oelprinz-org/BlitzboxBL49sp/software/202402.1/README.md

### Corrected firmware as there was a bug in pin definition for boost output<br/>
<br/>
will be corrected in next official speeduino firmware.<br/>
Until then you can use this precompiled firmware from here.<br/>
