oelprinz-org/BlitzboxBL49sp/documentation/wiki/images/mainconnector.jpg

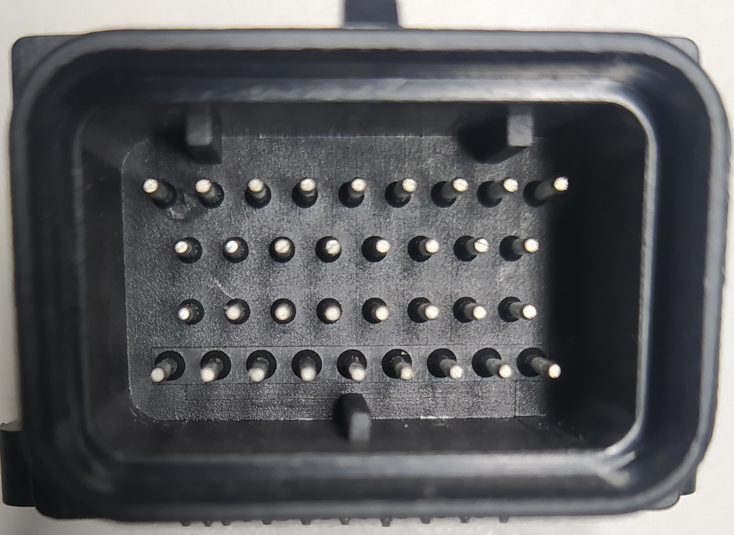
documentation/wiki/images/mainconnector.jpg
