oelprinz-org/BlitzboxBL49sp/documentation/wiki/images/pinheader1.jpg

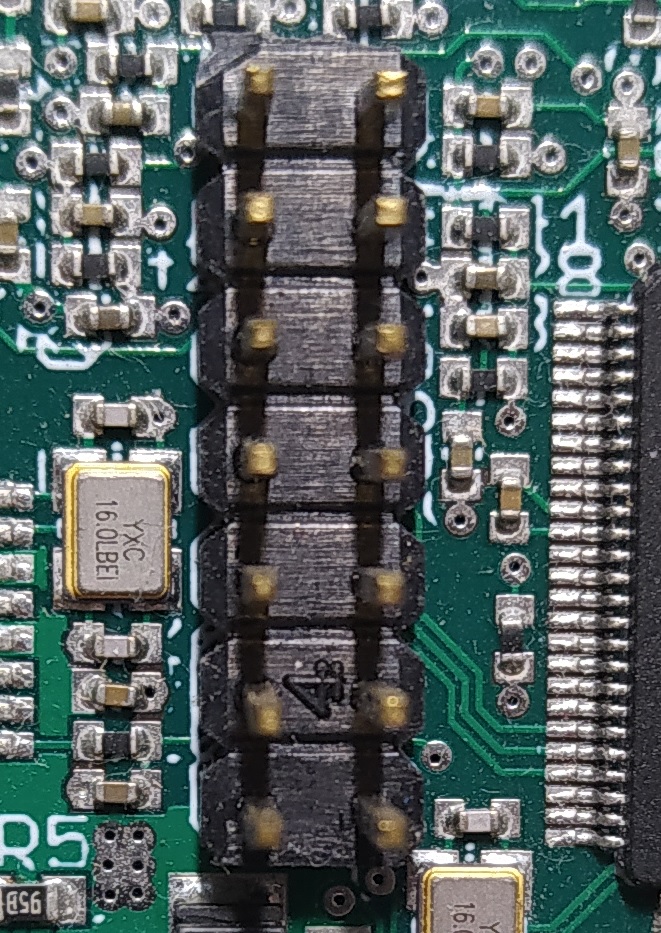
documentation/wiki/images/pinheader1.jpg
