oelprinz-org/BlitzboxBL49sp/documentation/wiki/images/pinheader2.jpg

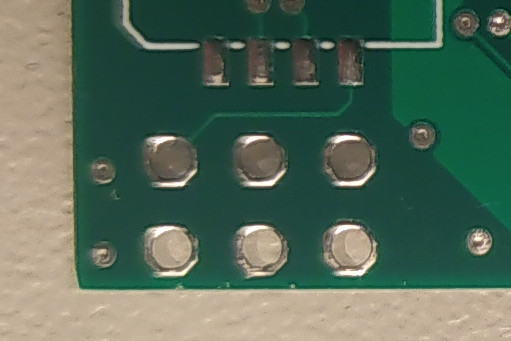
documentation/wiki/images/pinheader2.jpg
