oelprinz-org/BlitzboxBL49sp/hardware/Rev0.0.4a/2020-08-18_15-27-23_BlitzboxBL49sp-master_.png

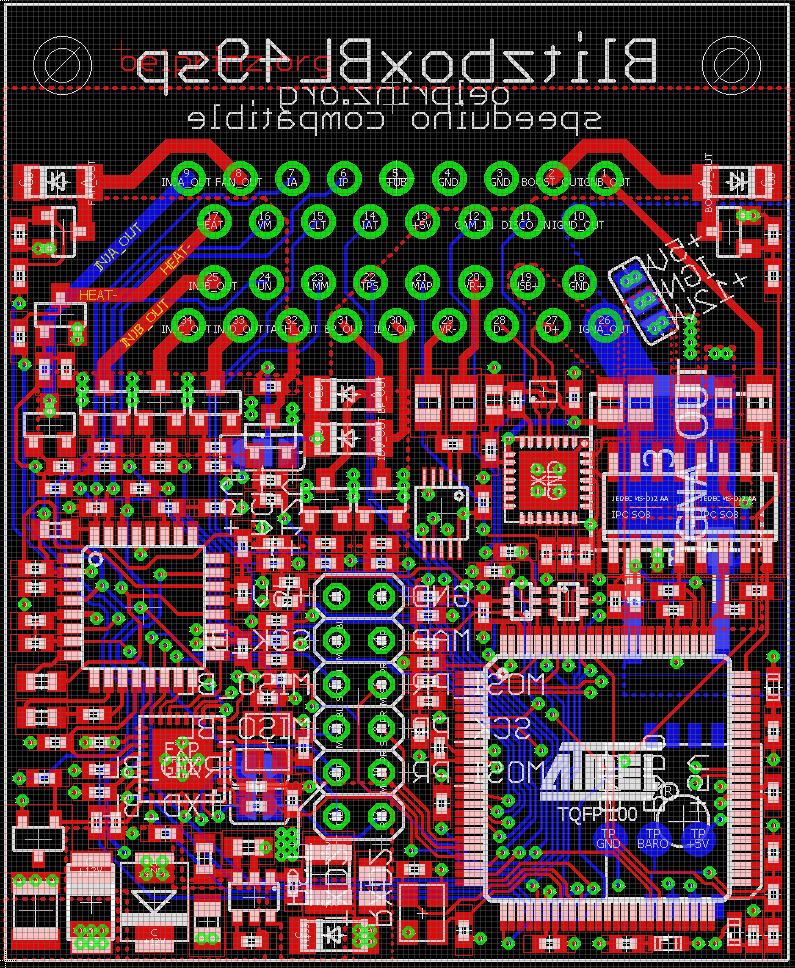
hardware/Rev0.0.4a/2020-08-18_15-27-23_BlitzboxBL49sp-master_.png
