oelprinz-org/BlitzboxBL49sp/hardware/Rev0.0.4b/2020-08-26_13-27-23_BlitzboxBL49sp-master_.png

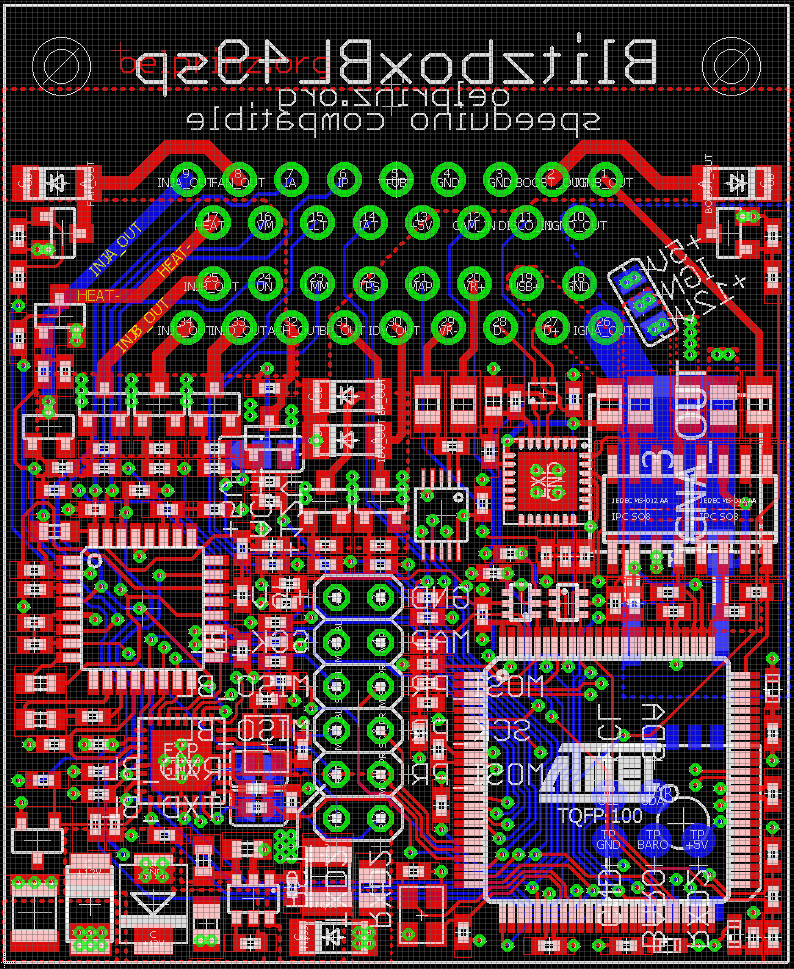
hardware/Rev0.0.4b/2020-08-26_13-27-23_BlitzboxBL49sp-master_.png
