oelprinz-org/BlitzboxBL49sp/hardware/Rev0.0.4c/2020-08-30_21-38-23_BlitzboxBL49sp-master_.png

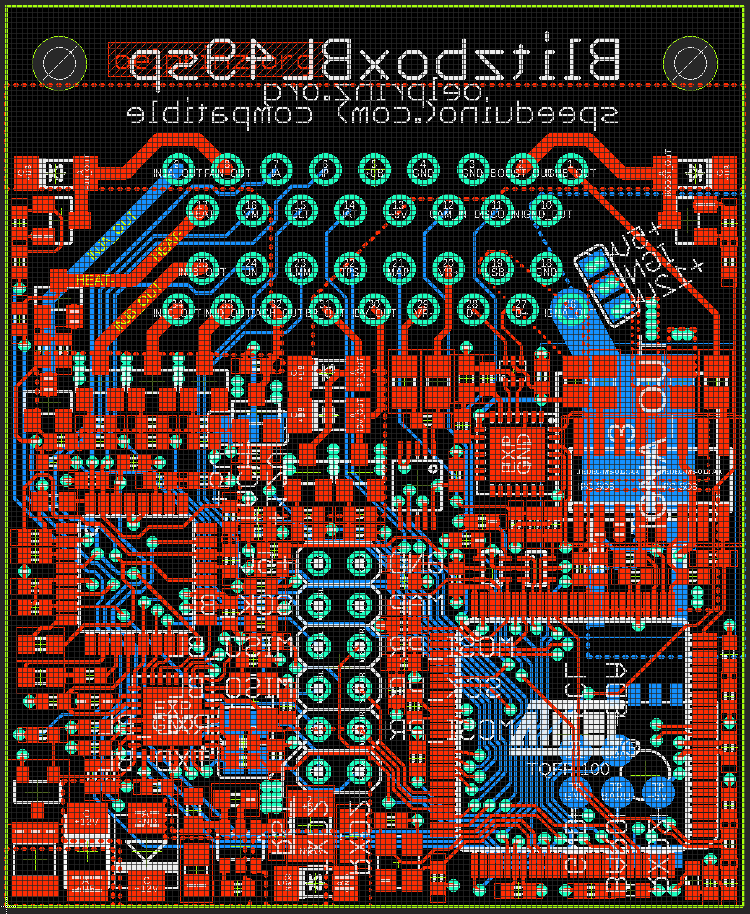
hardware/Rev0.0.4c/2020-08-30_21-38-23_BlitzboxBL49sp-master_.png
