oelprinz-org/BlitzboxBL49sp/case/blitzbox_gehäuse_2.stl

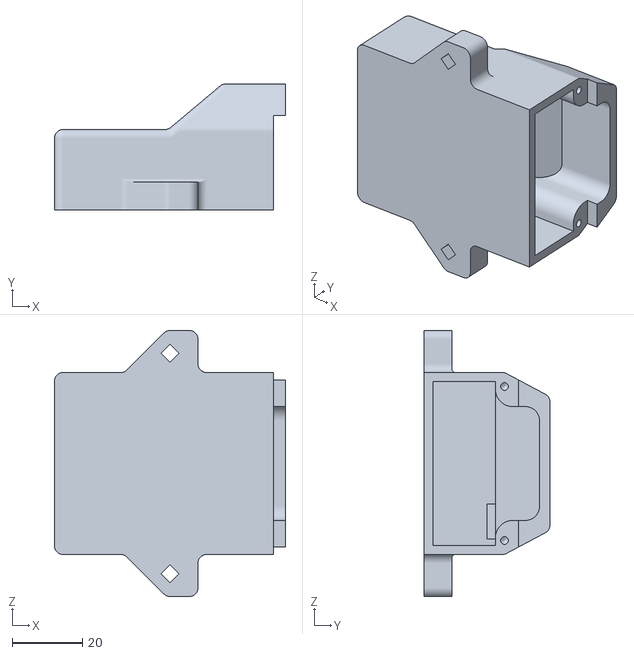
[picture p18: CAD file, 2023-03-01]
case/blitzbox_gehäuse_2.stl
66.0 x 36.0 x 76.0
