oelprinz-org/BlitzboxBL49sp/case/blitzbox_blech_2.stl

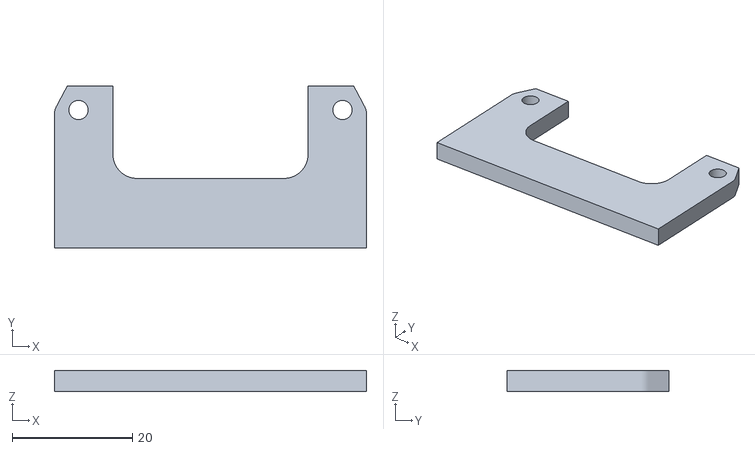
[picture p19: CAD file, 2023-03-01]
case/blitzbox_blech_2.stl
52.0 x 27.0 x 3.50
