oelprinz-org/BlitzboxBL49sp/case/bl_deckel_2.stl

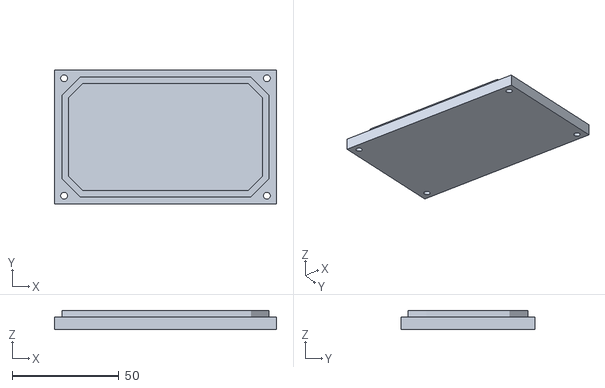
[picture p20: CAD file, 2023-03-01]
case/bl_deckel_2.stl
104.0 x 63.0 x 9.00
