oelprinz-org/BlitzboxBL49sp/case/bl_gehäuse_2.stl

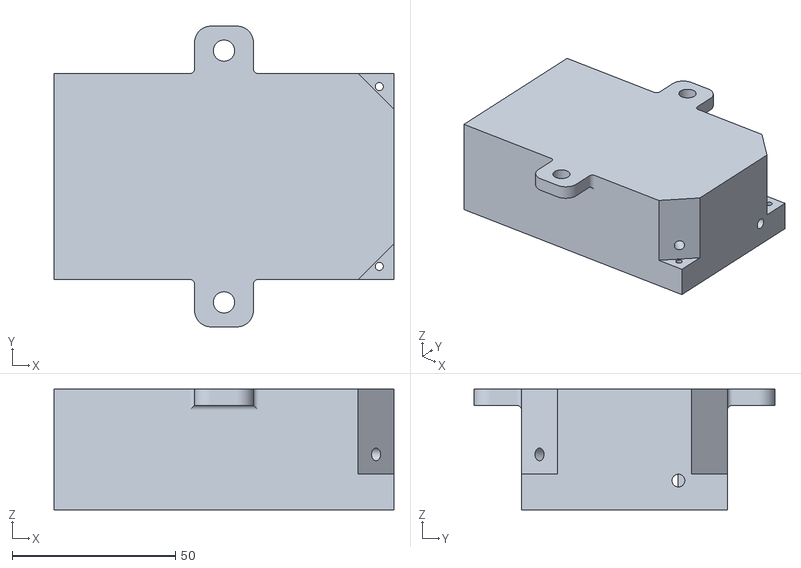
[picture p21: CAD file, 2023-03-01]
case/bl_gehäuse_2.stl
104.0 x 92.0 x 37.0
