oelprinz-org/BlitzboxBL49sp/(threads)

Thread 1 (2020-09-27):

Capacitor C29 too large in V0.0.6

chaoschris, 2020-09-27:
Capacitor C29 has been chosen too large in V0.0.6 (100nF).
For this reason ISP will not work on the Atmega2560. ISP on Atmega328P is working fine with this value.
Will be replaced with 18 pF in next version.

chaoschris, 2020-09-30:
Fixed in V0.0.7

chaoschris, 2020-09-30:
Can be fixed in V0.0.6 with a smaller capacitor like 18 pF or simply remove C29

Closed 2020-09-30.

Thread 2 (2020-11-27):

any updates?

rusefillc, 2020-11-27:
Are there any forum threads/build threads with updates? How is it going?

chaoschris, 2020-12-23:
the only forum thread to this device is on the speeduino forum:
http://speeduino.com/forum/viewtopic.php?f=16&t=2900
But there is not really more information than here...

Closed 2021-07-14.

Thread 4 (2022-04-25):

[temporary solved] V 0.1.2 pcb routing issue on TPS

chaoschris, 2022-04-25:
V0.1.2 has a pcb routing issue on TPS signal.
Can be fixed manually and will be corrected in next/final version

chaoschris, 2022-08-26:
solved in V0.1.3

Closed 2022-08-26.

Thread 5 (2022-04-25):

[temporary solved] V 0.1.2 speeduino firmware stops working when pulling the USB plug

chaoschris, 2022-04-25:
V 0.1.2 speeduino firmware stops working when pulling the USB plug.
With the USB plug connected all works fine

SW65, 2022-04-25:
Und was haben die als Lösung?

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

chaoschris, 2022-04-25:
Shutting down the power supply of the Cp2102 converter chip leads to a constant voltage level of 0 V on the RX line of the Atmega2560. This can be fixed temporary with a 10k Pullup from RX to +5V as shown in the picture. Further investigation will follow soon before the next/final pcb revision.
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

SW65, 2022-04-25:
Lösung ist halt ohne Zigarettenanzünder mit usb Kabel und kleiner:-)
Liegt nicht an der Firmware?

Melde mich später mal .

Grüße Jörg

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

chaoschris, 2022-04-25:
Doesn't look like a firmware issue. The original Arduino Mega 2560 design also has two inline resistors with 1K on RX and TX. Will have a deeper look on this later.

chaoschris, 2022-08-26:
solved in V0.1.3

chaoschris, 2022-08-26:
solved in V0.1.3

Closed 2022-08-26.

Thread 6 (2023-02-28):

Would it be possible to get a "how to order" guide?

runesmdk, 2023-02-28:
I've tried uploading the 0.1.4 to jlcpcb, and both the bom and the cpl, but i get so many errors i cannot order it. I must be doing something wrong ofcourse, but i'm no whiz in the world of PCB. Is it possible to get a step-by-step helping hand in ordering it?

chaoschris, 2023-02-28:
done in the speeduino forum:
https://speeduino.com/forum/viewtopic.php?p=61556#p61556

runesmdk, 2023-03-01:
I dont know how i missed that. But what is missing with r21,r23, r40 and ic3, is that only the wideband controller with the cj125 or are other systems affected as well?

chaoschris, 2023-03-01:
You don't missed it, i made it specially for you... ;-) . But this information could be also useful for others, so i decided to publish it on the forum.
R21 is a pullup and optional. This is the wire which enables the heating of the Lambda sonde via programmable output.
R23 is a Varistor which should be added manually. JLC has nothing in stock to solder on here
R40 a optional BIAS resistor if you decide to use the analog input ADD_LMM with a temperature sensor
IC3 is the Wideband Bosch CJ125 (30522, 30615 or 40103). Must be soldered by hand as JLC cannot provide it for assemby

runesmdk, 2023-03-01:
I am very honered, thank you. How will it heat without the pullup, just always on?
Where do you buy the CJ125?

chaoschris, 2023-03-01:
The lambda controller will be enabled with a ground signal. you have to program this this feature with a rule in TunerStudio (programmable outputs). You can define two conditions here. one would be RPM greater than XXX and/or engine temperature greater than YY. Both conditions also allow to define an additional time delay.

chaoschris, 2023-03-01:
I am buying the CJ125 always in China or unsolder them from old parts/ECUs......  ;-)
Bosch 30522 is working fine and should be easy to find and also cheap

Closed 2023-03-14.

Thread 7 (2023-03-16):

stepper idle motor

Giulio-Luiz-Valcanaia, 2023-03-16:
First thing: congratulations on the project, it is really good. Second thing: Any chance of adding stepper motor support?

chaoschris, 2023-03-16:
There ist absolutely no space  top add stepper support on this board. If you really need a stepper you can use the upcoming Gewitterbox design here in our GitHub repository when it is ready for production some day.

Ricardo29410, 2023-03-20:
Hello, a pleasure Ricardo Rodríguez I'm from Venezuela and your plate
really catches my attention and I want to try both models

El dom, 19 de mar. de 2023 4:17 p. m., chaoschris ***@***.***>
escribió:

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

Closed 2023-03-19.

Thread 9 (2023-09-08):

Missing wideband controller?

abreumatheus, 2023-09-08:
Hi, first thank you for your amazing work on this.
I noticed the bosch wideband controller chip is missing on the bom.
Is it ok to order it sepparetly and solder it by hand?

Greetings from Brazil.

chaoschris, 2023-09-08:
Ola Matheus,
JLC nao vai soldar este CJ125 na placa pq eles nao oferece algumes partes especial, mesmo se era possivel de comprar as pecas anterior. Entao vc tenho de soldar este peca....
Um abraco
Chris

abreumatheus, 2023-09-08:
Thank you for the heads up!
Muito obrigado! 😁

Closed 2023-09-08.

Thread 10 (2023-09-13):

What board to select in tunerstudio?

runesmdk, 2023-09-13:
There's no blitzbox in the dropdown menu of boards

chaoschris, 2023-09-13:
Hi Rune,
You must use the modified speeduino.ini from

https://github.com/oelprinz-org/BlitzboxBL49sp/tree/master/software/202305/changes/speeduino.ini
or
https://github.com/oelprinz-org/BlitzboxBL49sp/tree/master/software/202305/reference/speeduino.ini

both are the same

Best regards,
Chris

runesmdk, 2023-09-13:
Thank you. How to upload the firmware when it comes in hex and bin format?
I usually just use speedyloader :D

Den ons. 13. sep. 2023 kl. 09.18 skrev chaoschris ***@***.***
>:

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

chaoschris, 2023-09-13:
There is no way to upload it with the speedyloader until the blitzbox will be added to the official firmware tree. But also when this is done you need to upload a bootloader in your 2560. So for the moment you need a tool to upload the firmware manually. You can do this with any tool of your choice like usbasp, tinyisp or any cheap arduino board acting as a ISP.

chaoschris, 2023-09-13:
You also need to program the 328p for the lambda controller the same way, so you will really need one of these really cheap programmers. I prefer the usbasp and AVRDUDESS as GUI which is really easy to handle and also works well
https://blog.zakkemble.net/avrdudess-a-gui-for-avrdude/

runesmdk, 2023-09-13:
Okay. I will have to dig into this, never tried it. Have an external wideband controller, so gonna have a look at available pins in the init. When and how does the fuse-programming work, is that while using the isp programmer?

chaoschris, 2023-09-13:
Yes, you can do these settings easily with the same tools you are using to flash the MCU.
Have a look on the Homepage of AVRDUDESS at https://blog.zakkemble.net/avrdudess-a-gui-for-avrdude/  .
There is a picture of the GUI, with this tool it is really easy-going to program the MCUs.
If you don't want to spend 2 or 3 dollars for a programmer you can use any available Arduino Board and use it as a ISP programmer. There is plenty of information on the web how to do this,one example here:
https://docs.arduino.cc/built-in-examples/arduino-isp/ArduinoISP

chaoschris, 2023-09-26:
Best practice would be to flash the entire flash with the included bootloader:
ttps://github.com/oelprinz-org/BlitzboxBL49sp/blob/master/software/202305/blitzboxBL49sp_firmware_speeduino-202305_with_bootloader.bin
or
https://github.com/oelprinz-org/BlitzboxBL49sp/blob/master/software/202305/blitzboxBL49sp_firmware_speeduino-202305_with_bootloader.hex

chaoschris, 2023-09-26:
You are talking about the 2560 or the 328P for the lambda?

runesmdk, 2023-09-26:
> You are talking about the 2560 or the 328P for the lambda?
2560. But i managed to get it working, wrote a how-to on how i did on the speeduino forum.

Closed 2023-10-11.

Thread 11 (2023-10-05):

RC/ UAV engine compatibility

professor-jonny, 2023-10-05:
Hi I'm wondering if this could be project could be adapted to accept a 0-5v 50hz PWM input as an electronic throttle and provide a 0-5v 50hz PWM output the same for throttle position control by simply repurposing inputs and outputs without major board changes?

The usage would be used accept a RC throttle control PWM input from the transmitter and provide a PWM output to control the throttle servo.
This would negate the need for TPS as we know the position, it would be otherwise impractical to provide this signal as it would be hard to find of the shelf throttle components suitable for RC/ UAV engine sizes.

In normal cases it would pass through the throttle servo signal direct to the digital servo controlling the throttle, but if comms were lost it would set a pre-determined throttle position for safety or kill the engine.

Would you be at some stage manufacturing / selling this as a kit?

chaoschris, 2023-12-12:
Hello professor-jonny,
unfortunately the project is published as it is and there are no plans to change it in any way. There also wouldn't be no place on the pcb for your planned modifications.
All the needed files for manufacturing are published in the folder "fabrication" and it is easy for everyone to let them build by your preferred manufacturer.
There is also no intention to sell it in any commercial way.

chaoschris, 2023-12-12:
closed as there are no plans to change it in any way

Closed 2023-12-12.

Thread 13 (2024-04-24):

PN of MainConnector

Marcelocm1995, 2024-04-24:
Hi, I'm doing this project and I need de part number or link to buy the MainConnector, I did not found inside documentation.

Best Regards

chaoschris, 2024-04-25:
Ola Marcelo,

todas as informacoes que vc precisa vc vai encontrar no blogue/forum do speeduino:
https://speeduino.com/forum/viewtopic.php?p=61573#p61573

Para completar o conector este pagina ai pode ajudar:   http://www.oelprinz.org/products/BlitzboxBL49sp/documentation/V0.1.4/wiki/pinout_V0.1.4_Connector_top_side.html

Vc pode me respostar em portugues tambem, e sem pro para mim....

Marcelocm1995, 2024-04-25:
Que legal, parabens pelo projeto. E muito obrigado! Vc poderia me passar algum contato caso aceite um trabalho freelancer? Tenho uma demanda.

Grato

chaoschris, 2024-04-25:
Infelizmente esto uma pessoa privada e nao uma compania......

chaoschris, 2024-05-07:
Ola Marcelo, voce pode conferir os fuses?

No 2560 tenho de ser:
L   0xFF
H   0xD8
E   0xFD
LB  0xCF

e no 328p:
L   0xFF
H   0xDA
E   0xFD
LB  0xCF

Marcelocm1995, 2024-05-07:
Acabei de conseguir! Fazendo o seguinte:

Via Silabs integrado eu fiz um jumper entre VBUS e 5V.

Curioso via RXD TXD com FTDI nao ir, irei colocar um modulo bluetooth para testar. Seria o HC-05?

chaoschris, 2024-05-07:
>> Seria o HC-05?
Normalmente todos os modulos BT que tenho serial vai funcionar se vc vai configurar eles antes para 115200....

Marcelocm1995, 2024-05-07:
Entendi, muito obrigado. Irei comecar a testar com o TunerStudio

Closed 2024-05-07.

Thread 14 (2024-05-09):

Crank and cam input

runesmdk, 2024-05-09:
Straight from jlcpcb, is crankshaft then ready for vr or hall? What mods to swap sensor type on crank? And same for cam, what sensortype, and what mods to swap sensor type?

chaoschris, 2024-06-25:
With the soldered max9926 both inputs are ready for vr signals. In my opinion VR is the most common solution for crankshaft and the max9926 is one of the best solutions on the market for vr signals.

Camshaft input is mostly a square hall signal. But in this configuration the camshaft input can handle very well a single hall signal every 720 degrees.
- For 5V Hall input VR- should go to GND.
- If you have a 12V Hall Signal, it would be a good point to start with +5V on VR- . There is a soldering bridge on the board to do this (SJ5).

The same wiring you can apply on the crankshaft input if you want to use hall input WITH the soldered MAX9926. But here you don't have a soldering bridge onboard and you have to wire it externally or direct on the board which is easy to do.

chaoschris, 2024-08-30:
closed

Closed 2024-08-30.

Thread 15 (2024-07-22):

Launch Control doesn't work

chaoschris, 2024-07-22:
Launch Control (DISCO_IN) doesn't work.
This is a pulldown Switch to GND and for this feature going to work you need to switch R20 and R29 on the PCB.
R20 10K --> 1K
R29  1K --> 10K
Will be changed soon in manufacturing files.

chaoschris, 2024-07-23:
now fixed in schematics and BOM

chaoschris, 2024-08-30:
closed

Closed 2024-08-30.

Thread 16 (2024-07-25):

Pin definition for boost out wrong in speeduino firmware

chaoschris, 2024-07-25:
Unfortunately the pin definition for boost out is wrong in actual speeduino firmware.
This will be corrected in next official speeduino firmware.
Until then you can use the corrected firmware from:
https://github.com/oelprinz-org/BlitzboxBL49sp/tree/master/software/202402.1
If you don't use the boost out pin there is no need to change anything.

chaoschris, 2024-08-30:
fixed in next official firmware release

chaoschris, 2024-08-30:
closed

Thread 17 (2025-06-04):

Assistance with Ordering Assembled PCBs

jham4x4, 2025-06-04:
Stumbled across your build and think it would be a great ecm for a Suzuki Samurai EFI conversion I'm working on.  PCBs are new to me and I wanted to solicit your assistance with ordering assembled boards from PCBWay.  I dont know if its as simple as uploading the GBRL, bom and cpl and they do the rest.
