oelprinz-org/BlitzboxBL49sp/hardware/Rev0.1.9/blitzbox_v0.1.9.pdf

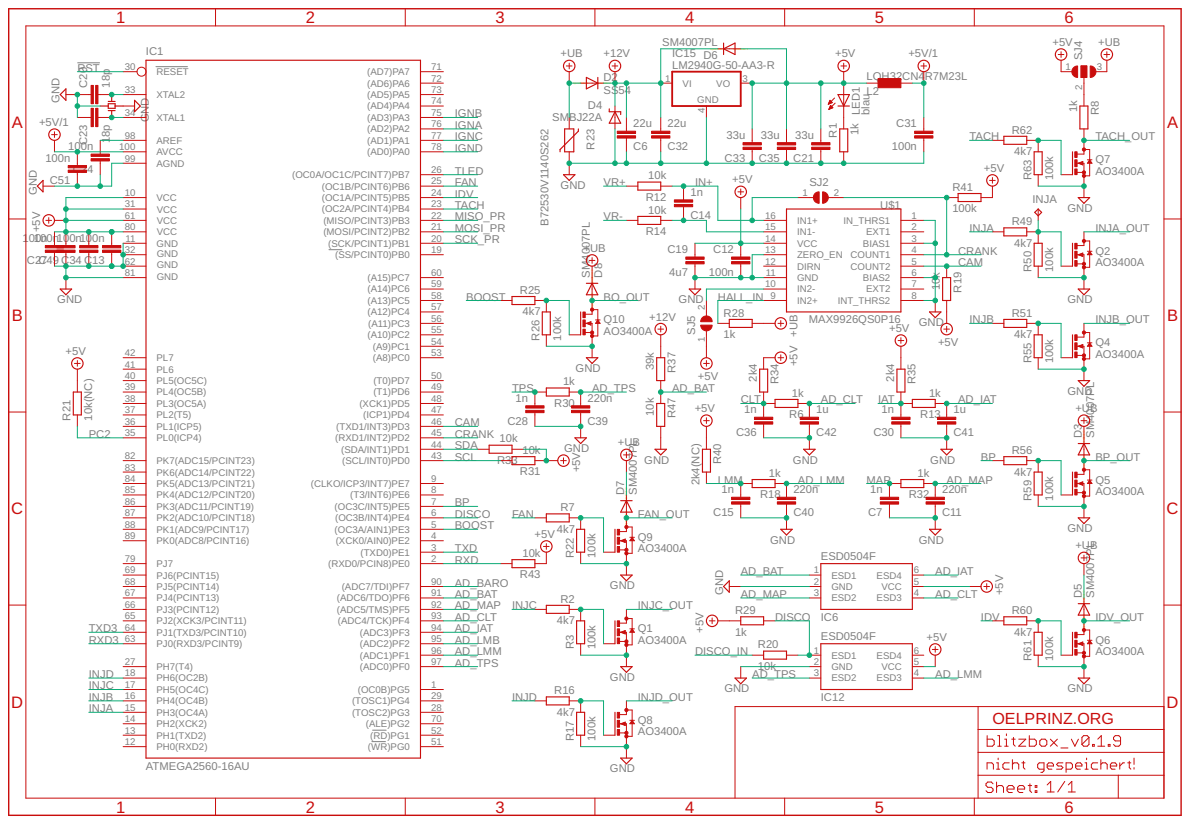
[picture p22: page 1]

SpiceOrder 1 SpiceOrder 2
BP_OUT

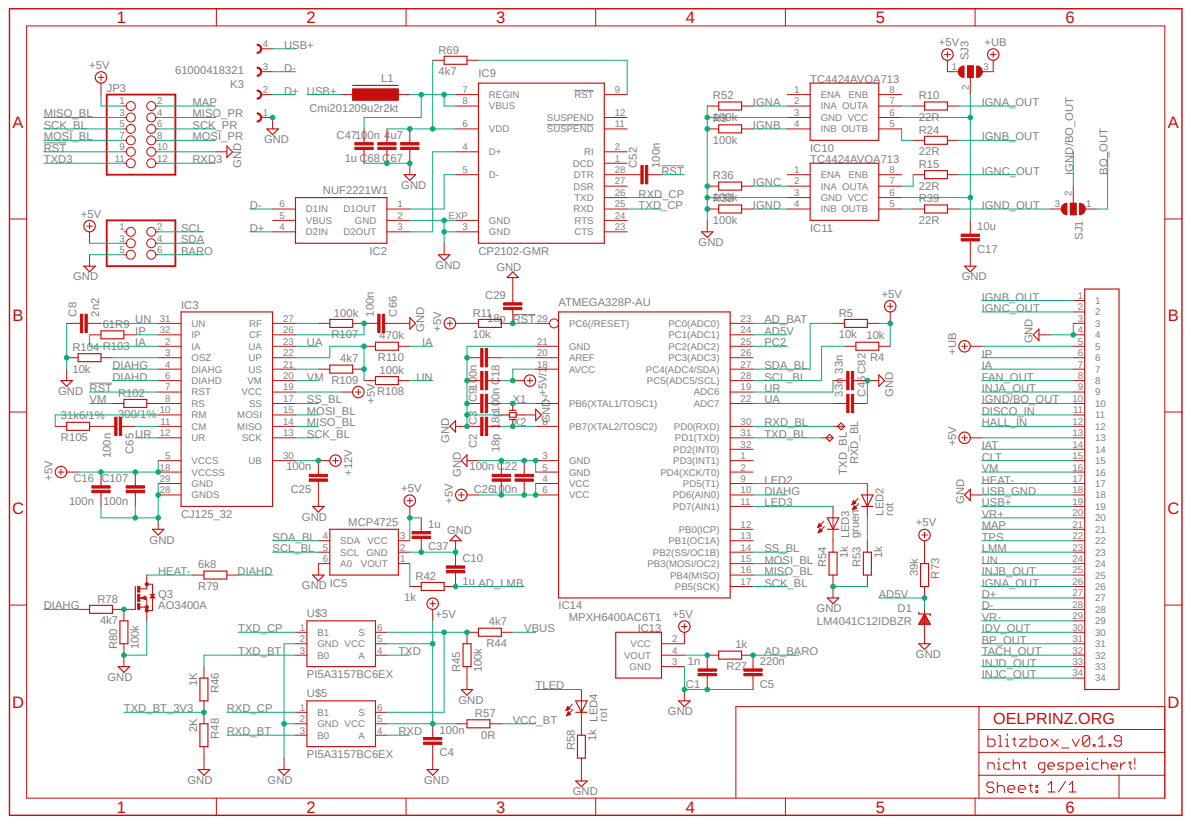
[picture p23: page 2]
