oelprinz-org/BlitzboxBL49sp/hardware/Rev0.1.8/schematics_blitzbox_v0.1.8.pdf

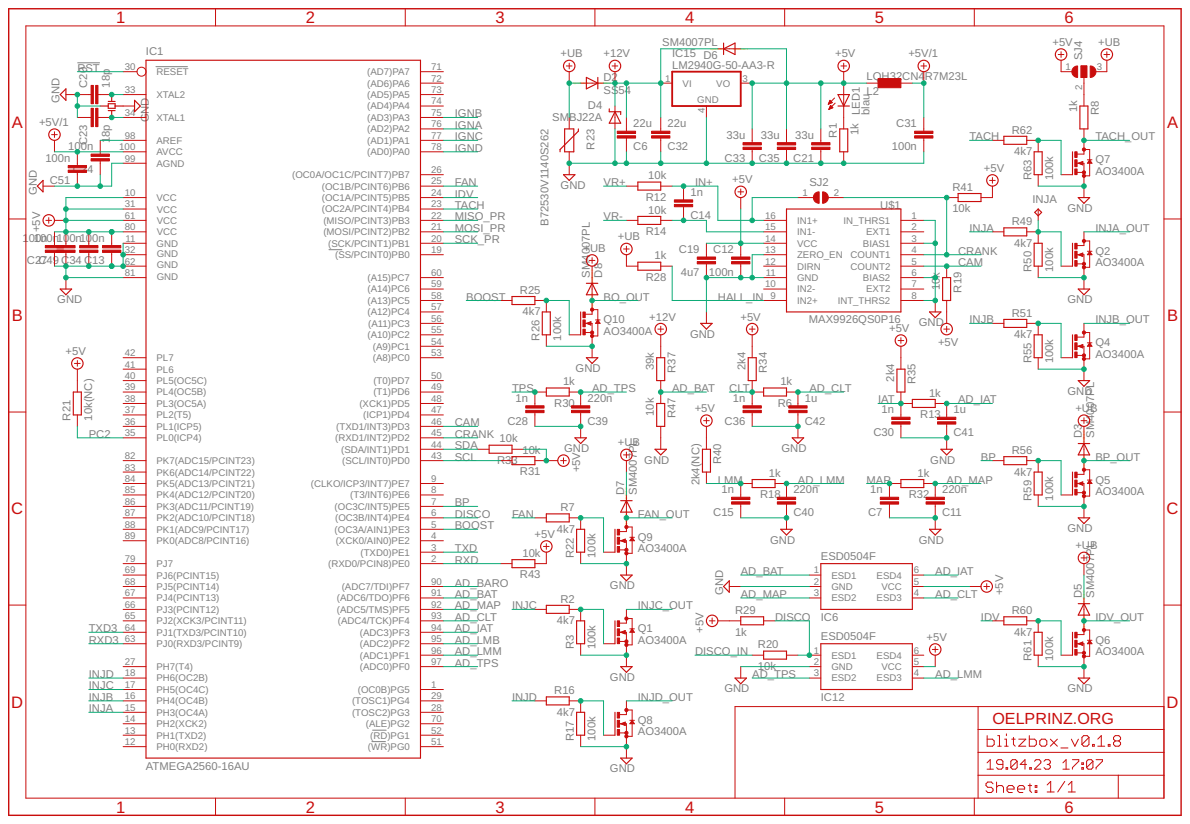
[picture p24: page 1]

SpiceOrder 1 SpiceOrder 2
BP_OUT

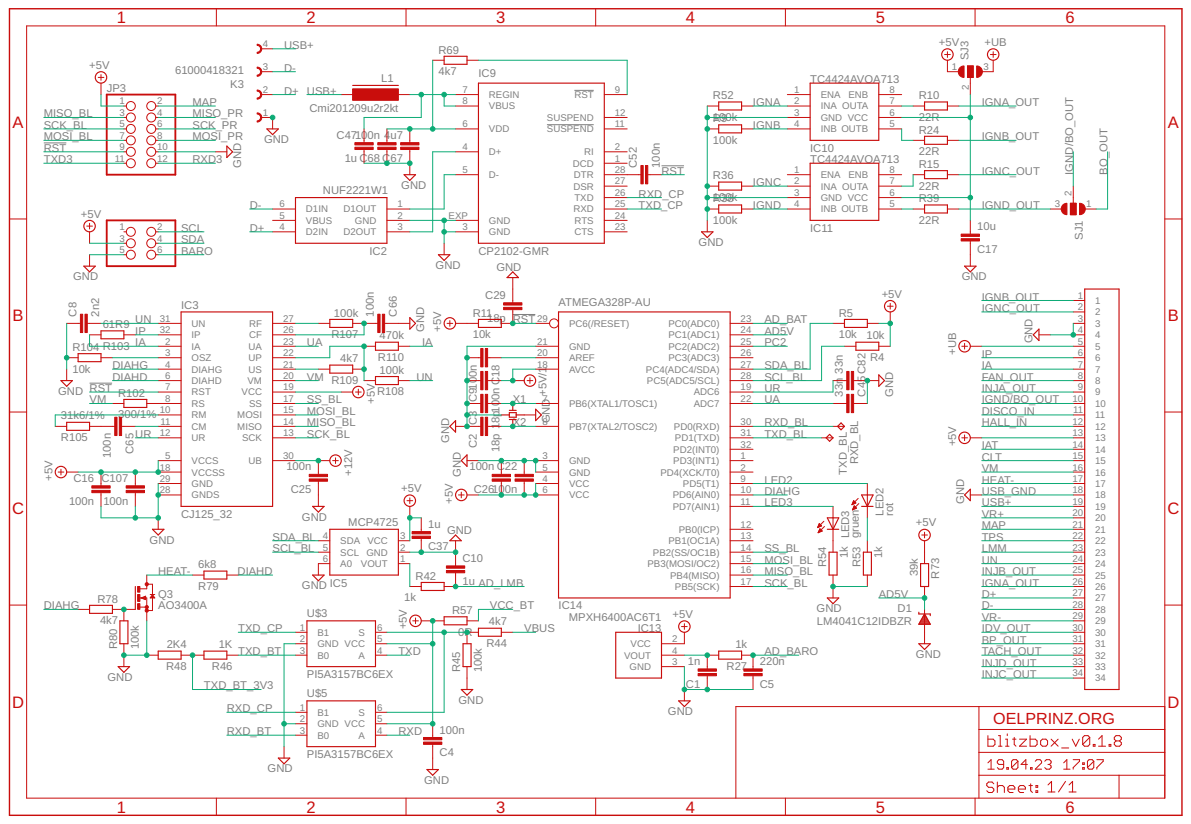
[picture p25: page 2]
