oelprinz-org/BlitzboxBL49sp/hardware/Rev0.1.7/schematics_blitzbox_v0.1.7.pdf

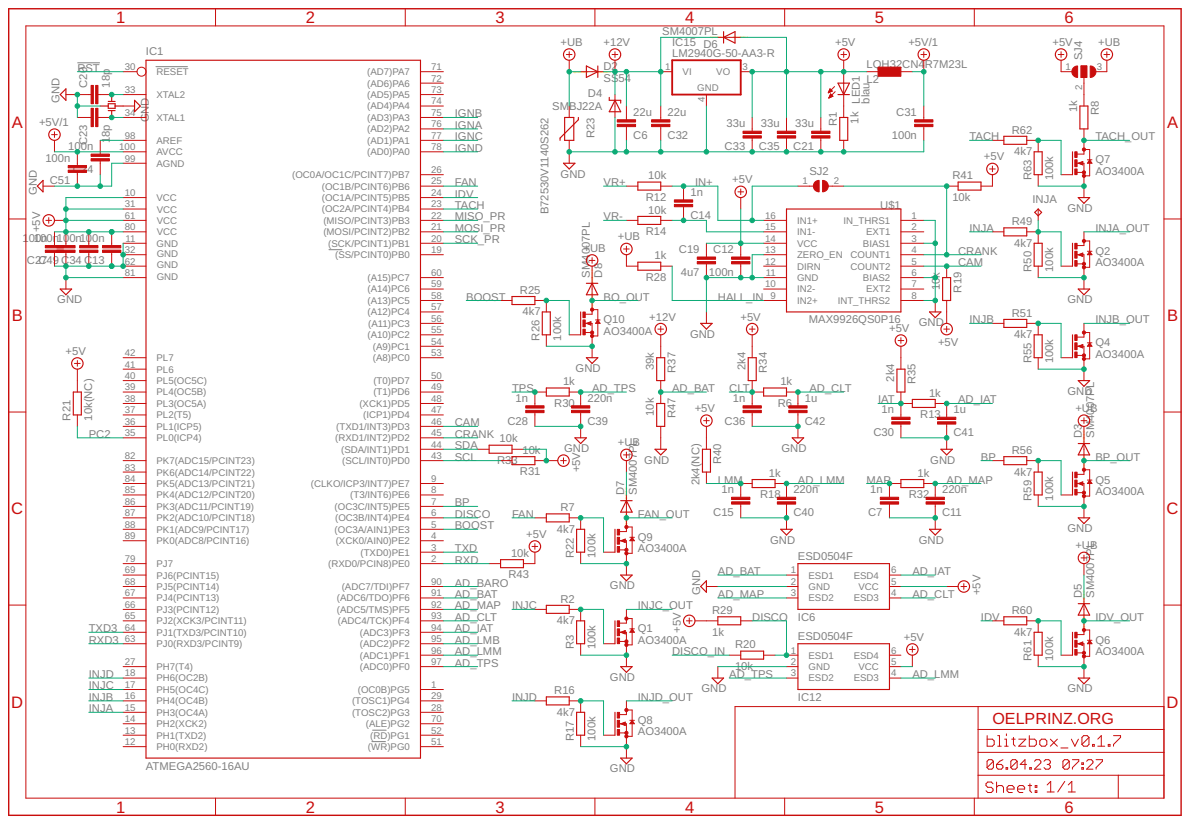
[picture p26: page 1]

SpiceOrder 1 SpiceOrder 2
BP_OUT

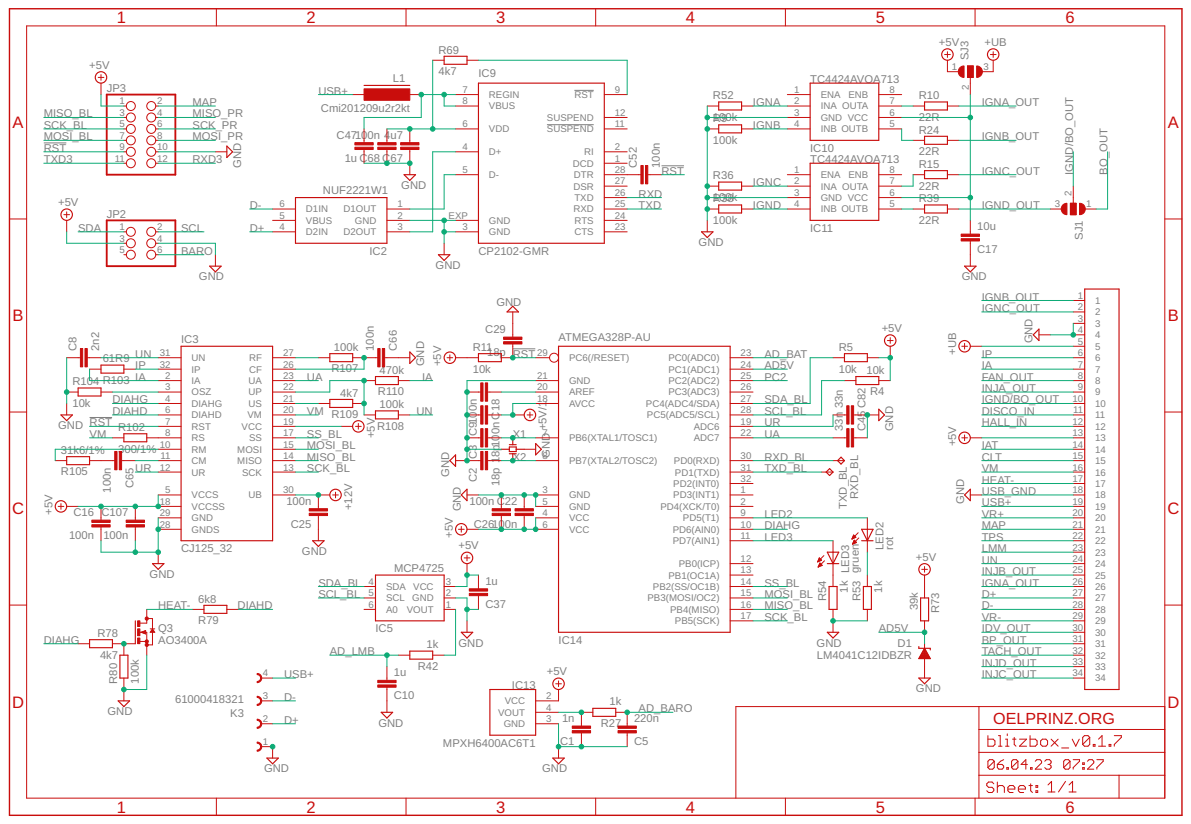
[picture p27: page 2]
