oelprinz-org/BlitzboxBL49sp/hardware/Rev0.1.6/schematics_blitzbox_v0.1.6.pdf

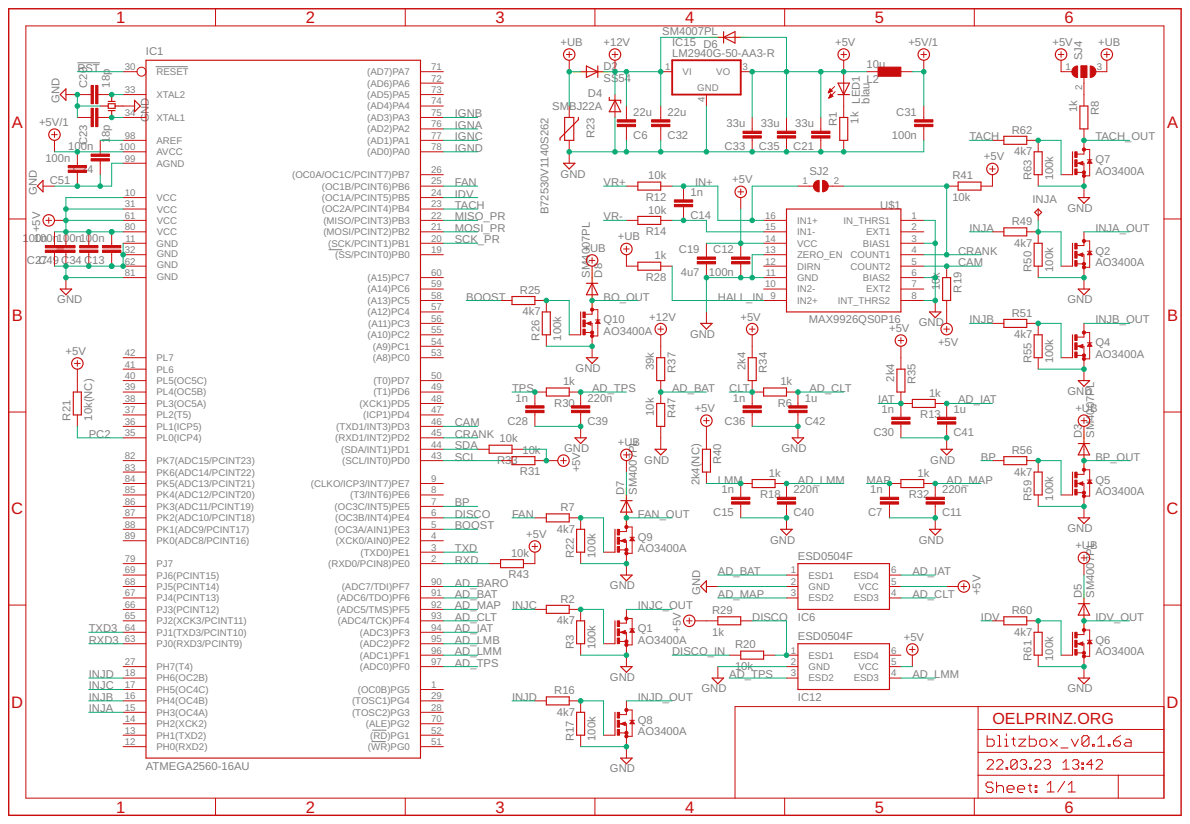
[picture p28: page 1]

SpiceOrder 1 SpiceOrder 2
BP_OUT

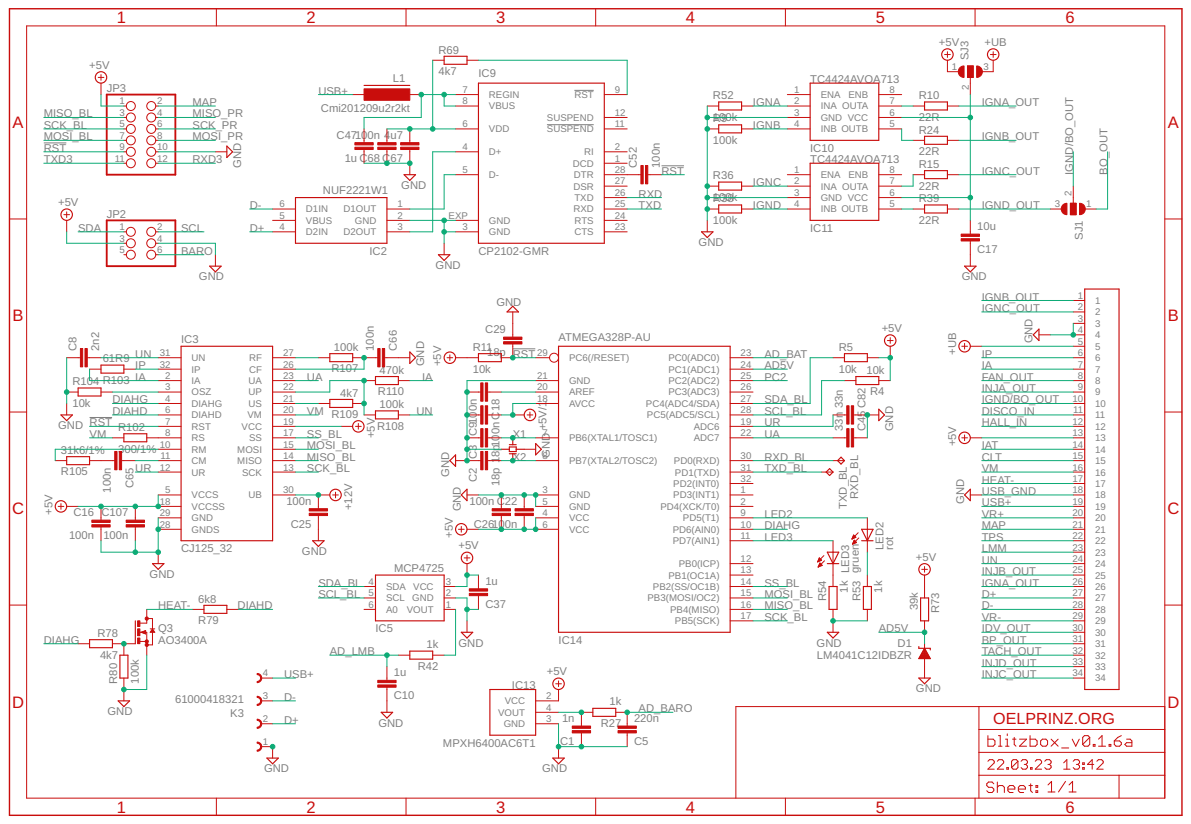
[picture p29: page 2]
