oelprinz-org/BlitzboxBL49sp/hardware/Rev0.1.5/schematics_blitzbox_v0.1.5.pdf

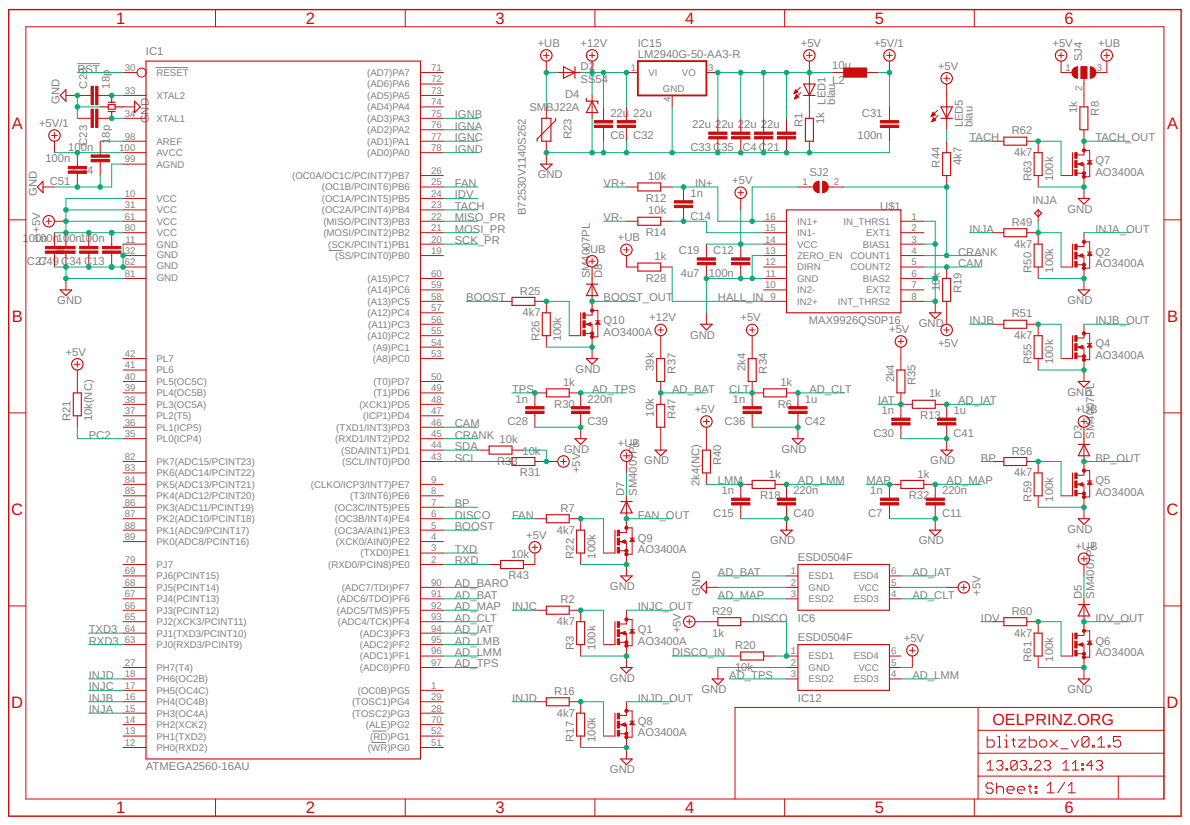
[picture p30: page 1]

SpiceOrder 1 SpiceOrder 2
BP_OUT

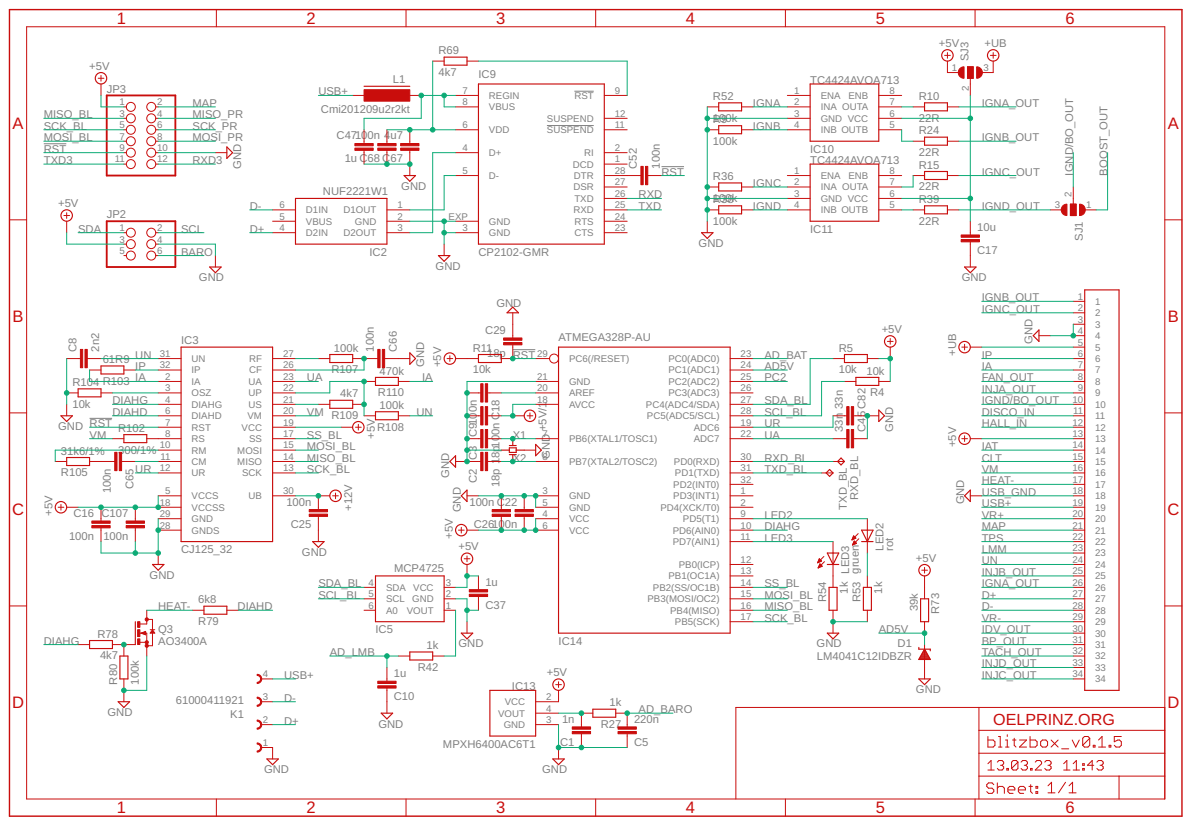
[picture p31: page 2]
