oelprinz-org/BlitzboxBL49sp/hardware/Rev0.1.4/schematics_blitzbox_v0.1.4.pdf

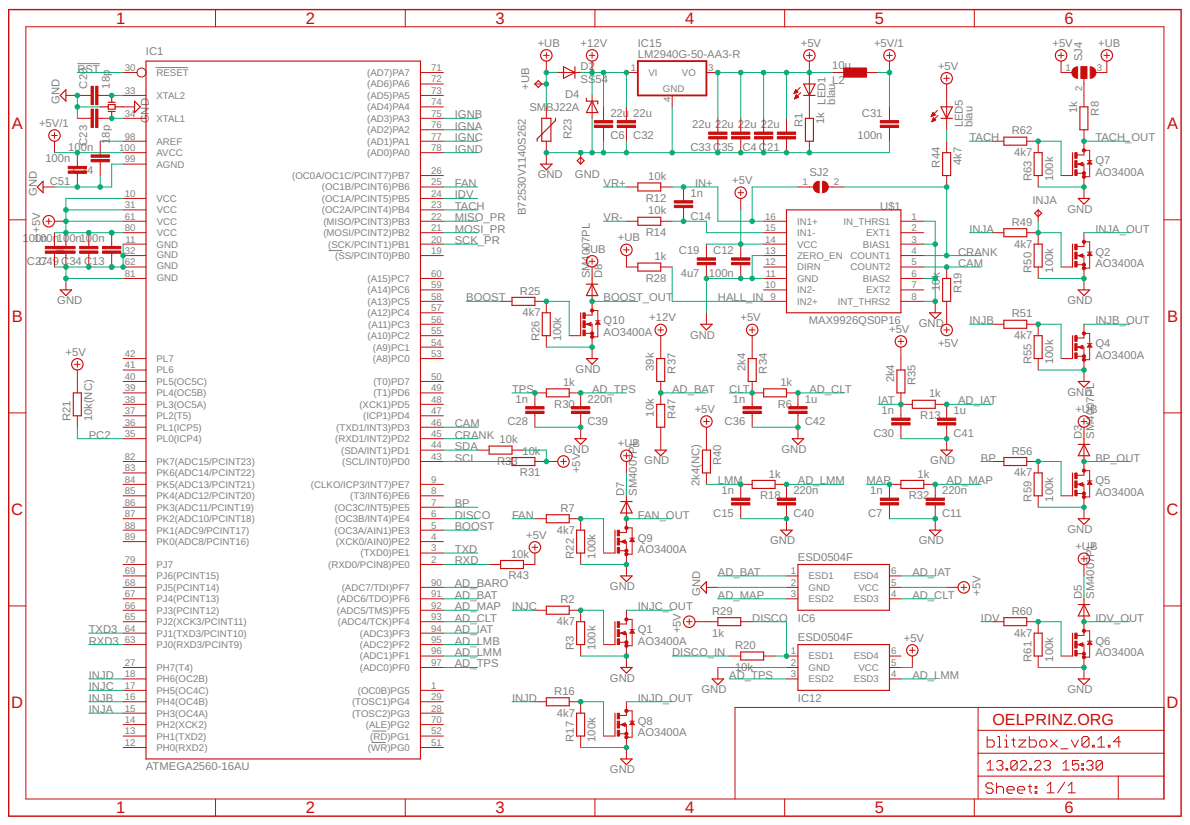
[picture p32: page 1]

SpiceOrder 1 SpiceOrder 2
BP_OUT

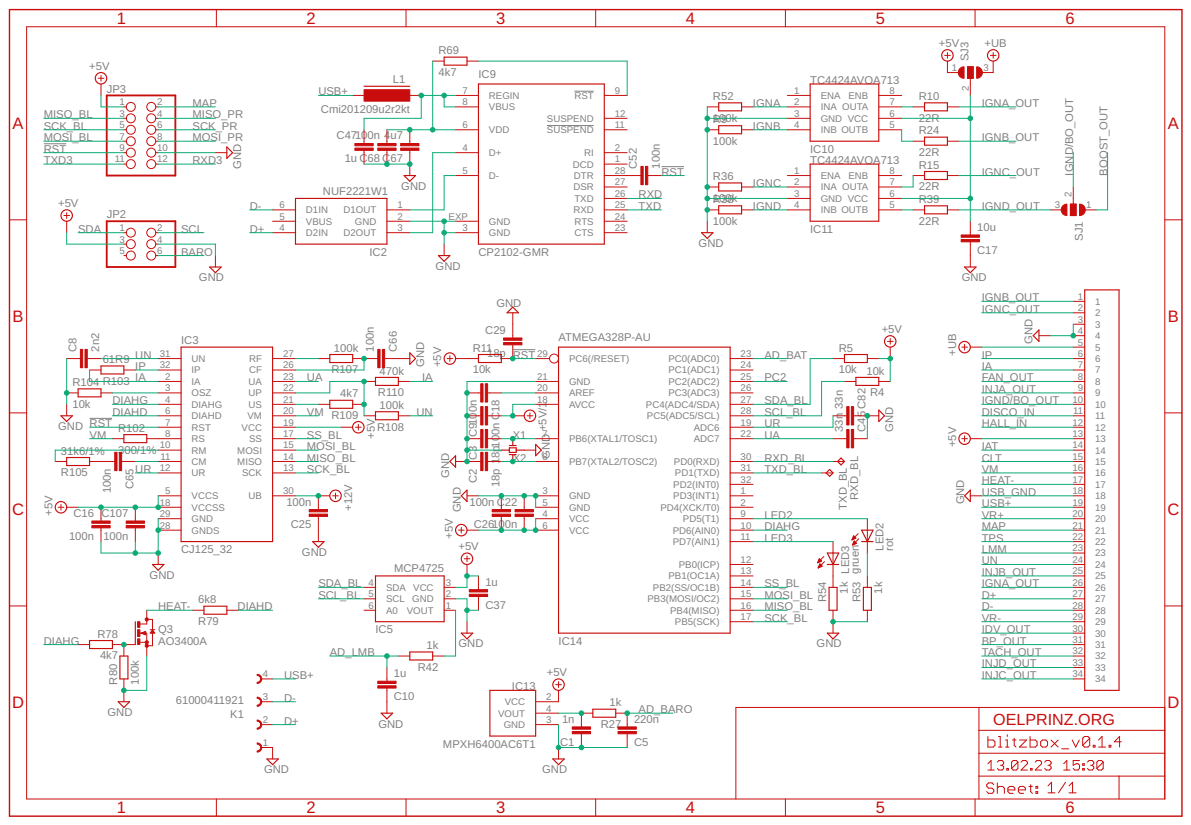
[picture p33: page 2]
