oelprinz-org/BlitzboxBL49sp/hardware/Rev0.1.3/schematics_blitzbox_v0.1.3.pdf

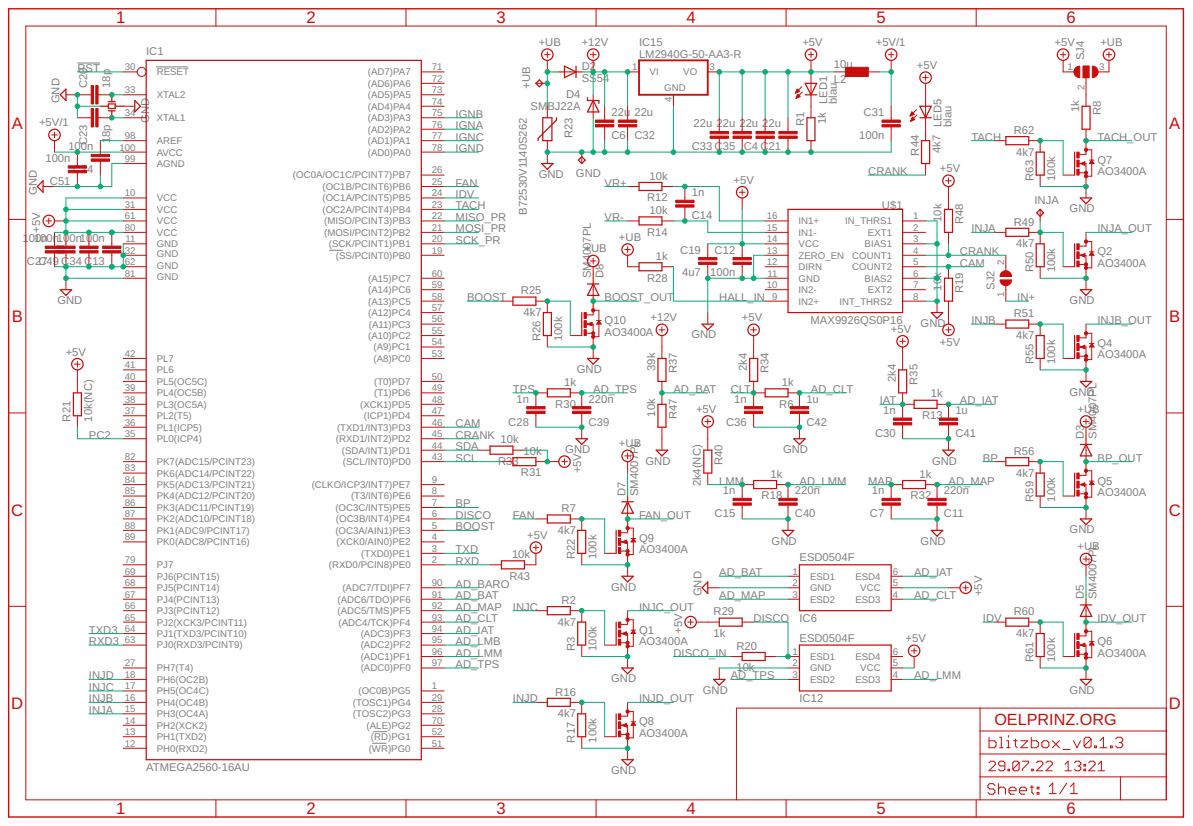
[picture p34: page 1]

SpiceOrder 1 SpiceOrder 2
BP_OUT

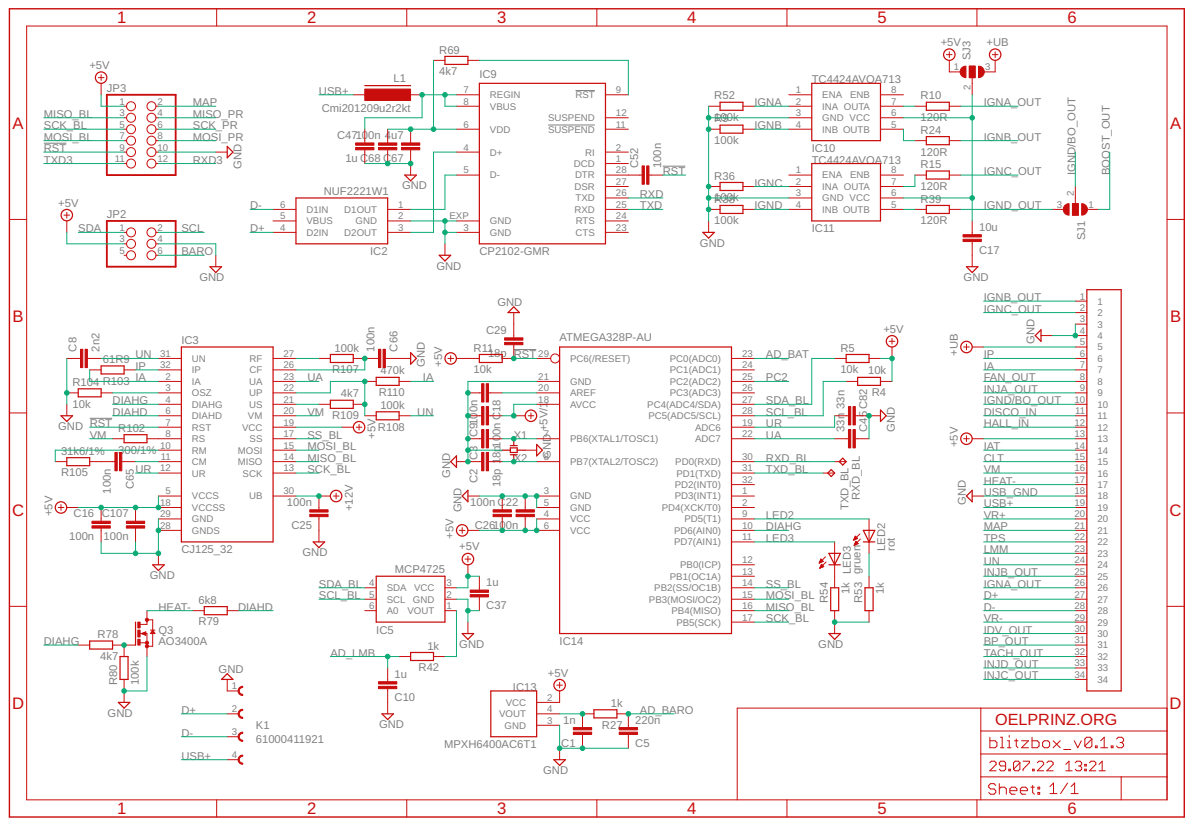
[picture p35: page 2]
