oelprinz-org/BlitzboxBL49sp/hardware/Rev0.1.2/schematics.pdf

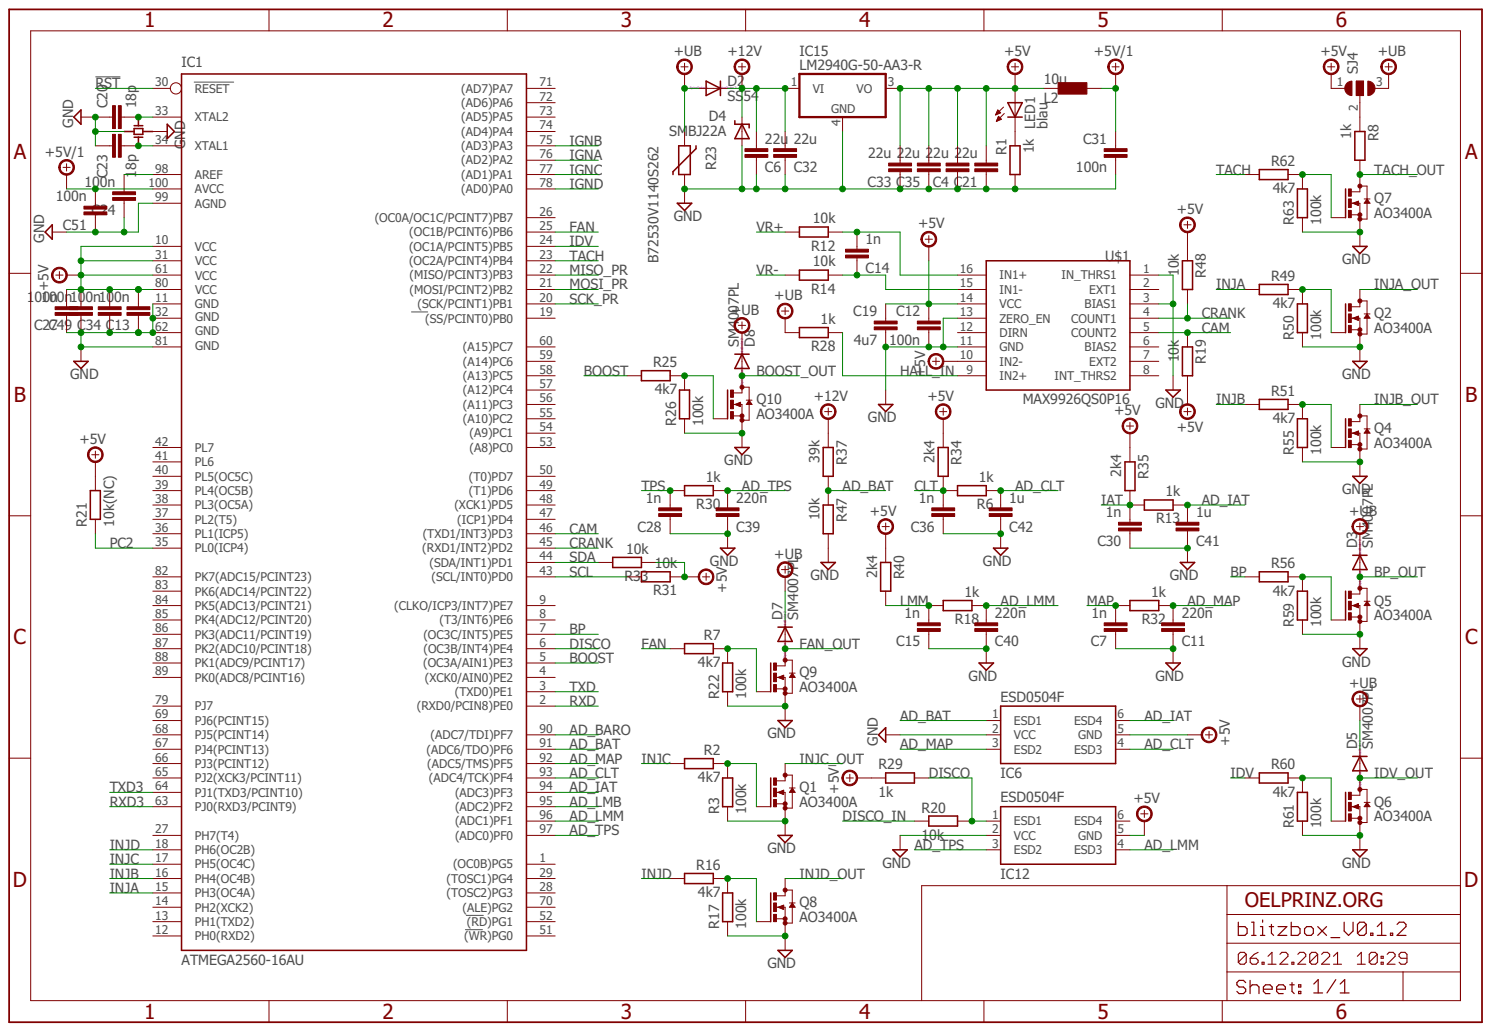
[picture p36: page 1]

SpiceOrder 1 SpiceOrder 2

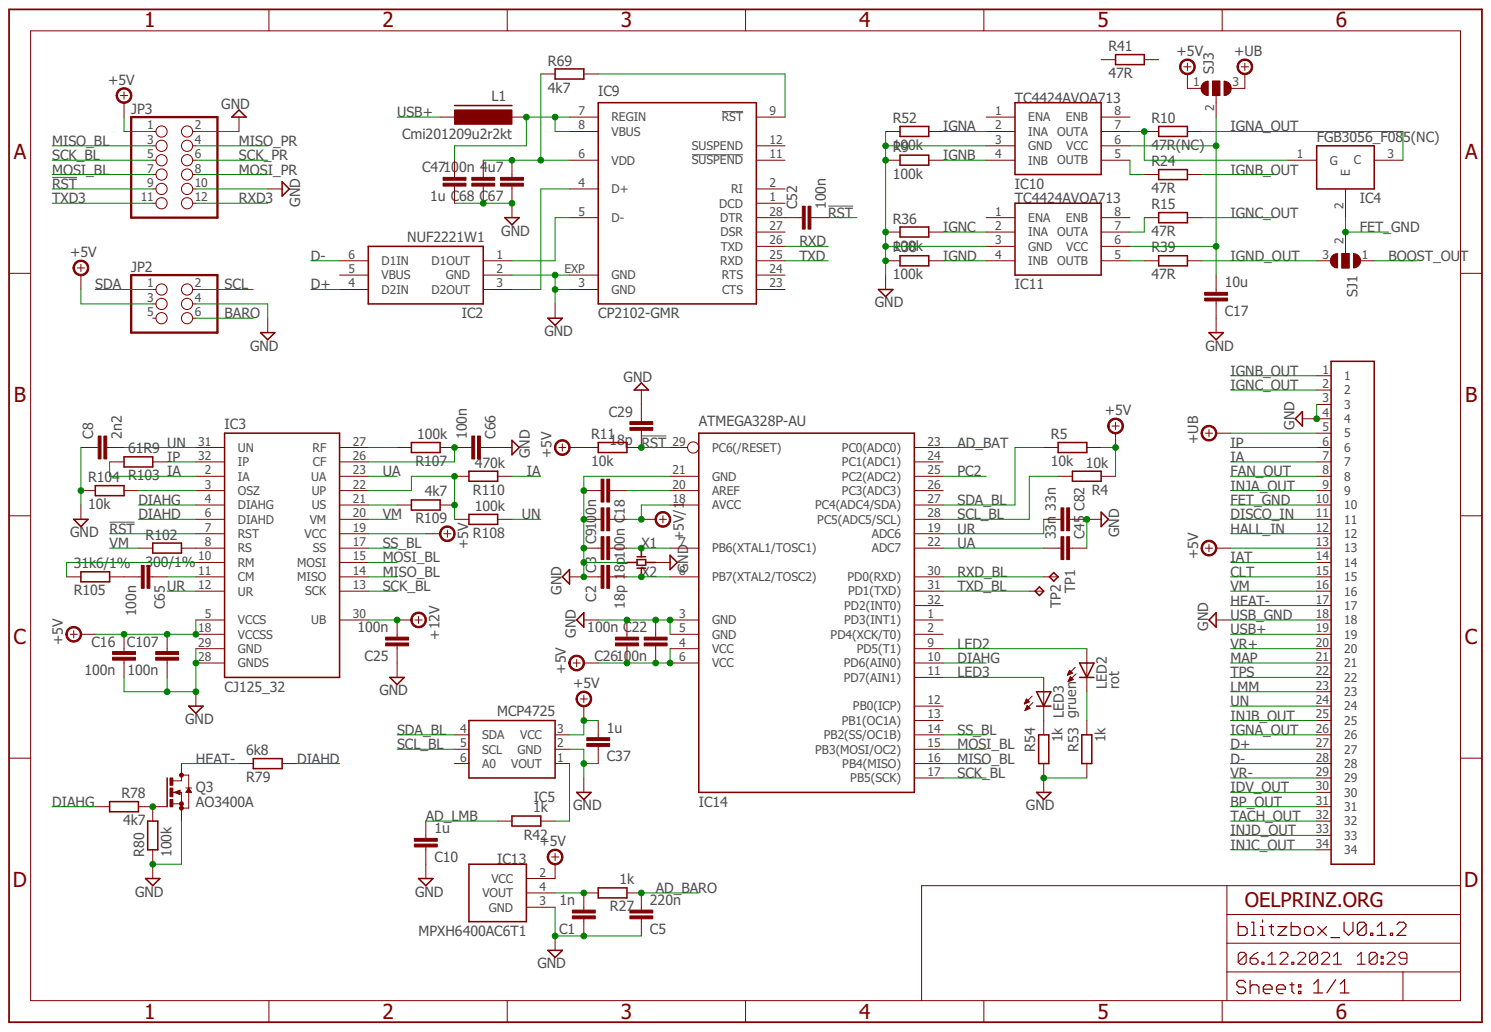
[picture p37: page 2]
