oelprinz-org/BlitzboxBL49sp/hardware/Rev0.1.1/schematics.pdf

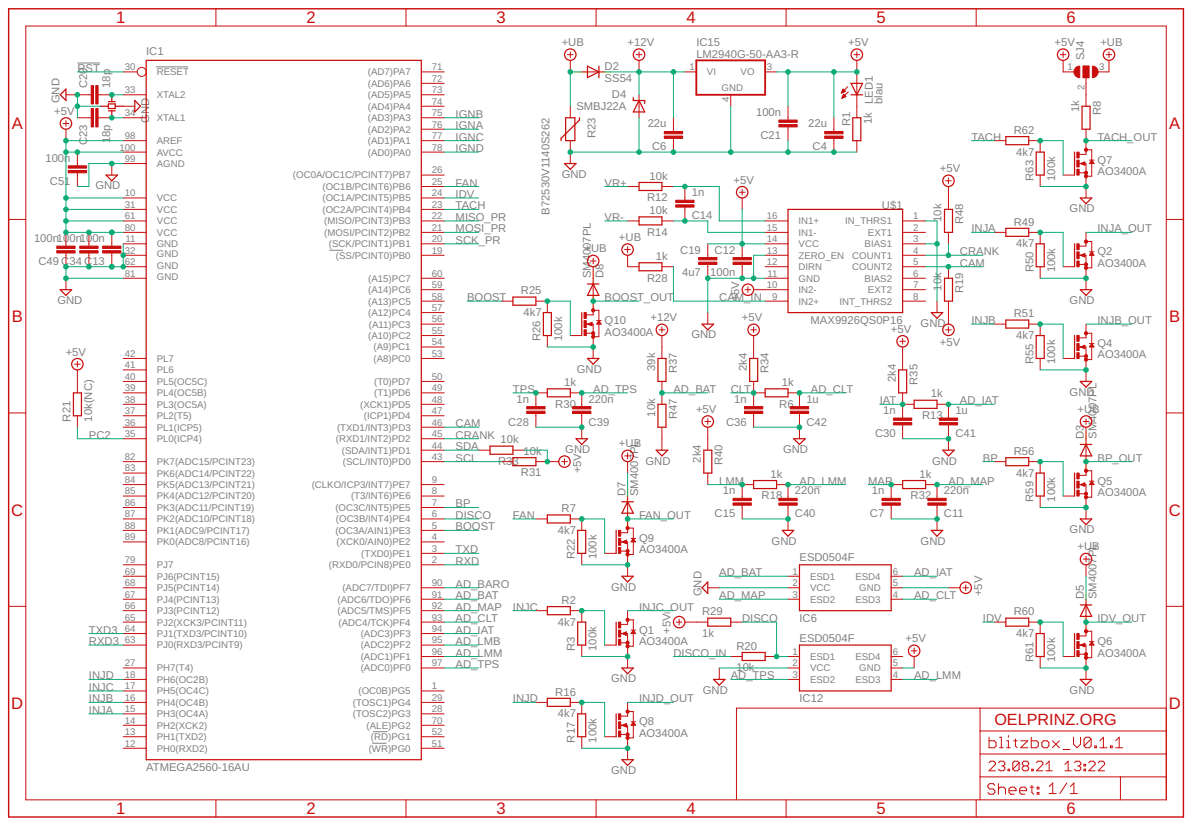
[picture p38: page 1]

SpiceOrder 1 SpiceOrder 2
BP_OUT

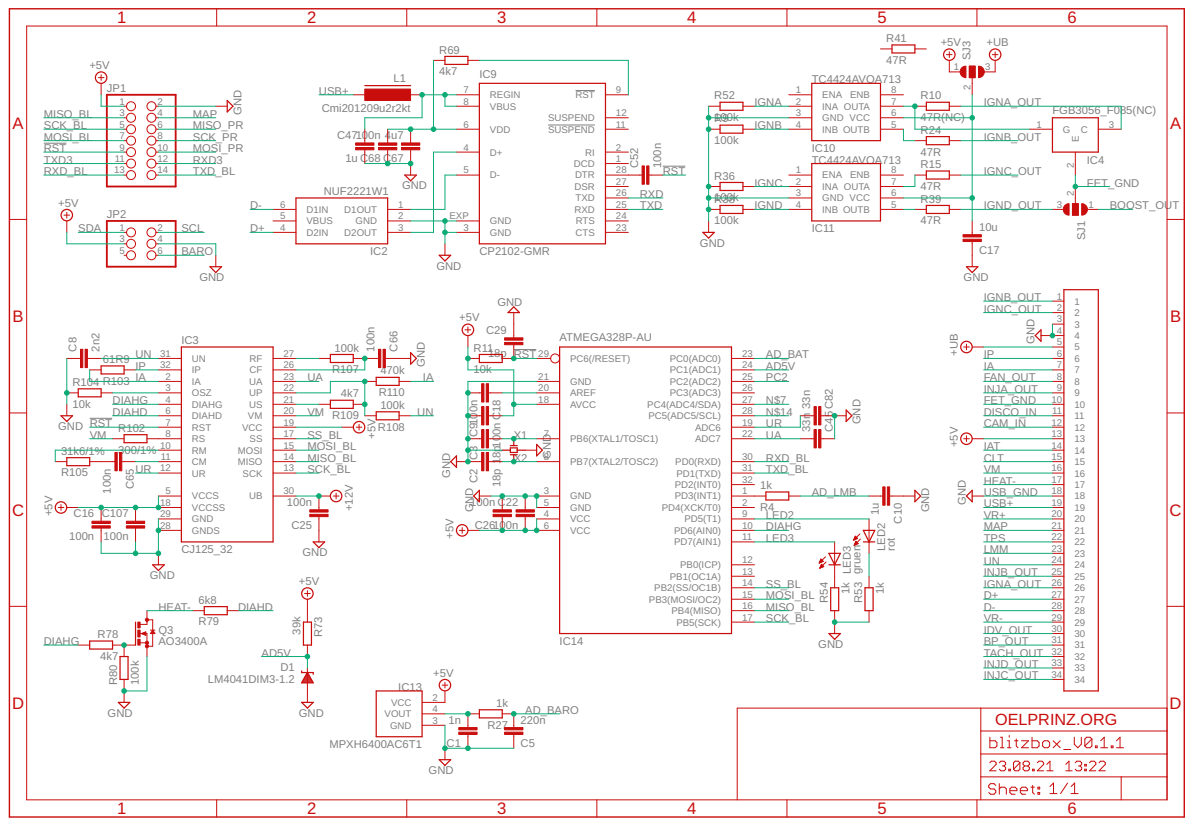
[picture p39: page 2]
