oelprinz-org/BlitzboxBL49sp/hardware/Rev0.1.0/schematics.pdf

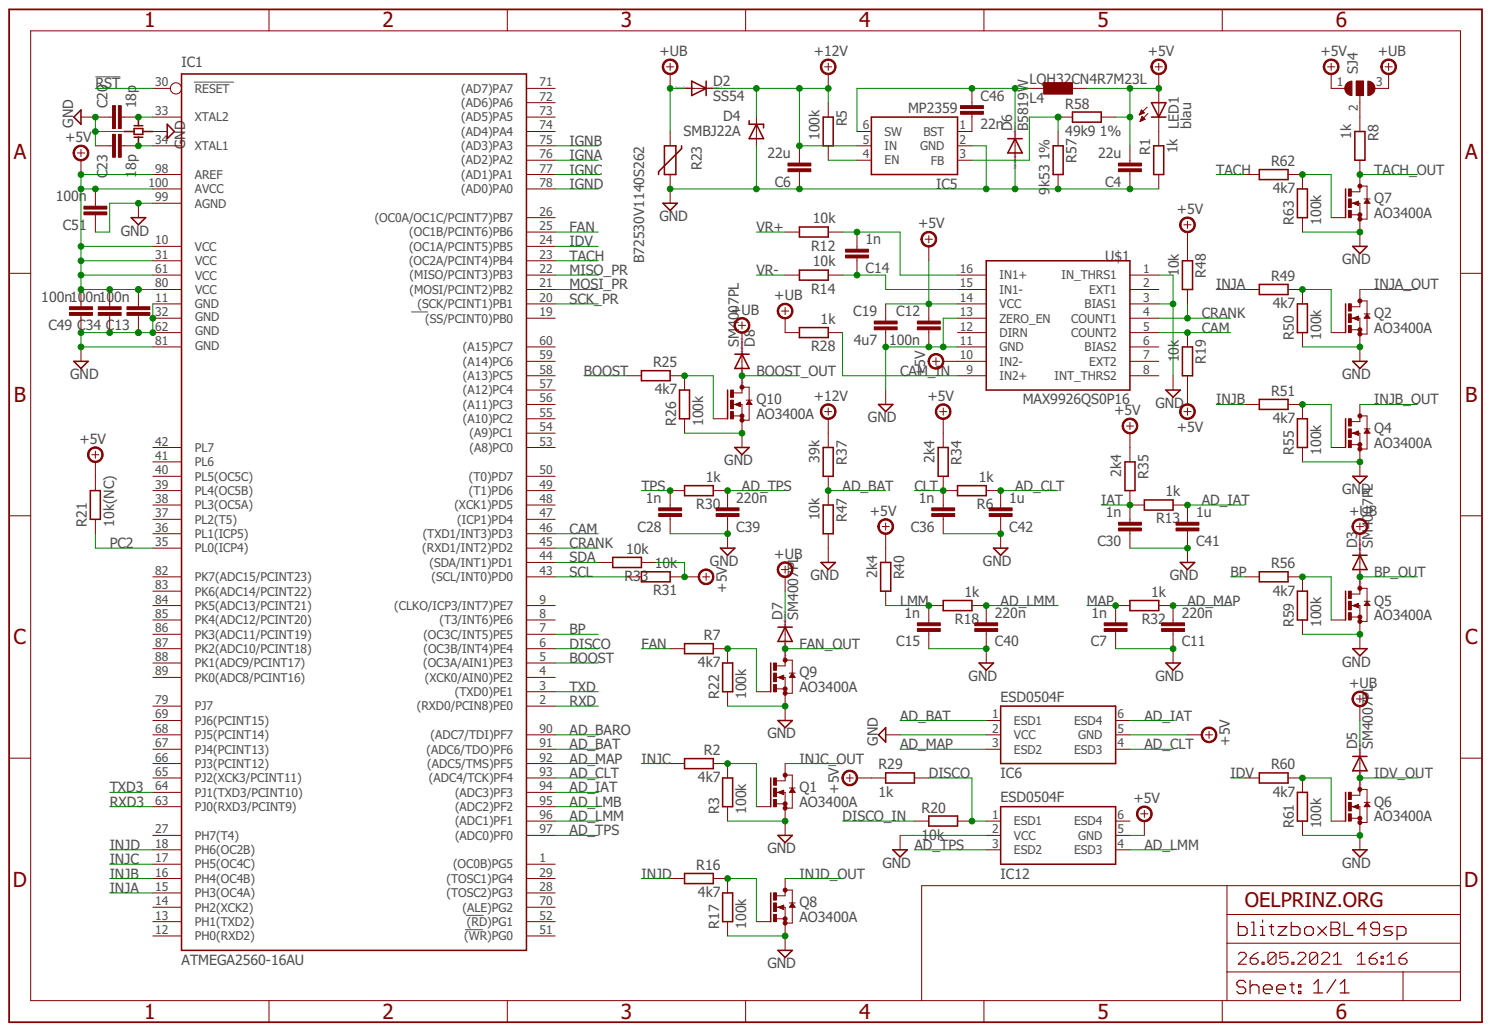
[picture p40: page 1]

SpiceOrder 1 SpiceOrder 2

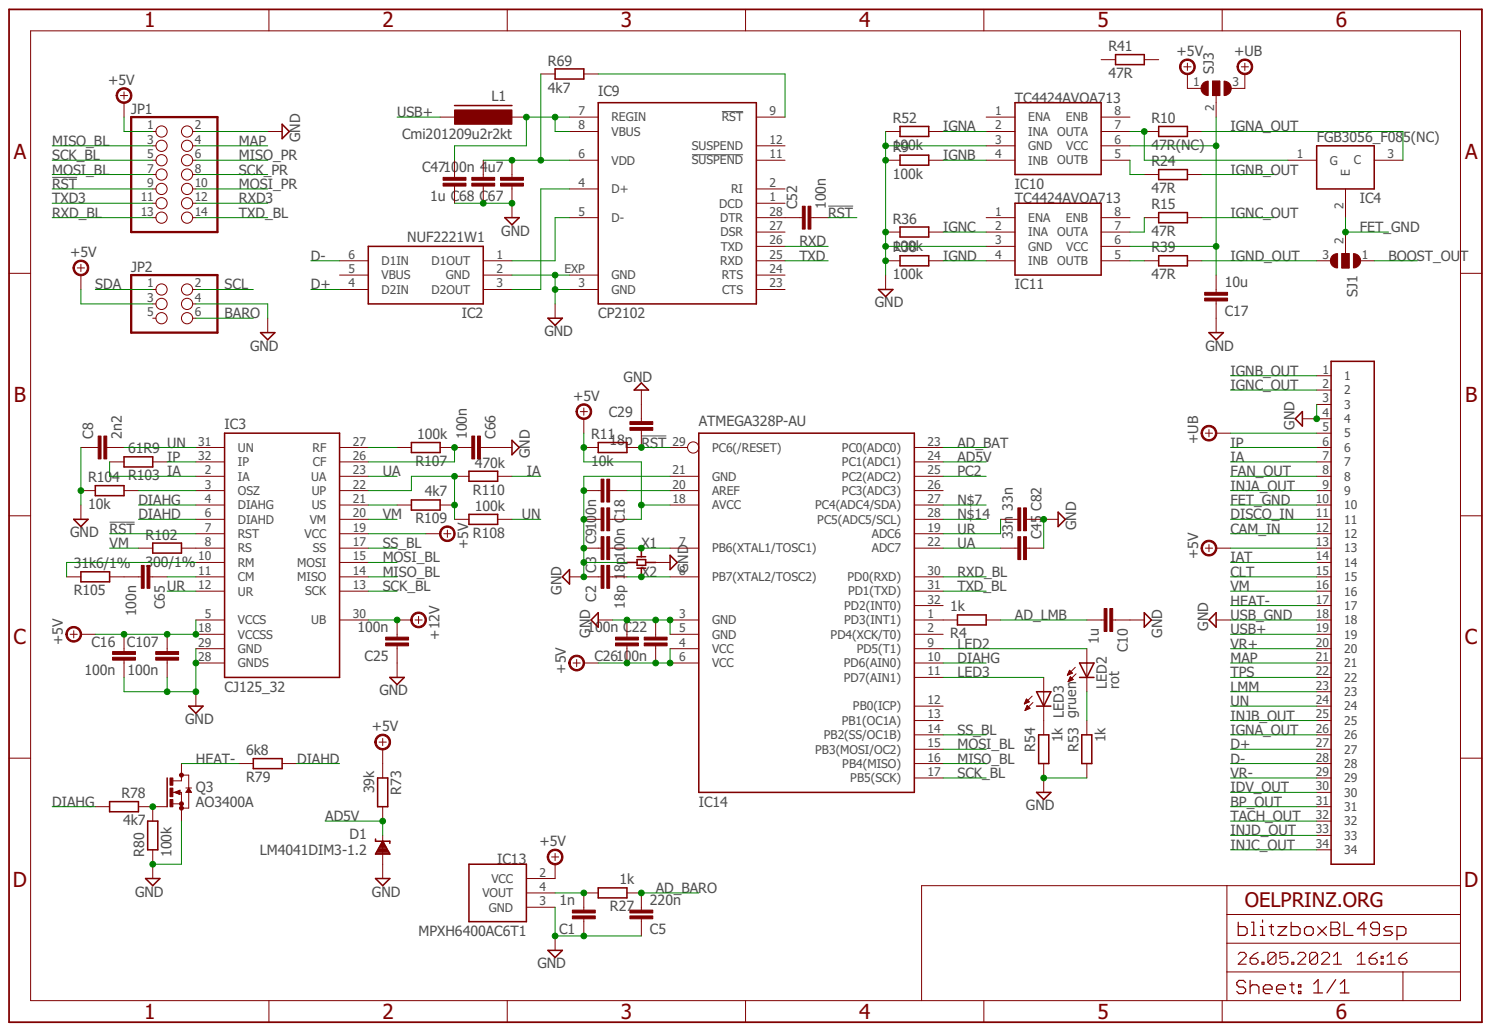
[picture p41: page 2]
