oelprinz-org/BlitzboxBL49sp/hardware/Rev0.0.9/schematics.pdf

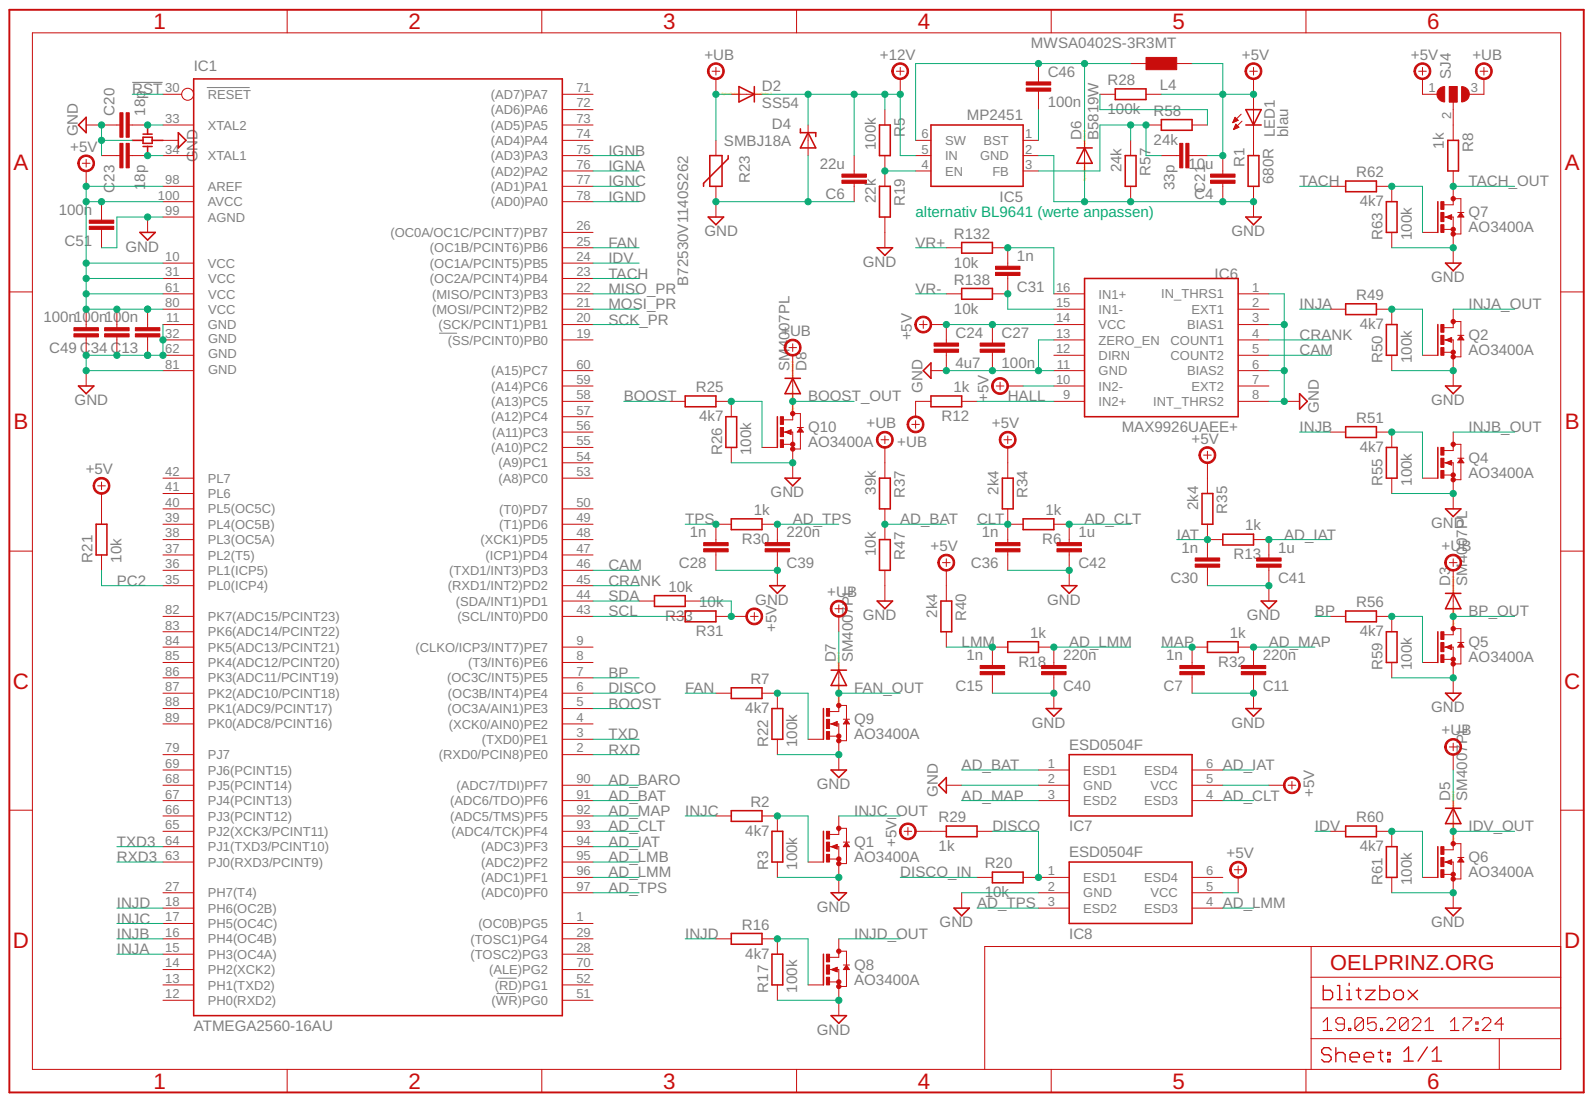
[picture p42: page 1]

SpiceOrder 1 SpiceOrder 2

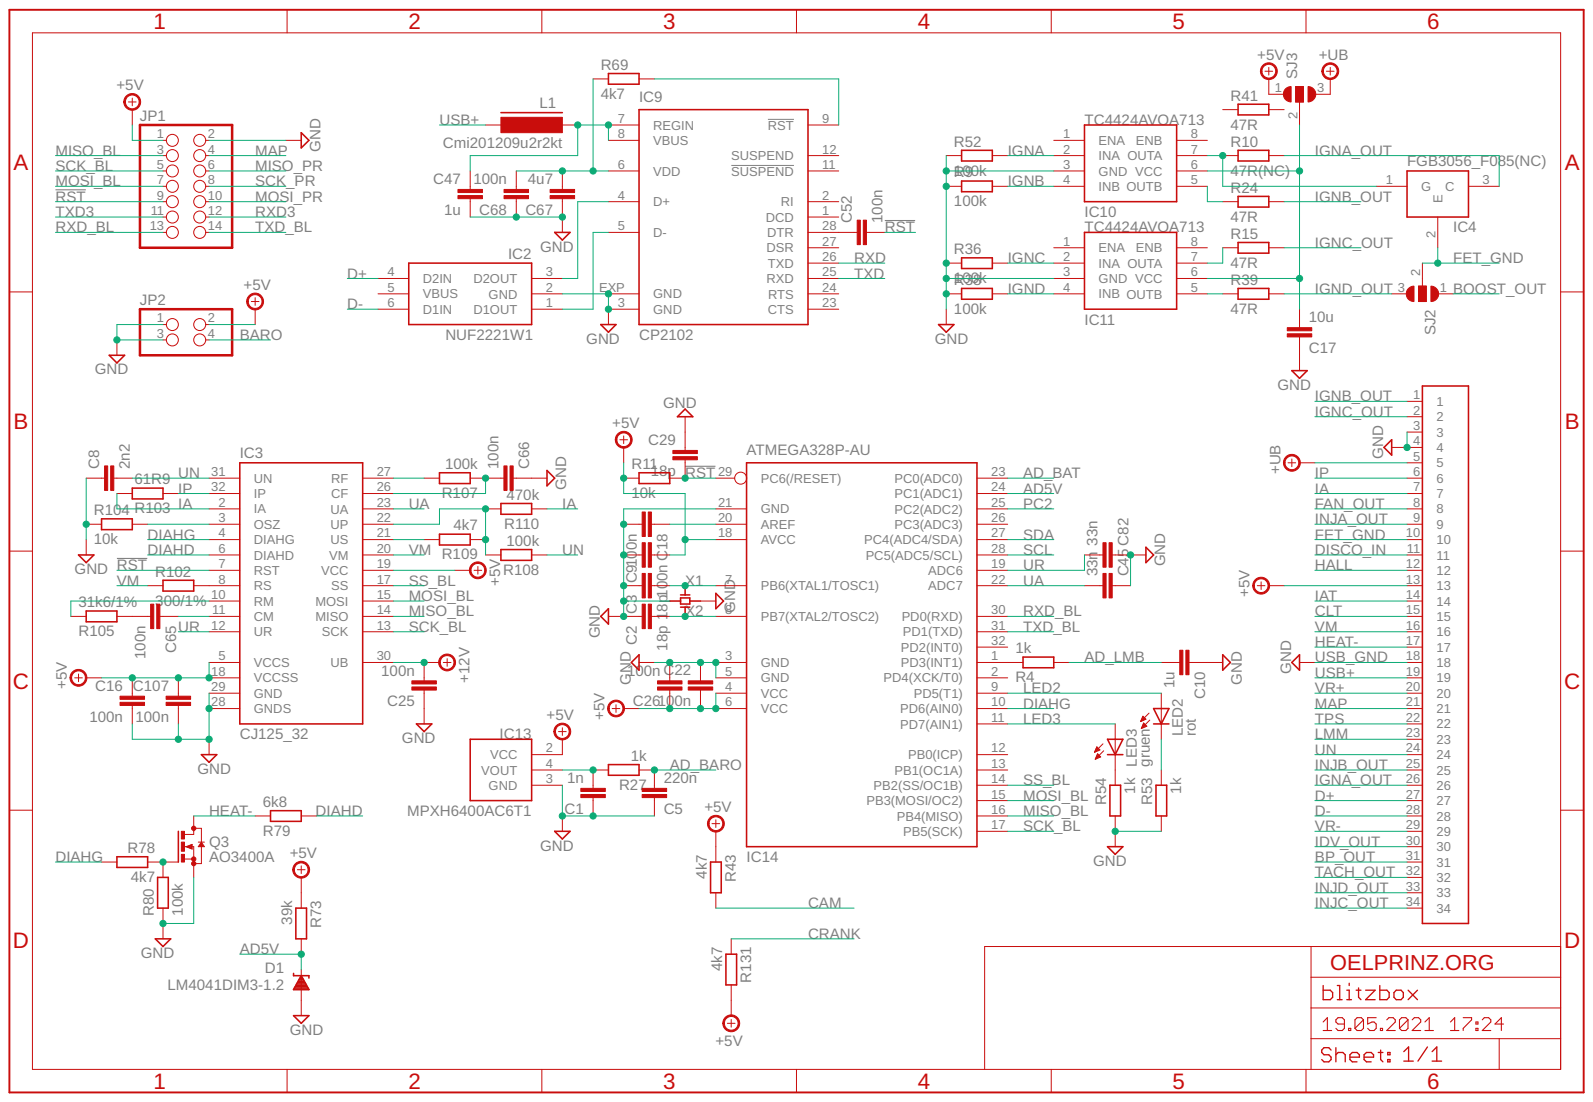
[picture p43: page 2]
