oelprinz-org/BlitzboxBL49sp/hardware/Rev0.0.8/schematics.pdf

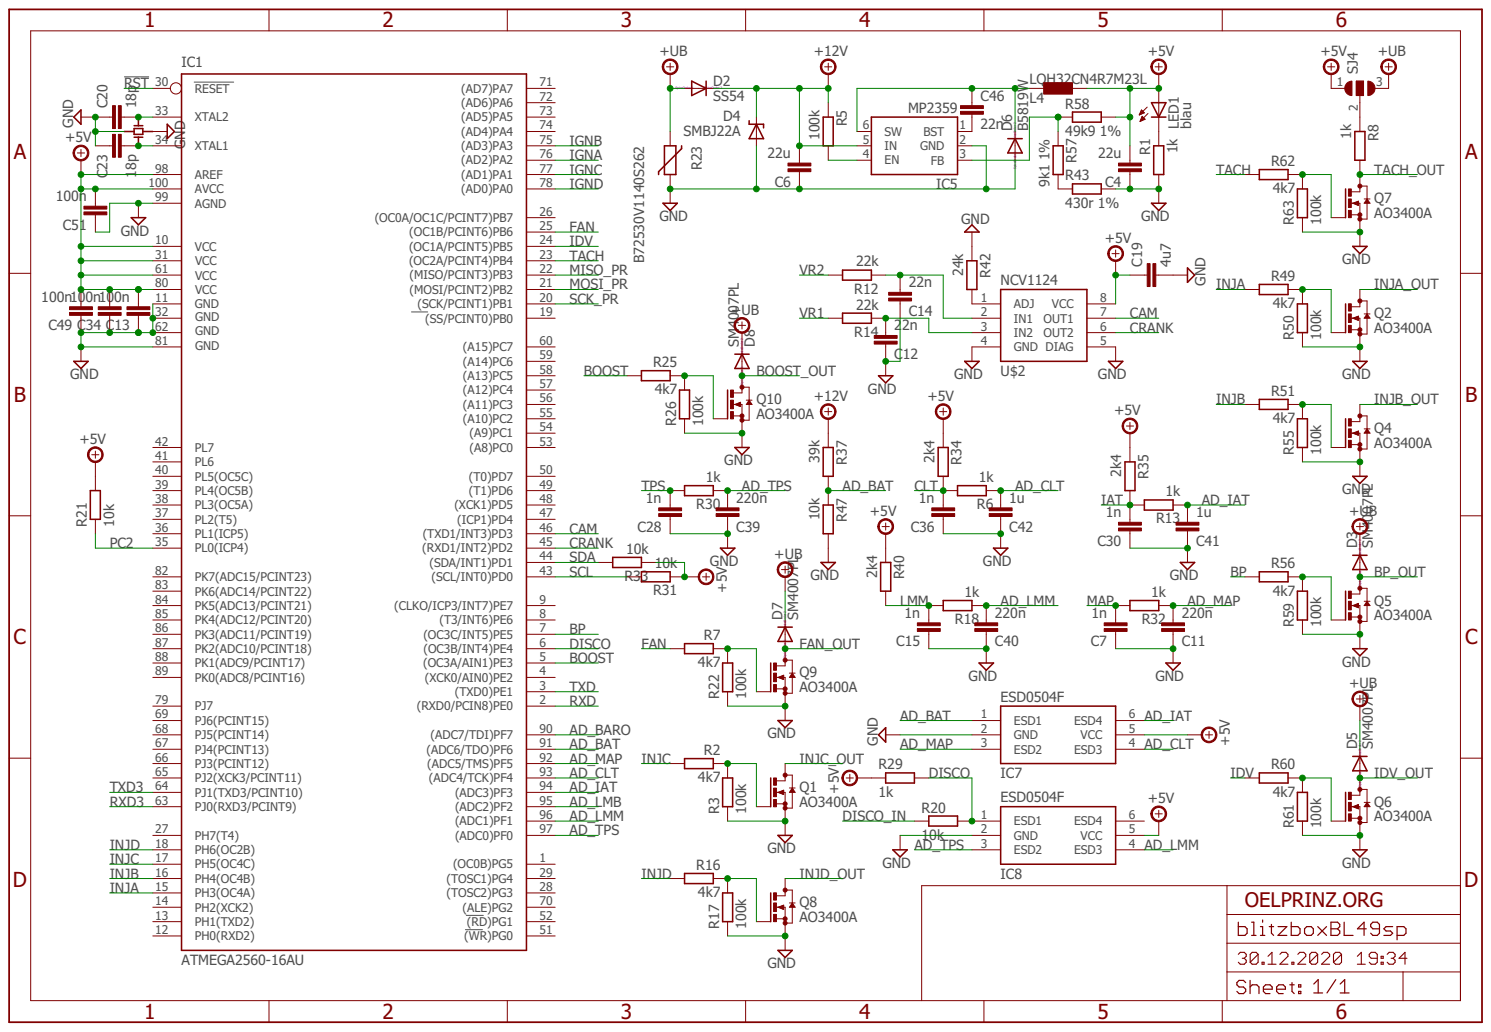
[picture p44: page 1]

SpiceOrder 1 SpiceOrder 2

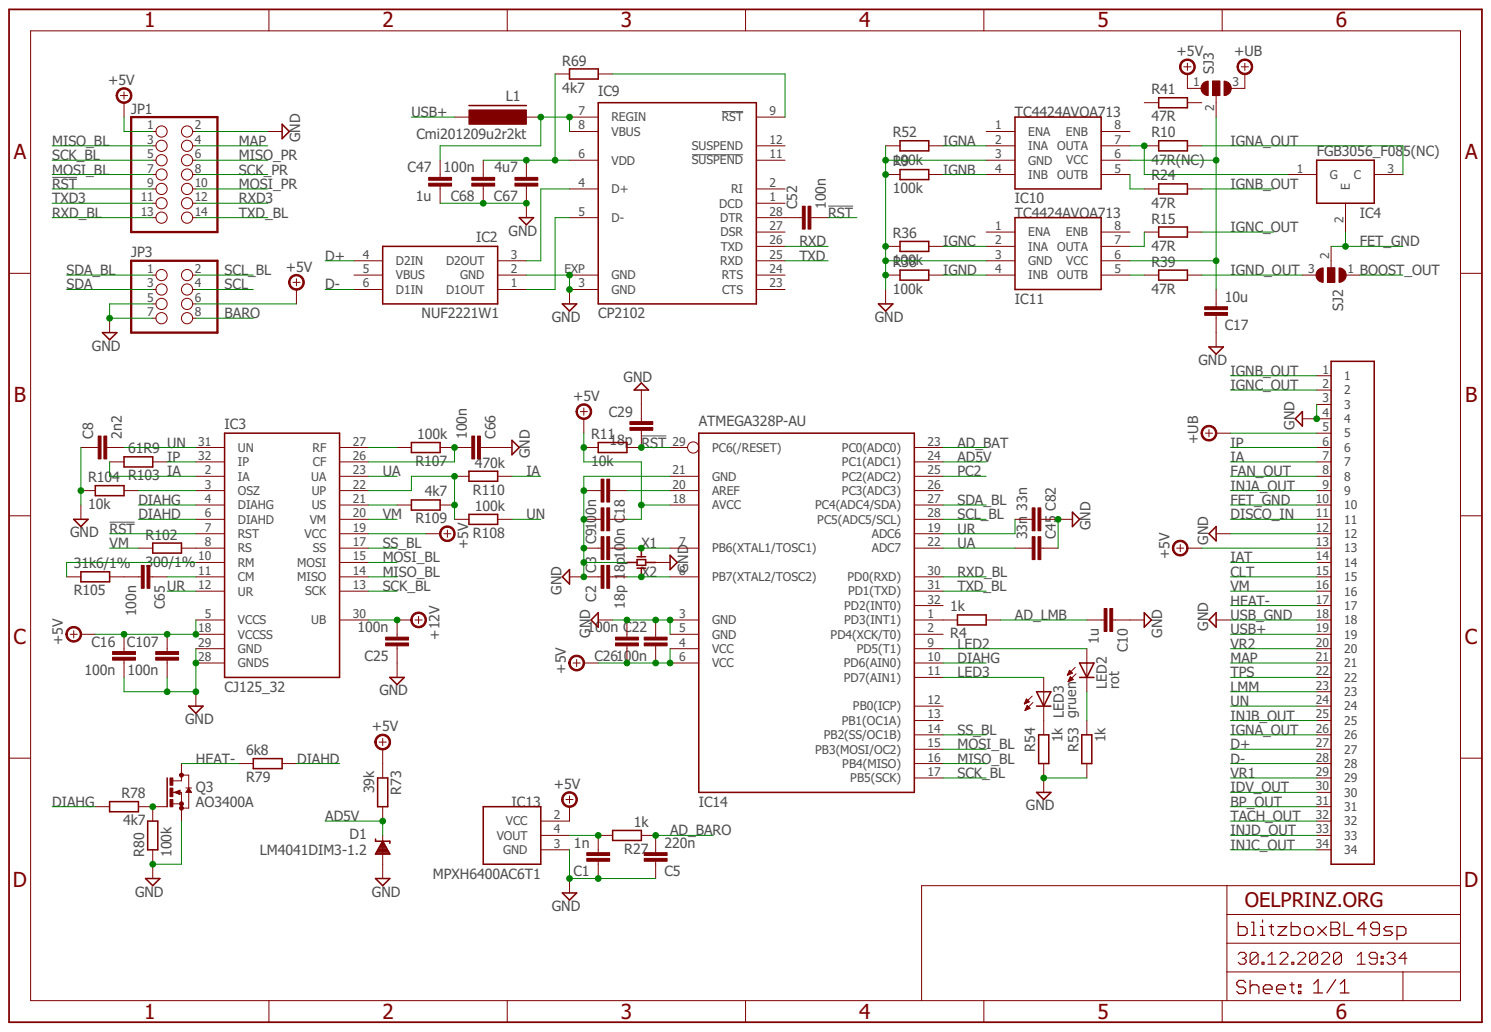
[picture p45: page 2]
