oelprinz-org/BlitzboxBL49sp/hardware/Rev0.0.7/schematics.pdf

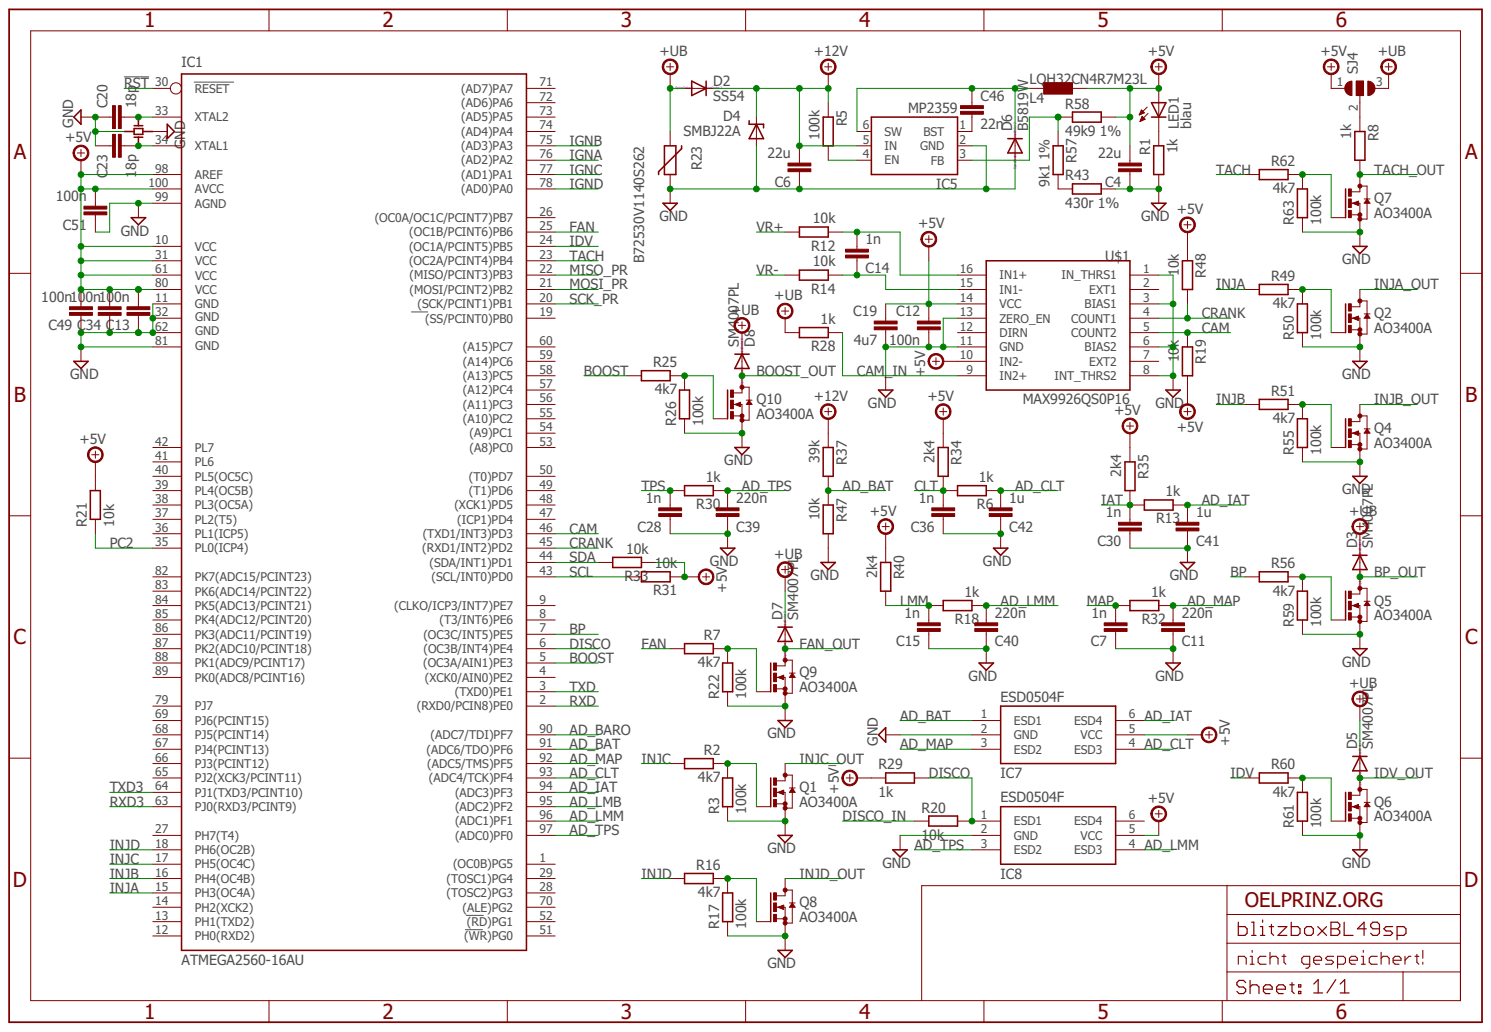
[picture p46: page 1]

SpiceOrder 1 SpiceOrder 2

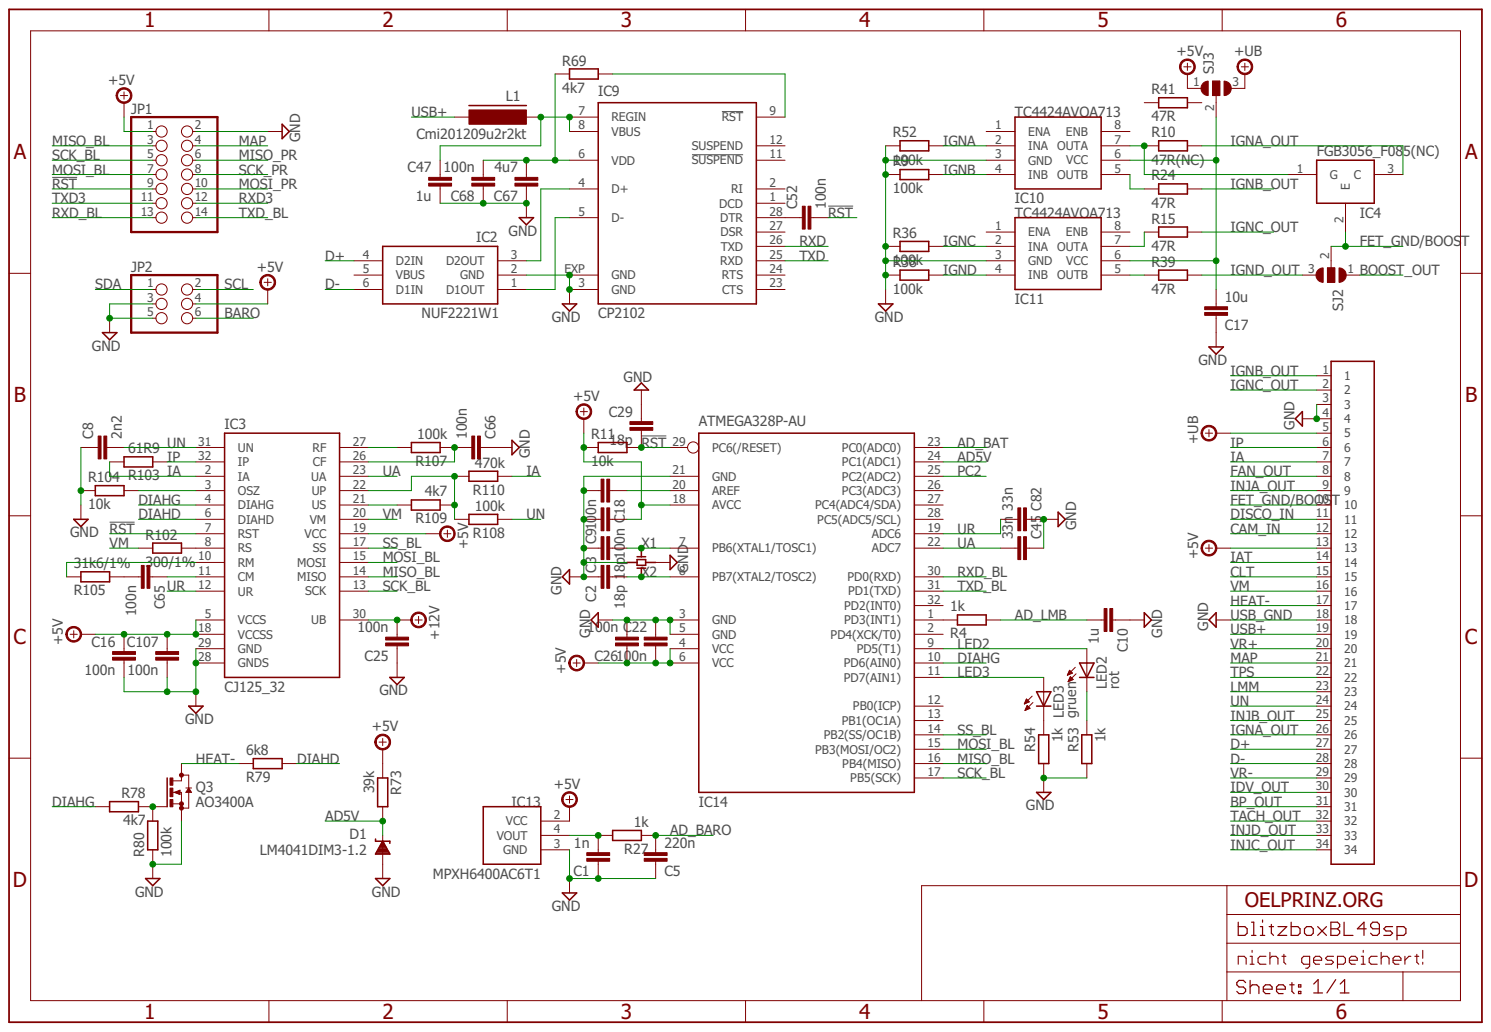
[picture p47: page 2]
