oelprinz-org/BlitzboxBL49sp/hardware/Rev0.0.6/schematics.pdf

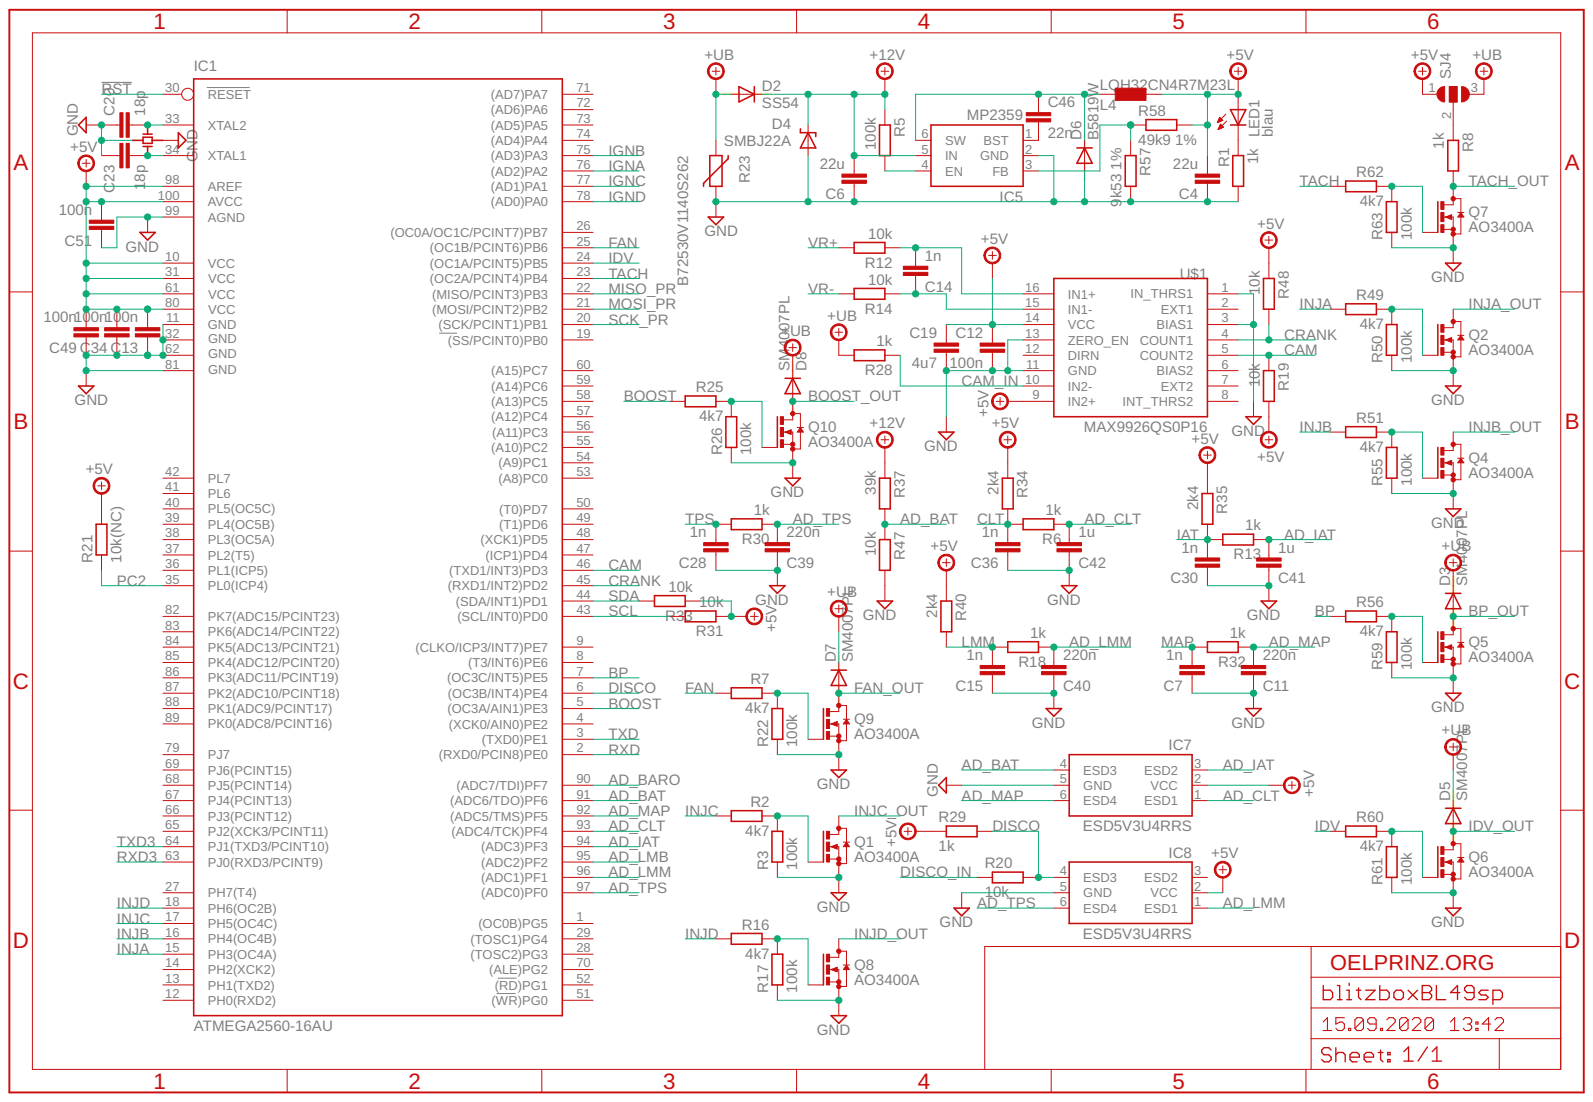
[picture p48: page 1]

SpiceOrder 1 SpiceOrder 2

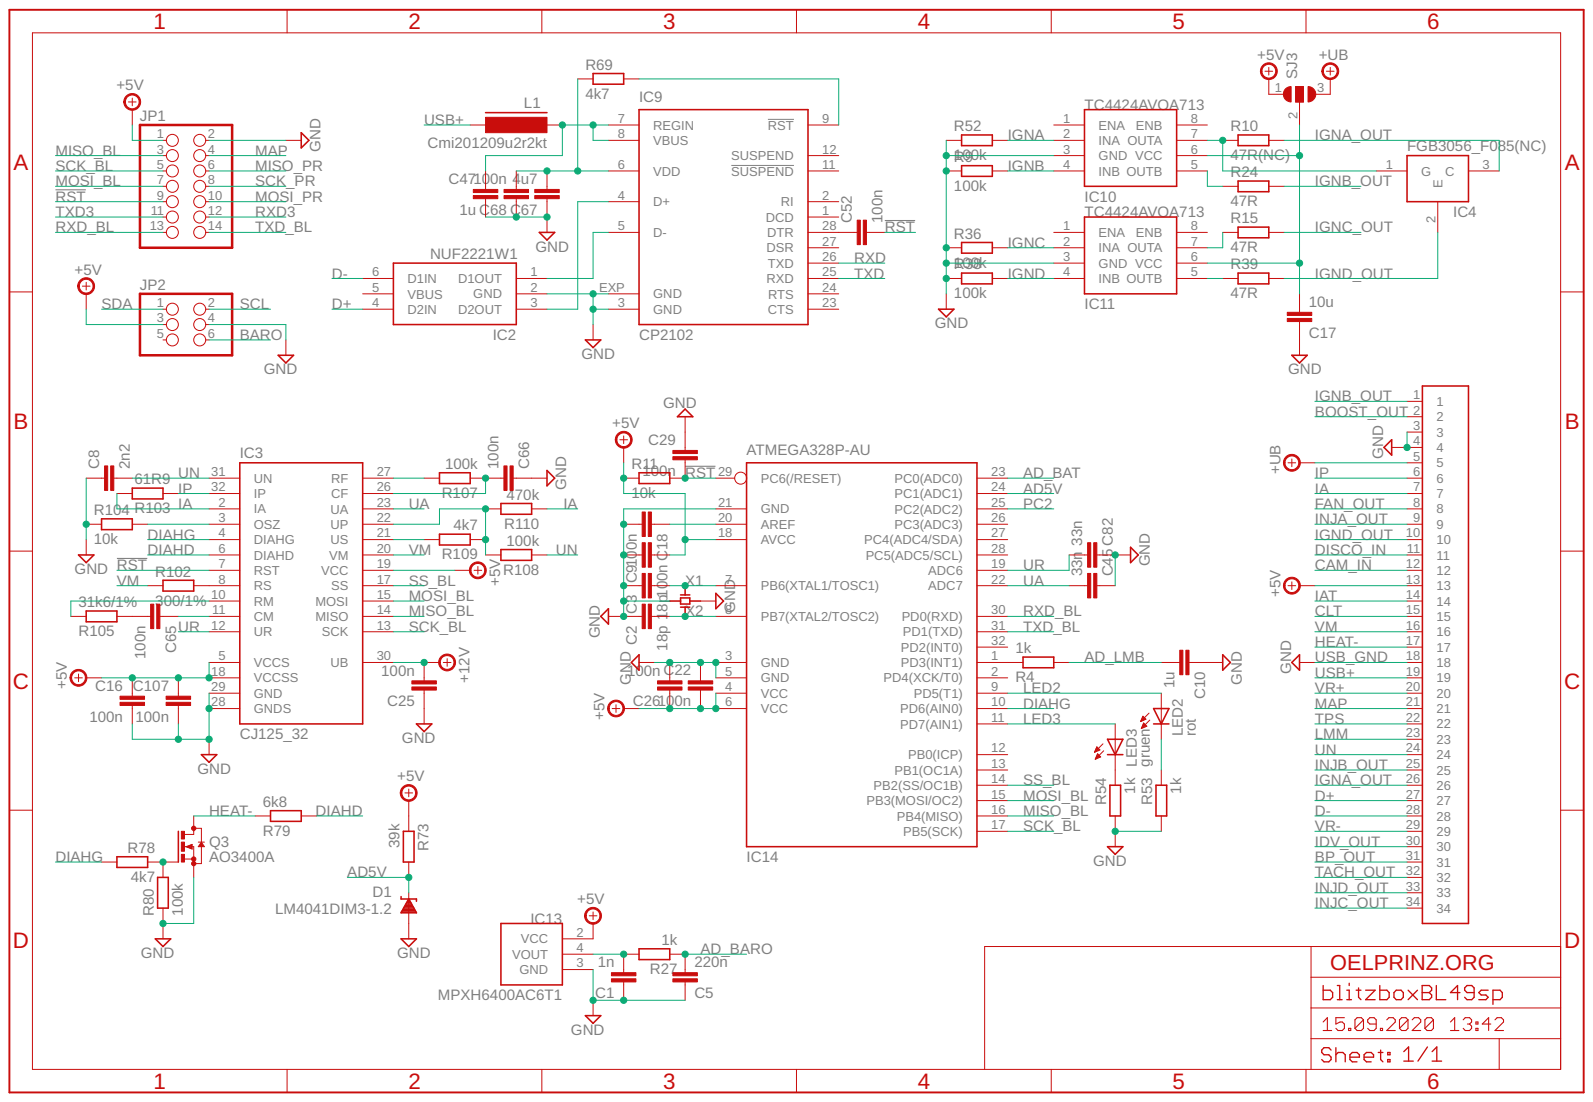
[picture p49: page 2]
