oelprinz-org/BlitzboxBL49sp/hardware/Rev0.0.5/schematics.pdf

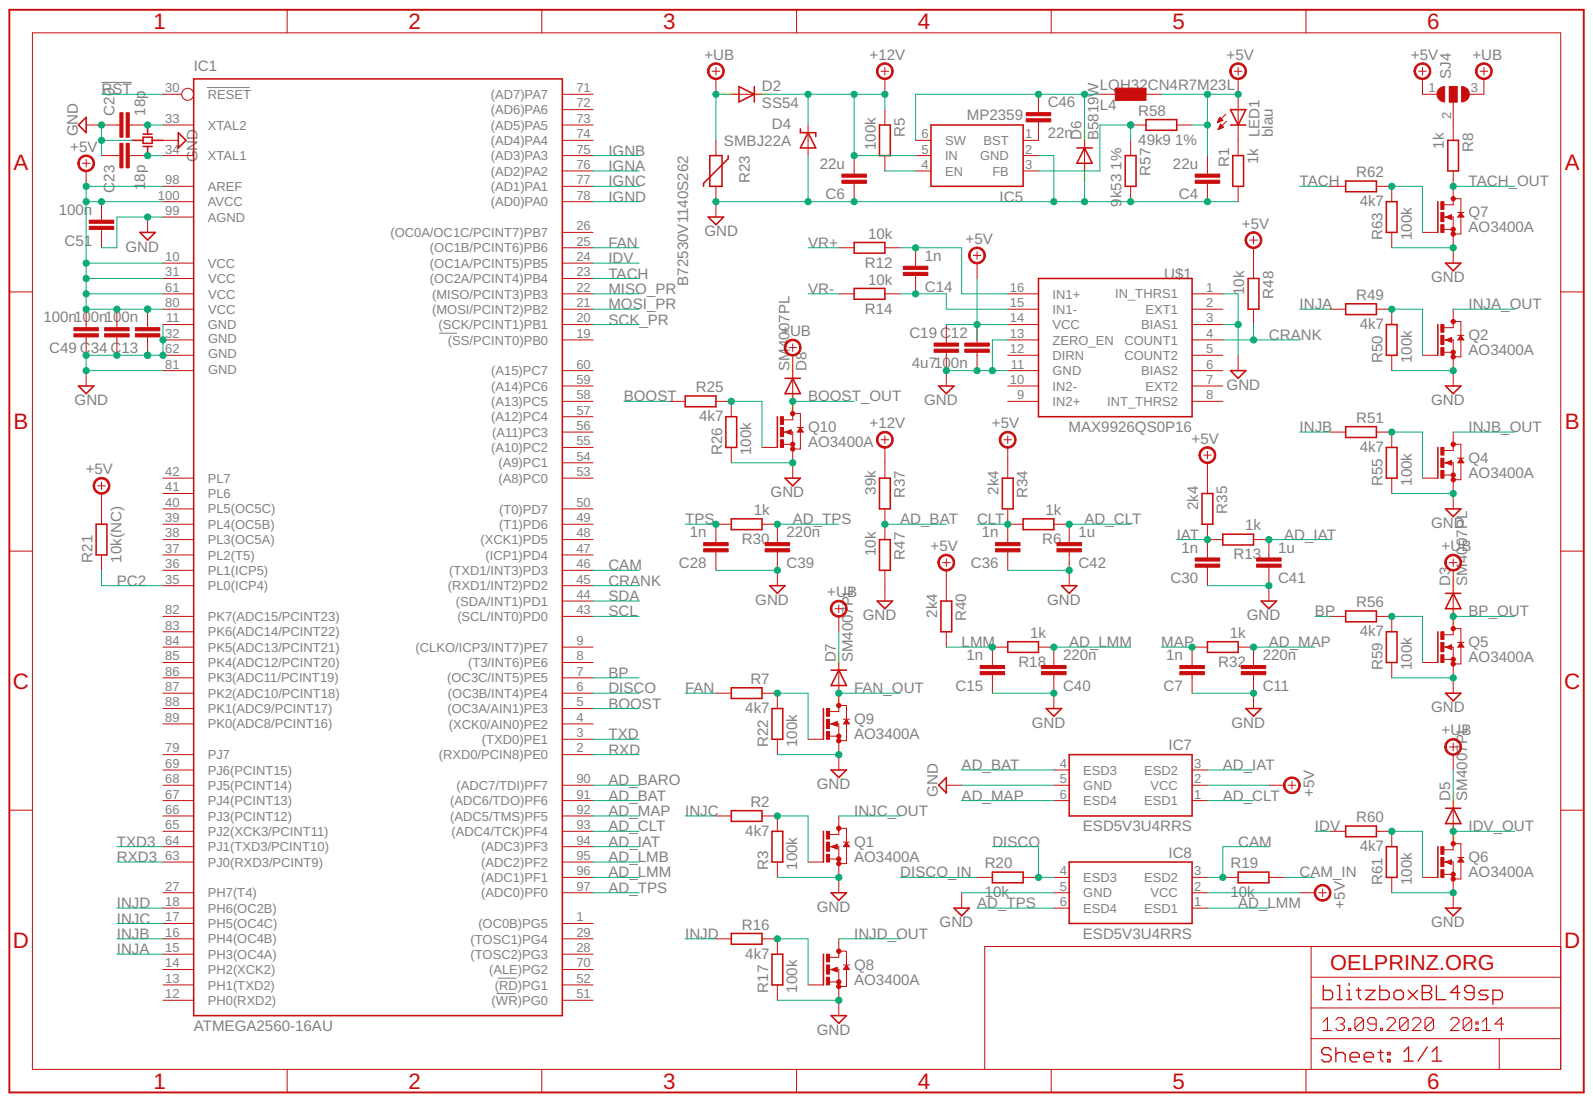
[picture p50: page 1]

SpiceOrder 1 SpiceOrder 2

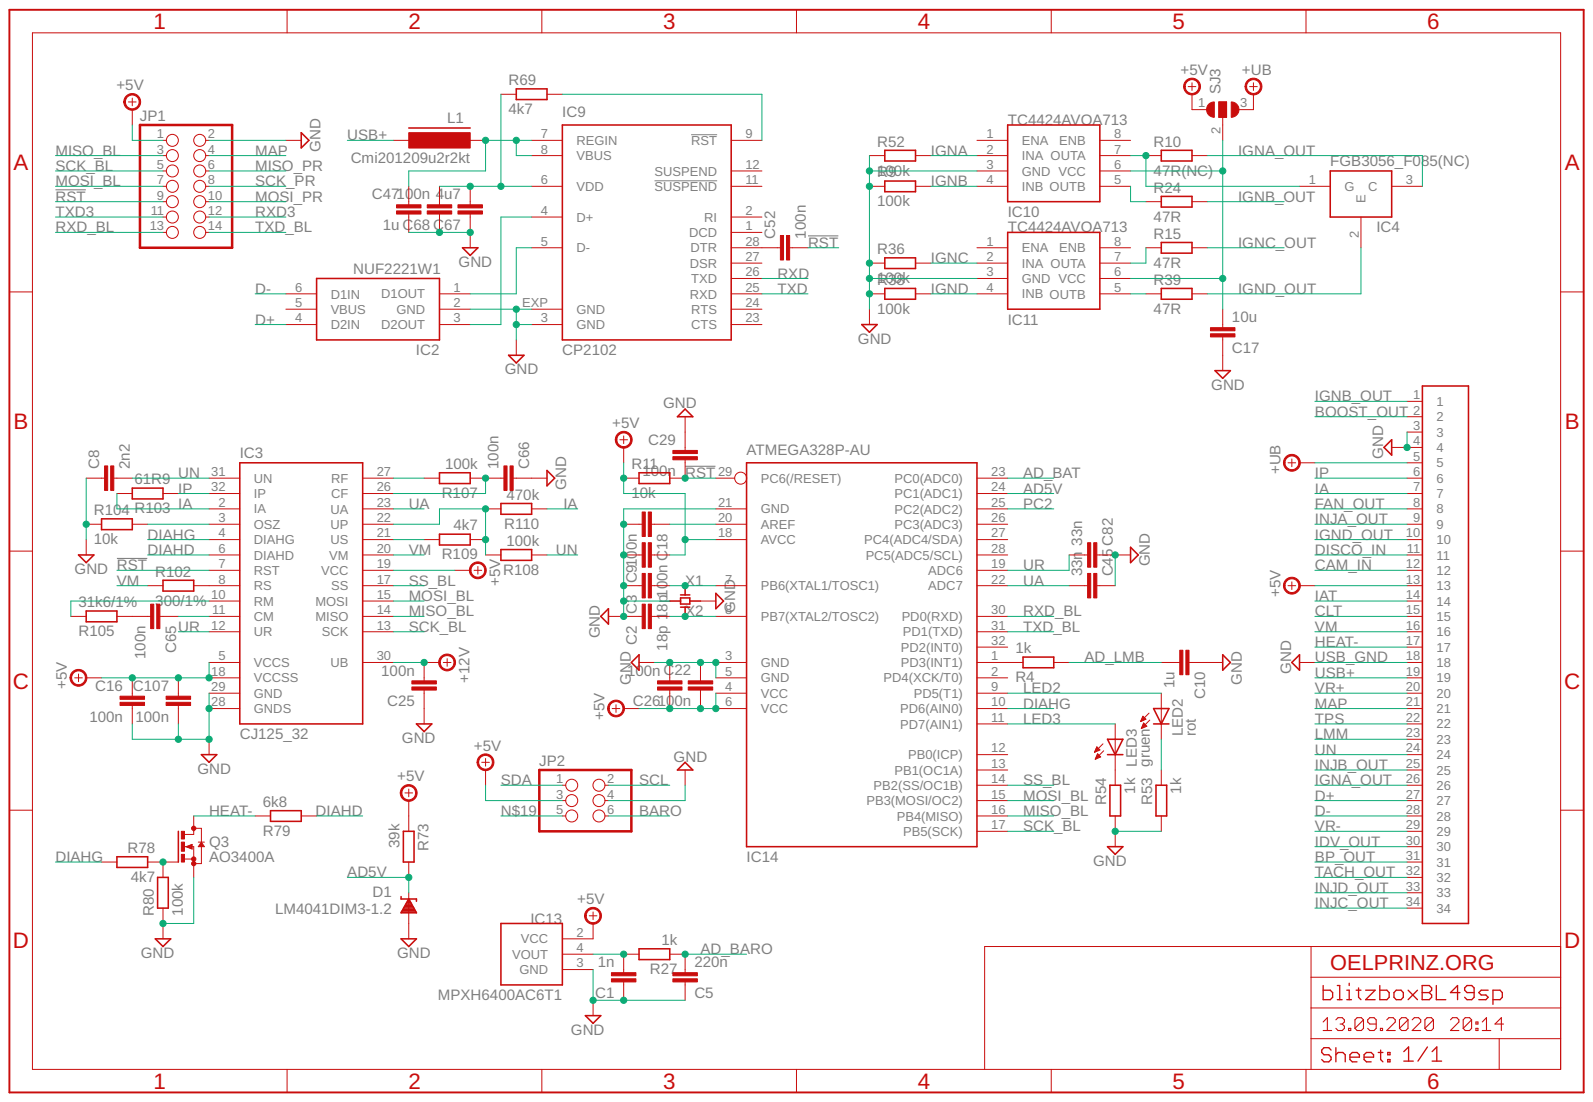
[picture p51: page 2]
