oelprinz-org/BlitzboxBL49sp/hardware/Rev0.0.4c/schematics.pdf

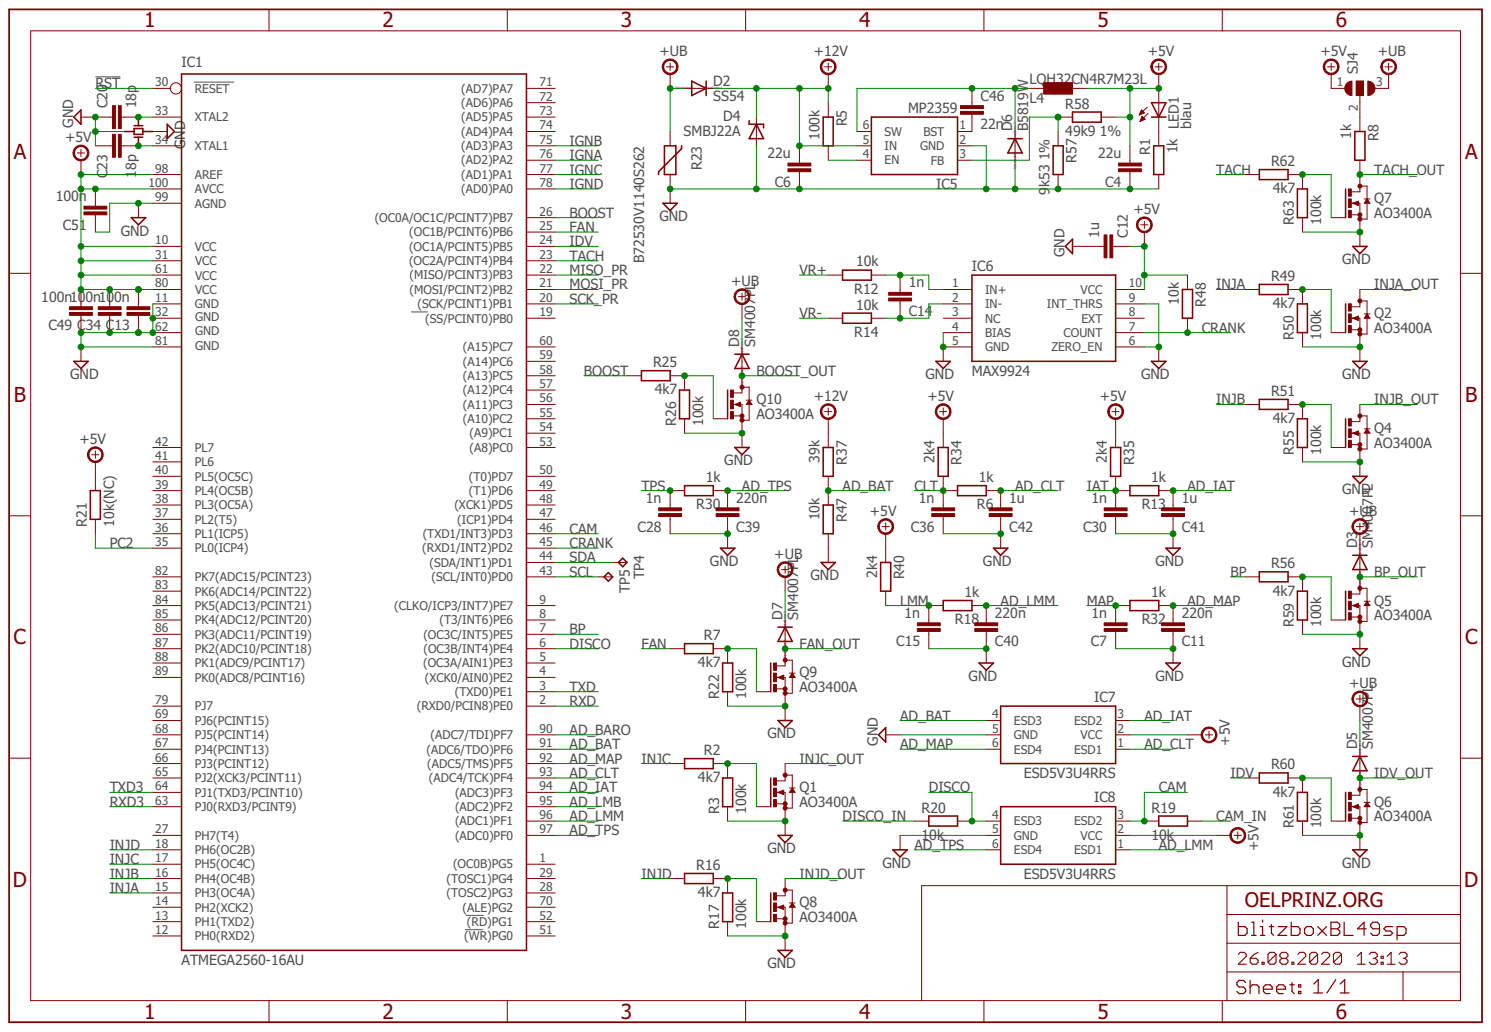
[picture p52: page 1]

SpiceOrder 1 SpiceOrder 2

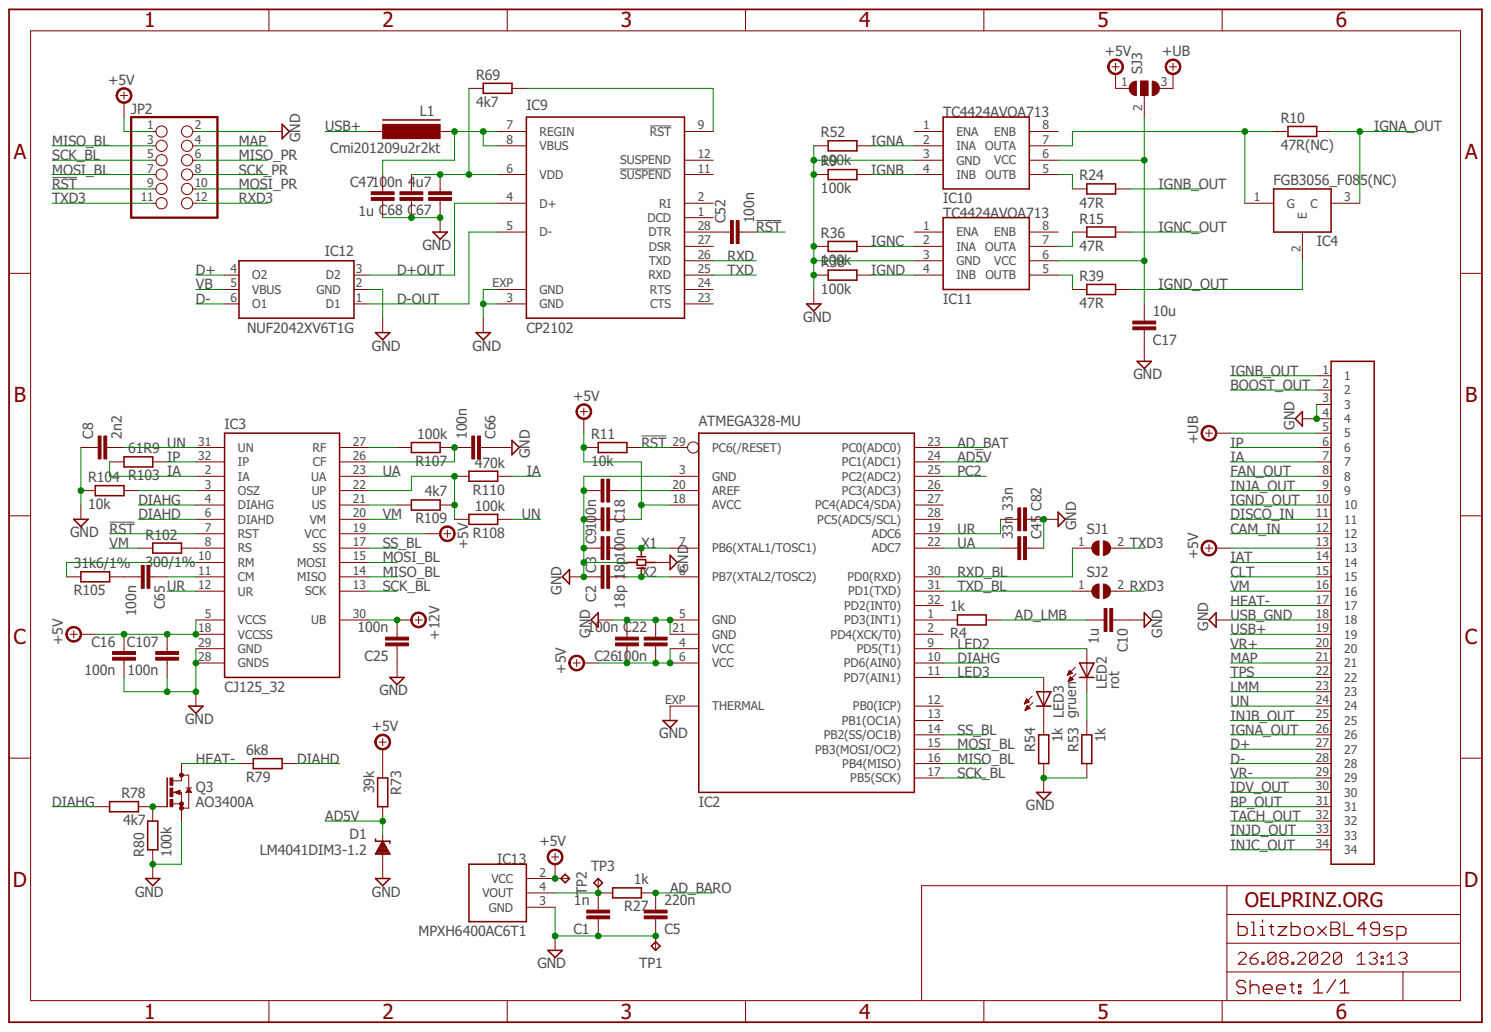
[picture p53: page 2]
