oelprinz-org/BlitzboxBL49sp/hardware/Rev0.0.4a/schematics.pdf

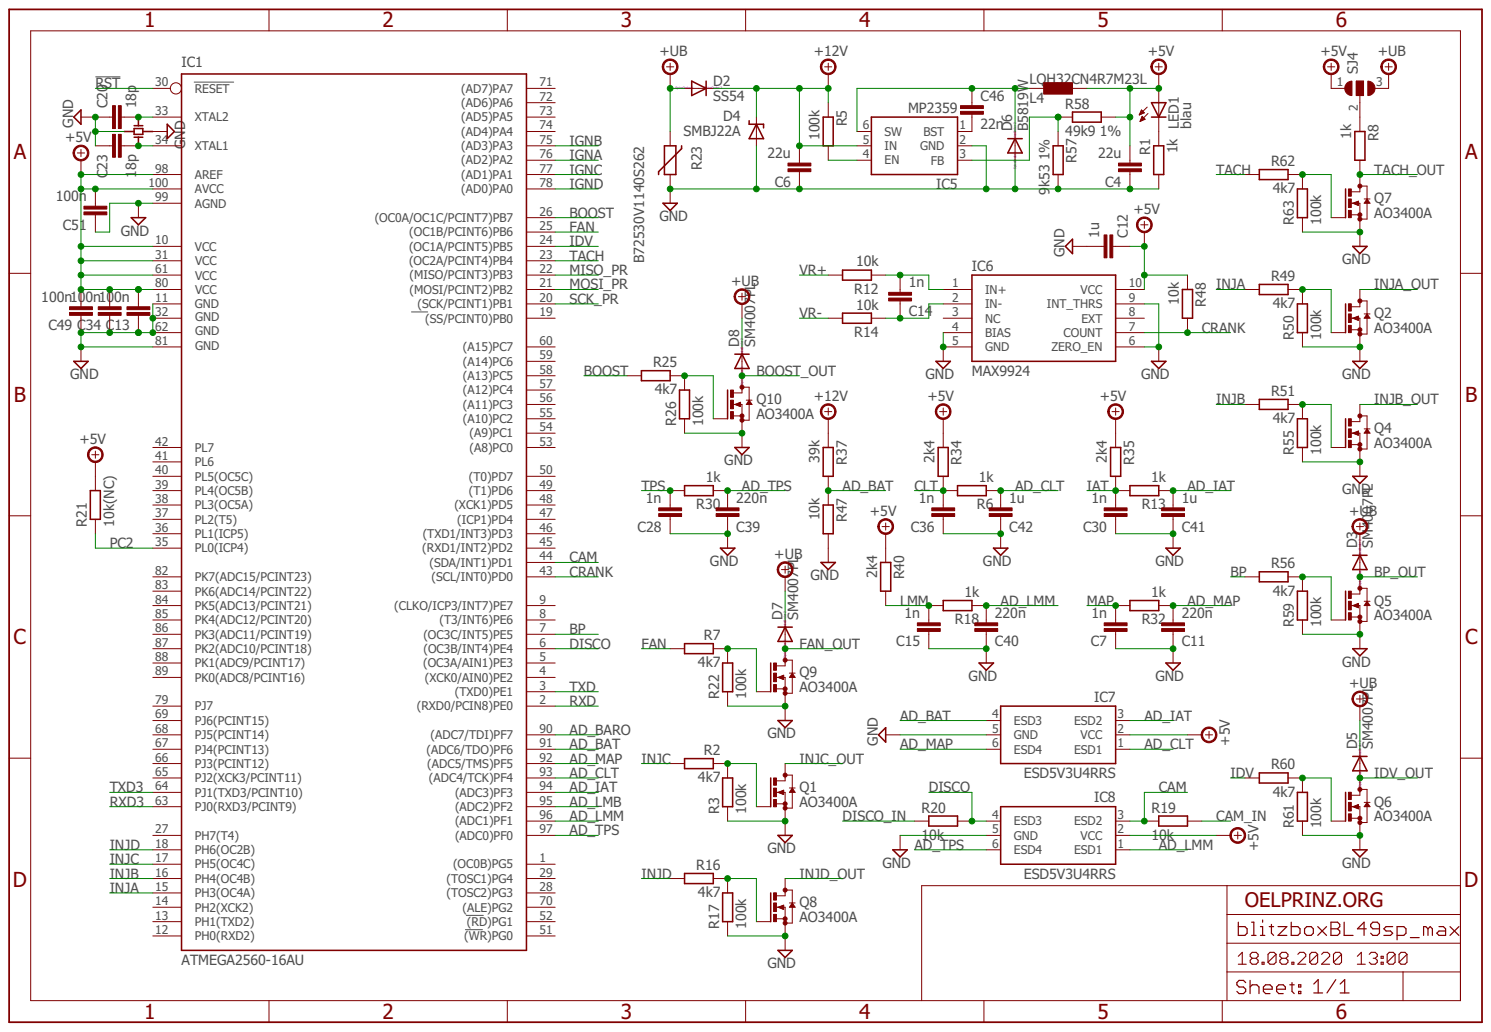
[picture p54: page 1]

SpiceOrder 1 SpiceOrder 2

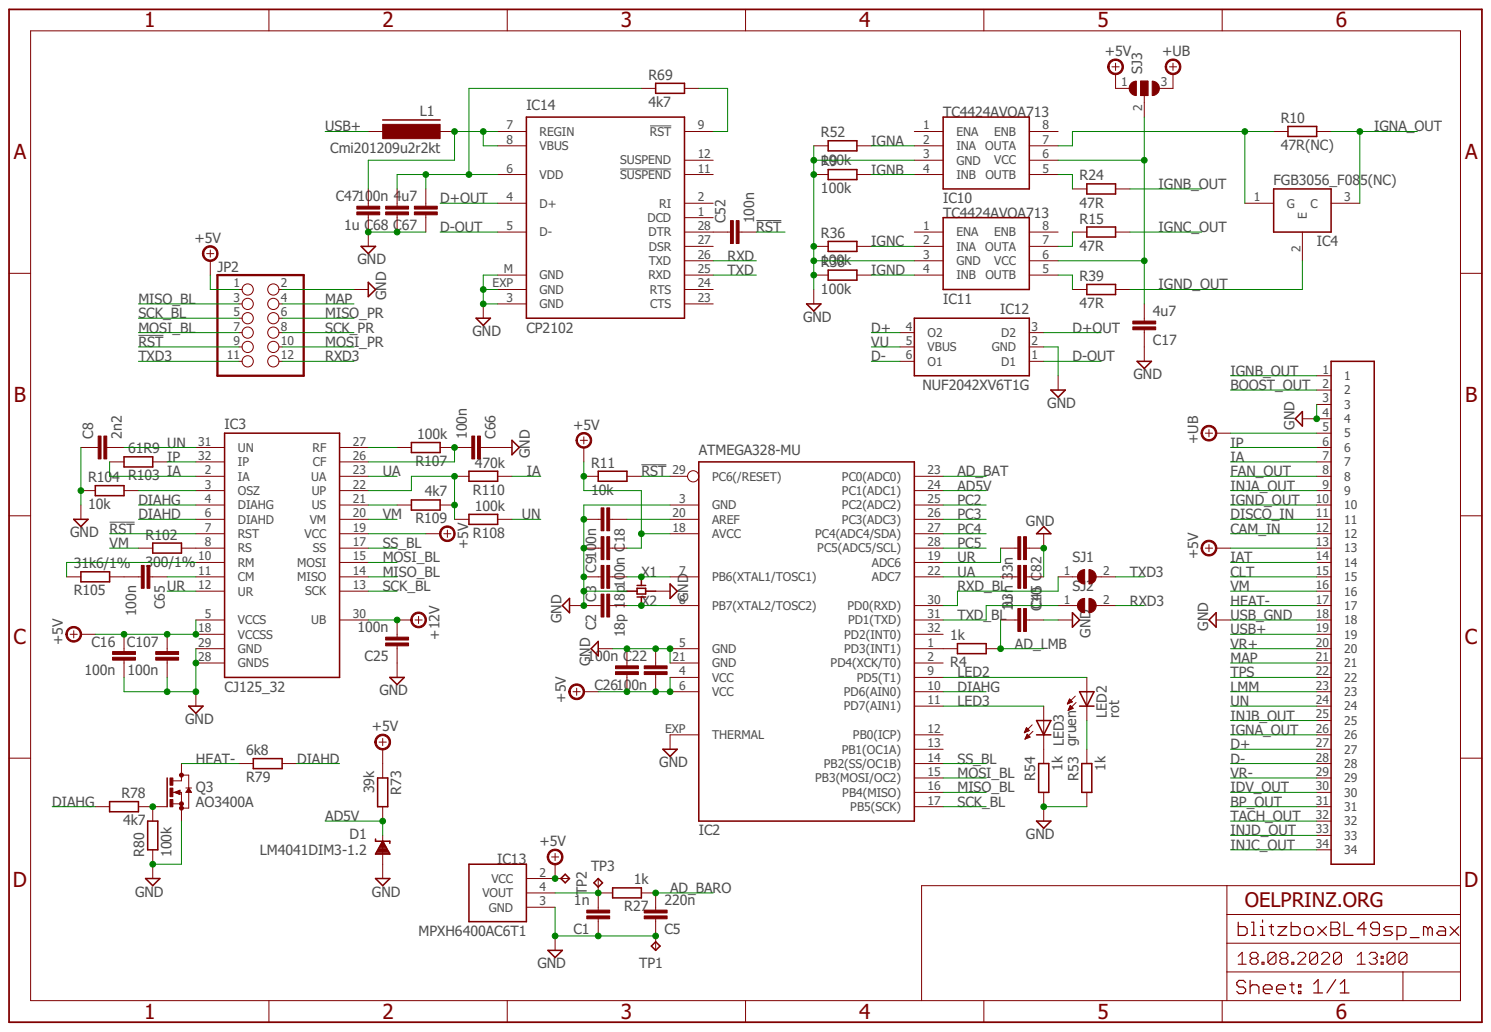
[picture p55: page 2]
