oelprinz-org/BlitzboxBL49sp/hardware/Rev0.0.3/schematics.pdf

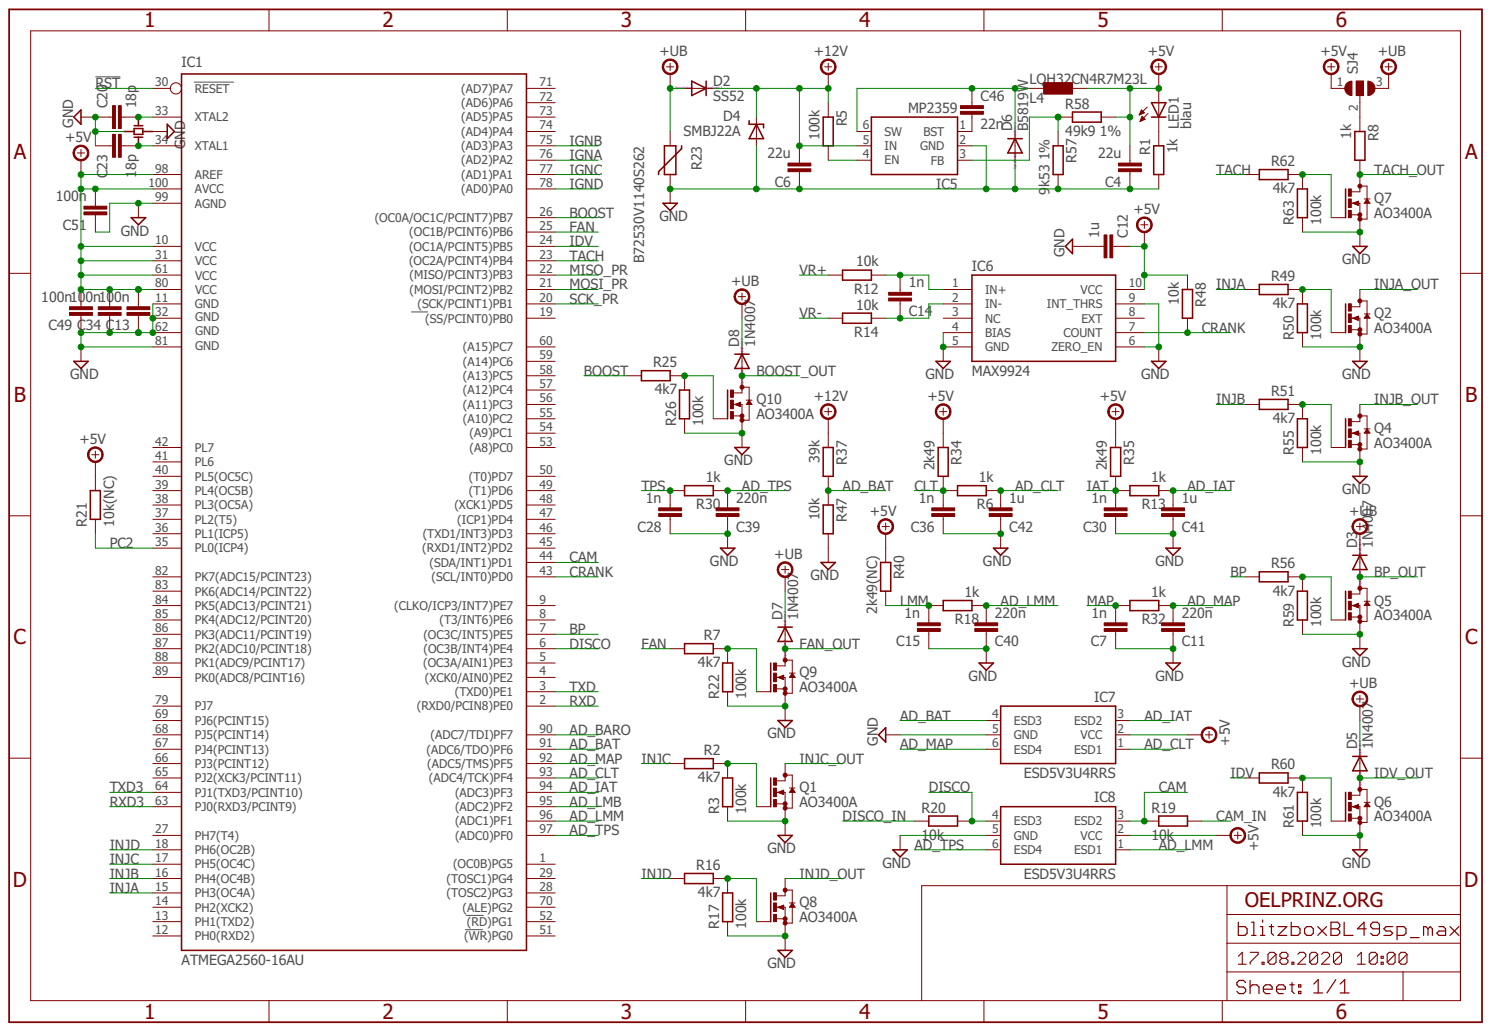
[picture p56: page 1]

SpiceOrder 1 SpiceOrder 2

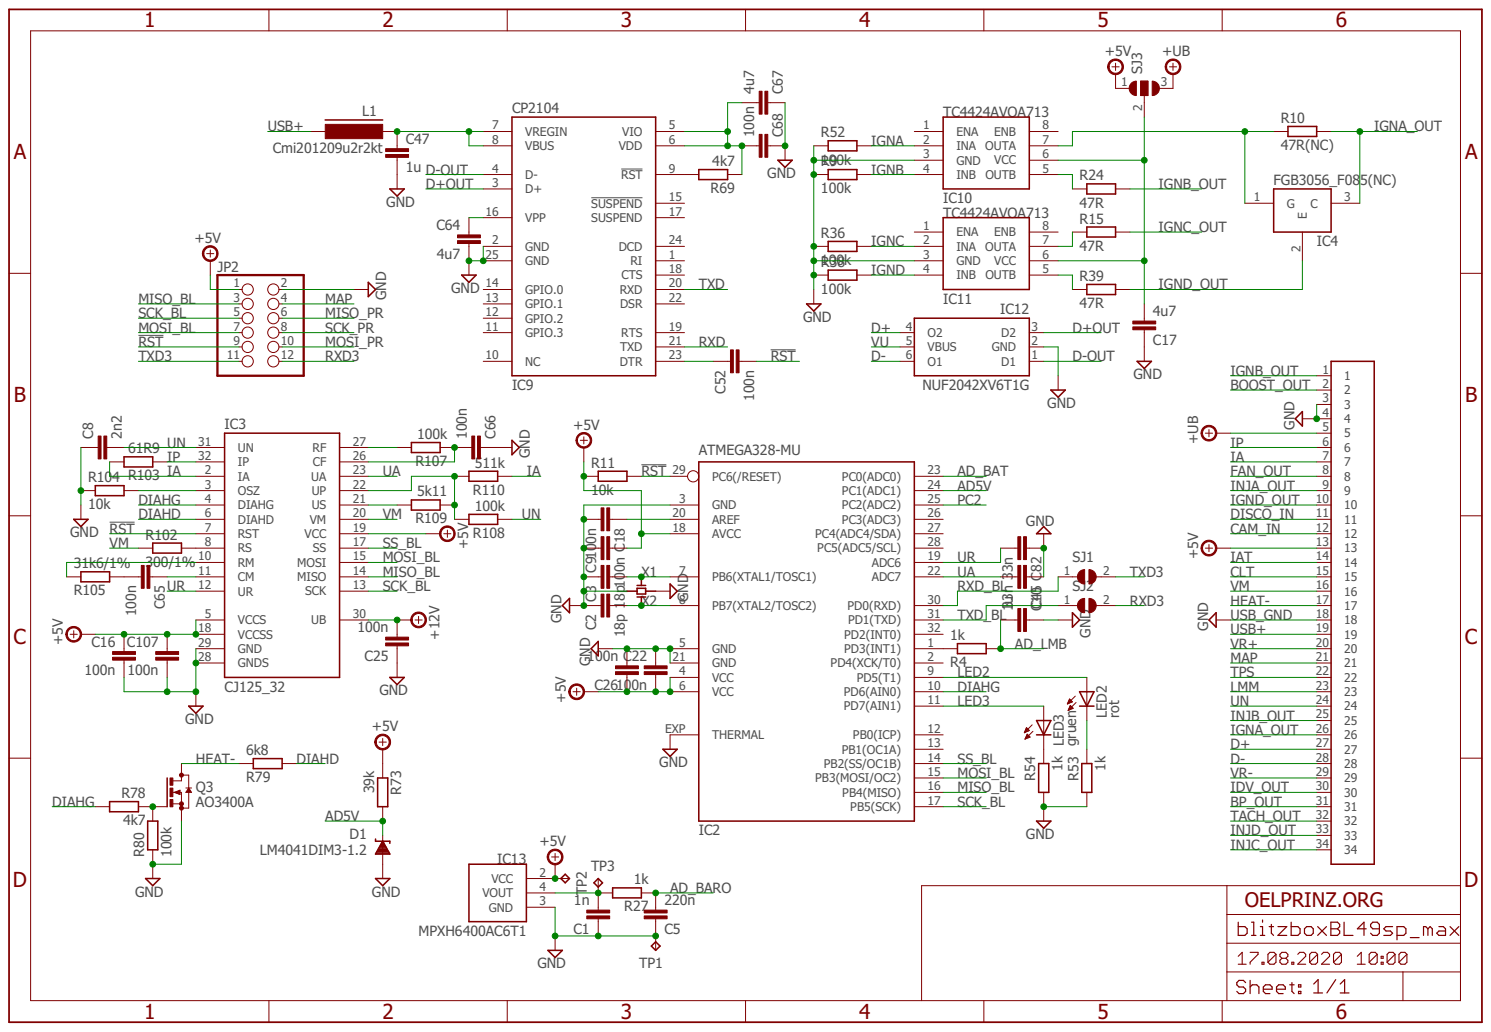
[picture p57: page 2]
