oelprinz-org/BlitzboxBL49sp/hardware/Rev0.0.1/schematics.pdf

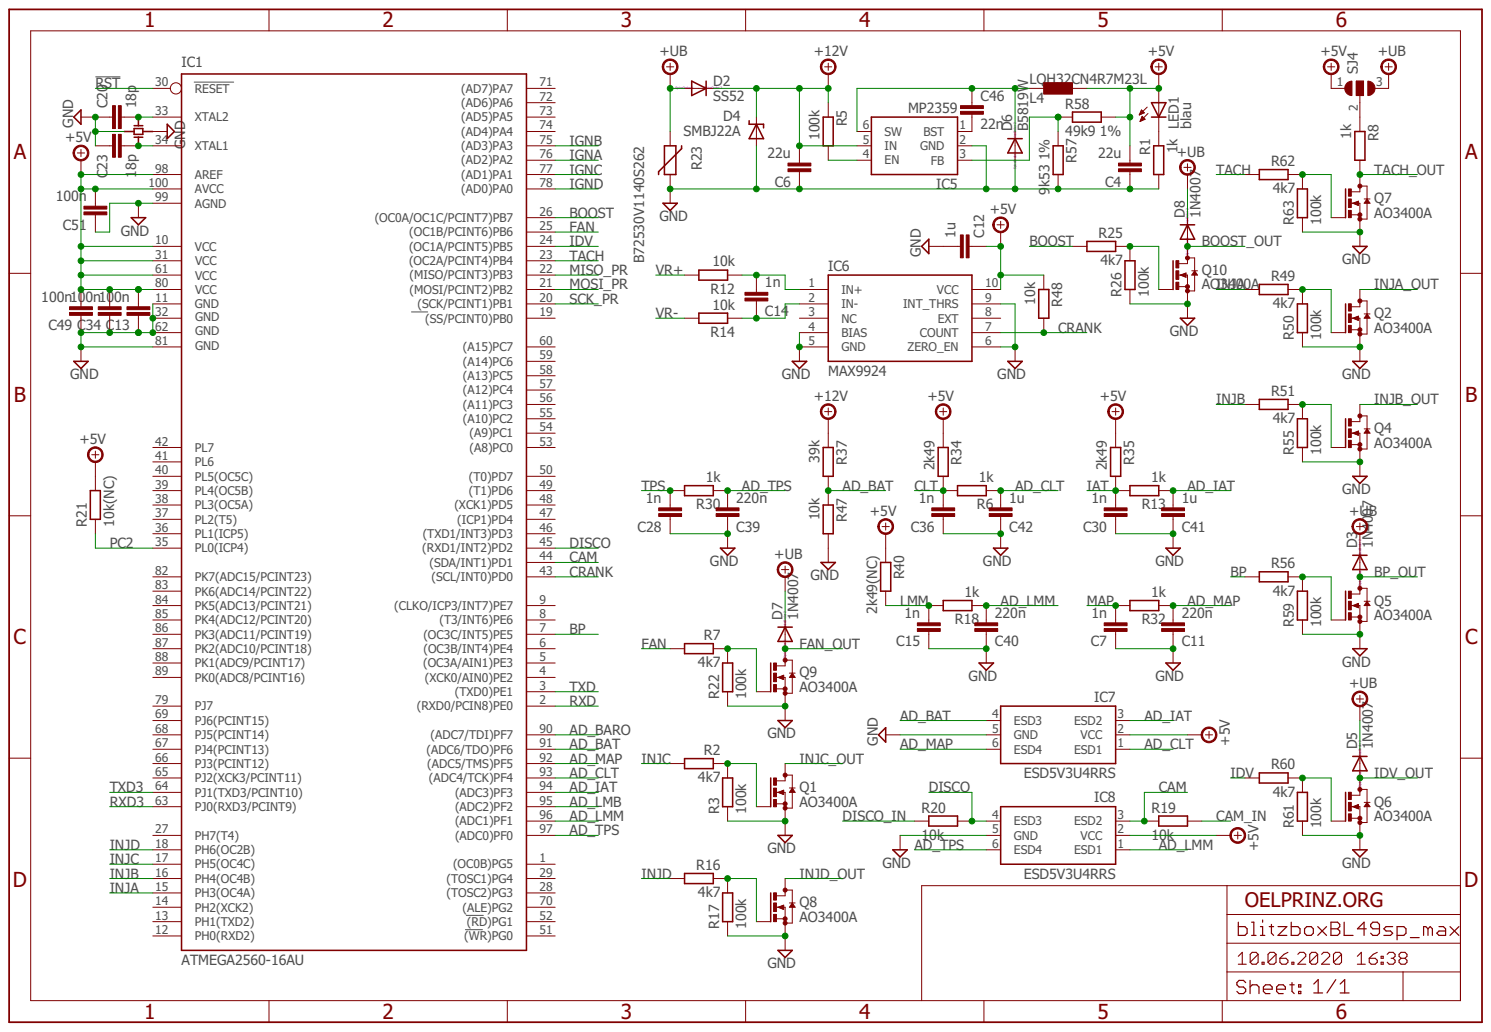
[picture p58: page 1]

SpiceOrder 1 SpiceOrder 2

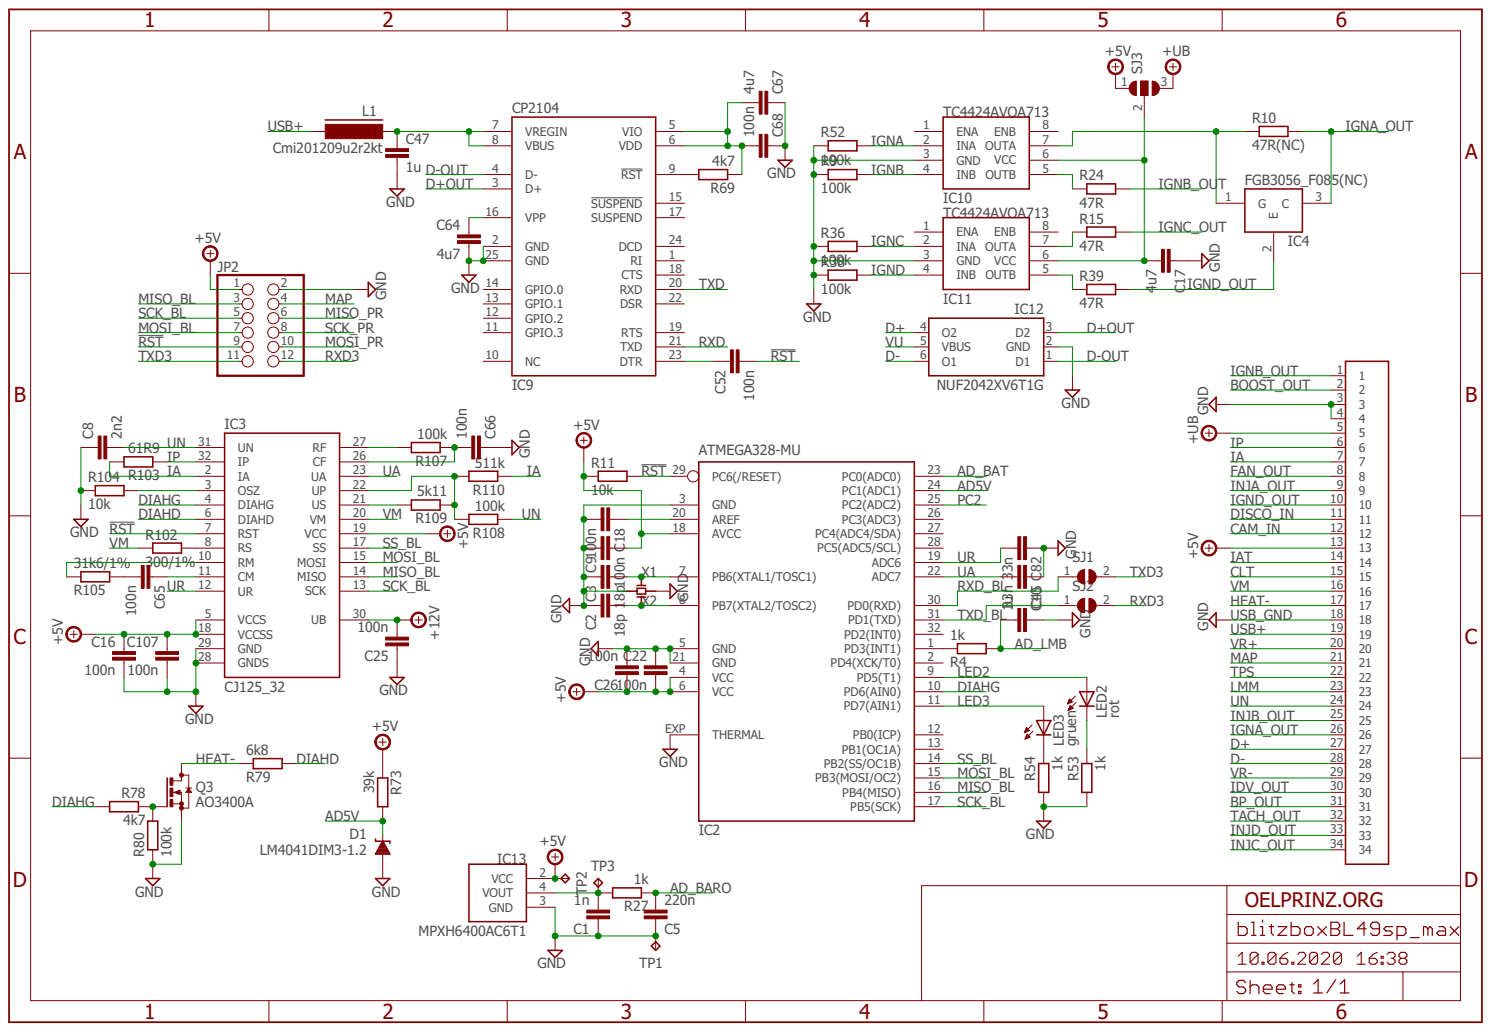
[picture p59: page 2]
