oelprinz-org/BlitzboxBL49sp/hardware/Rev0.0.2/schematics.pdf

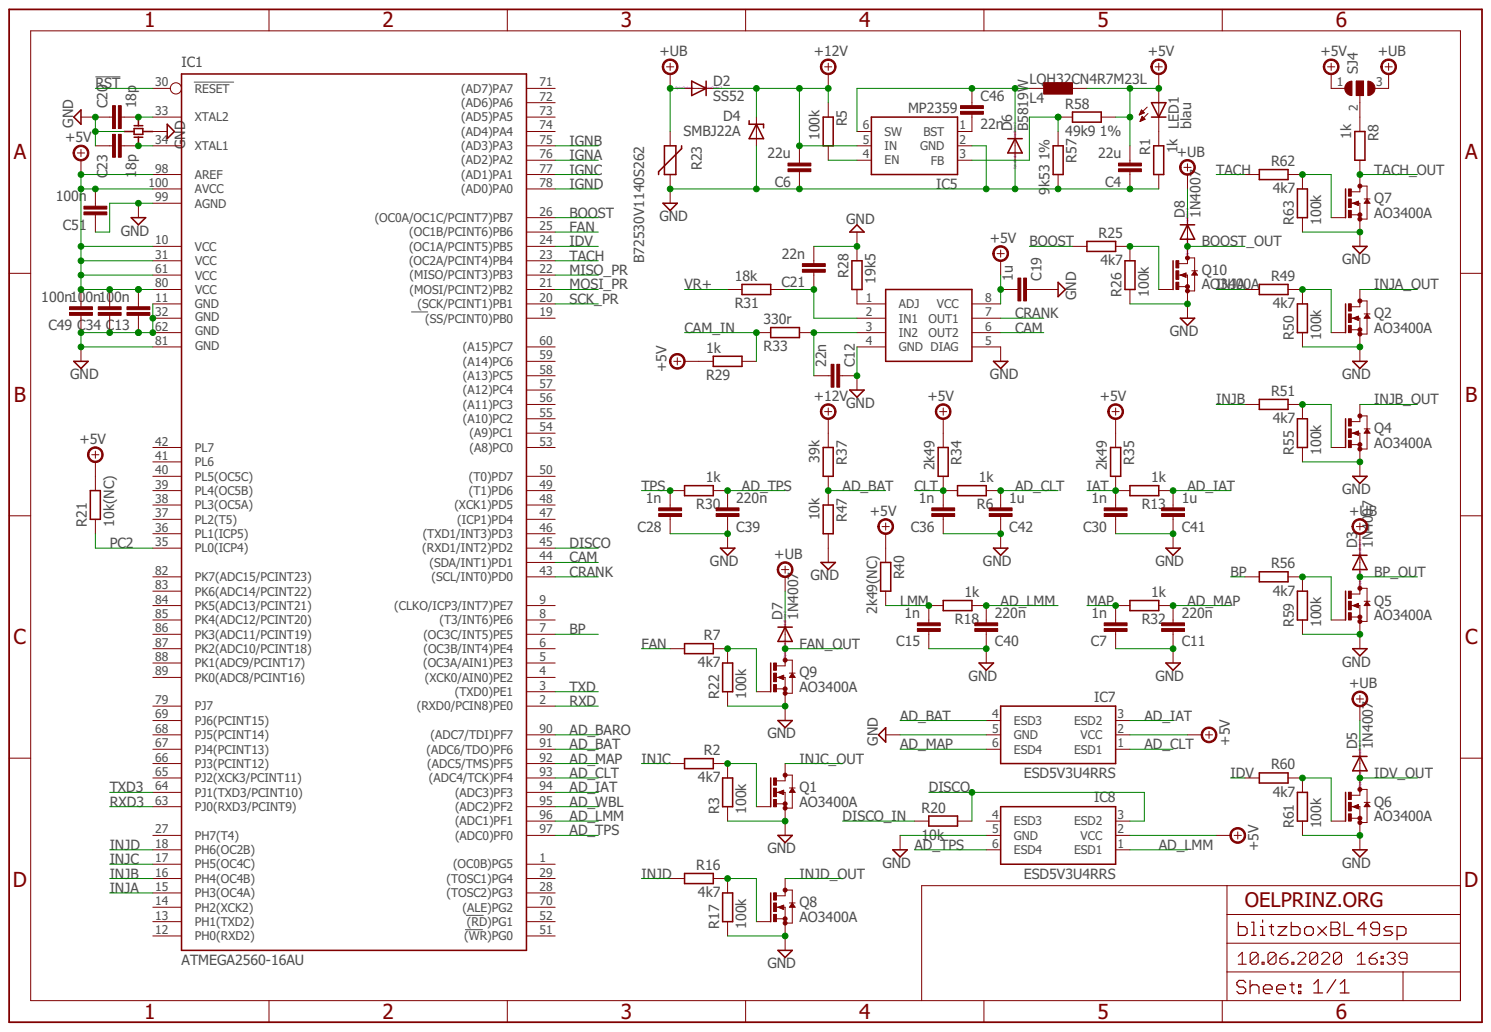
[picture p60: page 1]

SpiceOrder 1 SpiceOrder 2

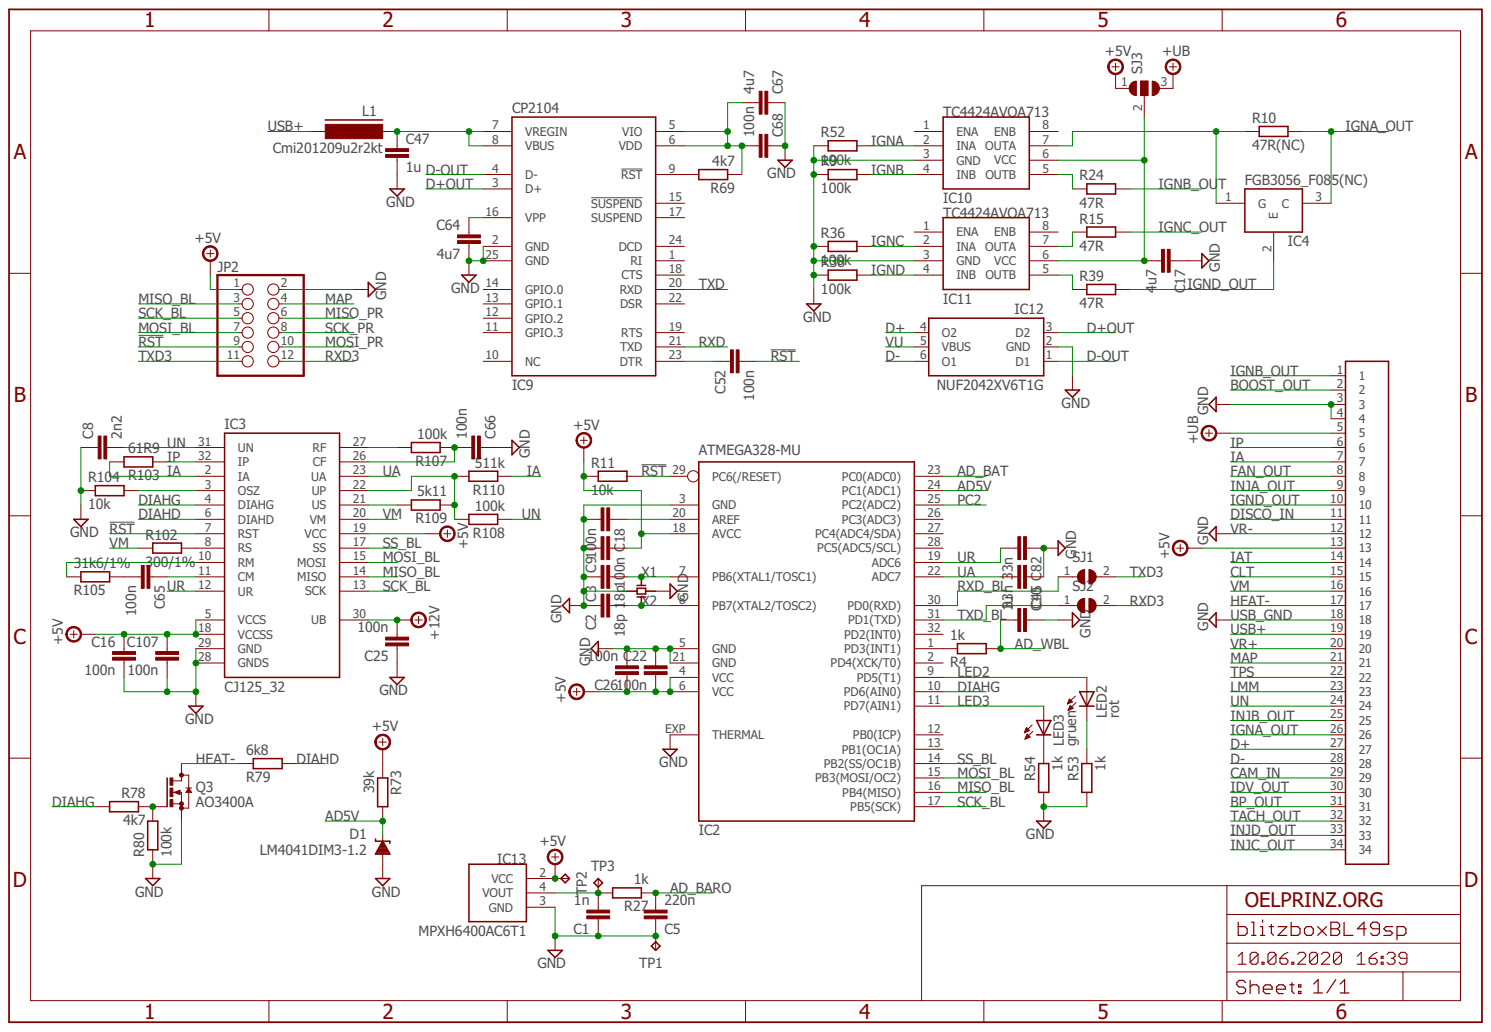
[picture p61: page 2]
