oelprinz-org/BlitzboxBL49sp/software/Onboard_WB_Lambda_V0.1.2_and_newer/Onboard_WB_Lambda_V0.1.2.ino

/* LambdaCtrl.h
 *
 *	This programm is designed to build a standalone wideband lambda controller.
 *	It's based on BOSCH CJ125 which is the interface between the lambda probe and the uC.
 *	
 *	Hardware open source BL49sp
 *	Software (c) Alfagta --> Mario Schoebinger
 *
 *	LambdaCtrl is licensed under a
 *	Creative Commons Attribution-NonCommercial 4.0 International License.
 *
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
 **/

#include "LambdaCtrl.h"

/* Global variables */
tCfg Cfg;
tAbl Abl;
tInputs In;
tOutputs Out;
tCj125 Cj;

/* Objects */
FastPID HeaterPid;

void setup()
{
	/* Reset structs */
	memset((void*)&Abl, 0, sizeof(Abl));
	memset((void*)&In, 0, sizeof(In));
	memset((void*)&Out, 0, sizeof(Out));
	memset((void*)&Cj, 0, sizeof(Cj));
	
	/* Read config from eeprom */
	eeprom_read_block((void*)&Cfg, 0, sizeof(Cfg));
	
	/* Setup io's */
	pinMode(CJ125_NSS_PIN, OUTPUT);
	pinMode(LED_STATUS_POWER, OUTPUT);
	pinMode(LED_STATUS_HEATER, OUTPUT);
	pinMode(HEATER_OUTPUT_PIN, OUTPUT);
	pinMode(LAMBDA_PWM_OUTPUT_PIN, OUTPUT);
	pinMode(EN_INPUT_PIN, INPUT_PULLUP);
//	pinMode(SP1_INPUT_PIN, INPUT_PULLUP);
//	pinMode(SP2_INPUT_PIN, INPUT_PULLUP);
	
	/* Change PWM frequency for heater pin to 122Hz */
	TCCR1B = 1 << CS12;
	/* Set I2C frequency to 400kHz */
	TWBR = ((F_CPU / 400000L) - 16) / 2;
		
	/* Preset io's */
	digitalWrite(CJ125_NSS_PIN, HIGH);
	digitalWrite(LED_STATUS_POWER, LOW);
	digitalWrite(LED_STATUS_HEATER, LOW);
	digitalWrite(HEATER_OUTPUT_PIN, LOW);
	digitalWrite(LAMBDA_PWM_OUTPUT_PIN, LOW);
	
	/* Init objects */
	HeaterPid.configure(17.0, 3.0, 0.7, 100, 8, false);

	SPI.begin();  
	SPI.setClockDivider(SPI_CLOCK_DIV8);
	SPI.setBitOrder(MSBFIRST);
	SPI.setDataMode(SPI_MODE1);
	
	Wire.begin();
	
	/* Serial */
	Serial.begin(115200);
	
	/* Wait a little bit, CJ125 needs some time for start up*/
	delay(250);
}

void loop()
{
	/* Read Inputs */	
	Inputs(&In);
	
	/* Read tick */
	Abl.Tick = millis();
	
	/* Reference voltage */
	Abl.RefVoltage = (int16_t)((uint32_t)In.URef * 5000UL / 1023UL);	//This should be exactly 1.225V so we can calculate the adc offset from this
	/* Calculate the voltage offset */
	Abl.VoltageOffset = 1225 - Abl.RefVoltage;
	/* Calculate battery voltage */
	Abl.SupplyVoltage = Abl.VoltageOffset + (int16_t)((uint32_t)In.USup * 25230UL / 1023UL);
	/* Sanity check for battery voltage */
	if (CheckUBatt() == false)
	{		
		if (Abl.Mode != PRESET) Abl.Mode = PRESET;		
	}	
	
	/* Jump to the current mode function */
	switch (Abl.Mode)
	{
	case INVALID:
		Abl.Mode = PRESET;
		break;
		
	case PRESET:
		Preset();
		break;
		
	case START:
		Start();
		break;
		
	case CALIBRATION:
		Calibrate();
		break;
		
	case IDLE:
		Idle();
		break;
		
	case CONDENSATE:
		Condensate();
		break;
		
	case PREHEAT:
		Preheat();
		break;
		
	case RUNNING:
		Running();
		break;	
	
	case ERROR:
		Error();
		break;
		
	default:
		Abl.Mode = PRESET;
		break;			
	}	
	
	/* Write Outputs */
	Outputs(&Out);

	/* Update Serial port in debug mode */
	if ((Abl.Tick - Abl.LastSerialTick) >= 150)
	{
		if (Abl.Mode == PRESET)
		{
			Out.Led1 ^= 1;
		}
		
#if (DEBUG > 1)
		Serial.print("UR:");
		Serial.println(In.UR);		
		Serial.print("UA:");
		Serial.println(In.UA);
		Serial.print("IP:");
		Serial.println(Cj.IP);
    Serial.print("Lambda:");
    Serial.println(Abl.Lambda / 100.0);	
#endif
#if (DEBUG > 0)
		Serial.print("Mode:");
		Serial.println(ModeName[Abl.Mode]);	
		Serial.print("Supply:");
		Serial.println(Abl.SupplyVoltage / 1000.0);	
		if ((Abl.CjState & CJ125_DIAG_REG_STATUS_OK) == CJ125_DIAG_REG_STATUS_OK)
		{
			Serial.print("Lambda:");
			Serial.println(Abl.Lambda / 100.0);					
		}
		else
		{
			Serial.print("Cj:");
			Serial.println(Abl.CjState, HEX);
		}
#endif	
		Abl.LastSerialTick = Abl.Tick;
	}
}
