oelprinz-org/BlitzboxBL49sp/software/202310/changes/init.ino

/** @file
 * Speeduino Initialisation (called at Arduino setup()).
 */
#include "globals.h"
#include "init.h"
#include "storage.h"
#include "updates.h"
#include "speeduino.h"
#include "timers.h"
#include "comms_secondary.h"
#include "utilities.h"
#include "scheduledIO.h"
#include "scheduler.h"
#include "schedule_calcs.h"
#include "auxiliaries.h"
#include "sensors.h"
#include "decoders.h"
#include "corrections.h"
#include "idle.h"
#include "table2d.h"
#include "acc_mc33810.h"
#include BOARD_H //Note that this is not a real file, it is defined in globals.h. 
#include EEPROM_LIB_H
#ifdef SD_LOGGING
  #include "SD_logger.h"
  #include "rtc_common.h"
#endif

/** Initialise Speeduino for the main loop.
 * Top level init entry point for all initialisations:
 * - Initialise and set sizes of 3D tables
 * - Load config from EEPROM, update config structures to current version of SW if needed.
 * - Initialise board (The initBoard() is for board X implemented in board_X.ino file)
 * - Initialise timers (See timers.ino)
 * - Perform optional SD card and RTC battery inits
 * - Load calibration tables from EEPROM
 * - Perform pin mapping (calling @ref setPinMapping() based on @ref config2.pinMapping)
 * - Stop any coil charging and close injectors
 * - Initialise schedulers, Idle, Fan, auxPWM, Corrections, AD-conversions, Programmable I/O
 * - Initialise baro (ambient pressure) by reading MAP (before engine runs)
 * - Initialise triggers (by @ref initialiseTriggers() )
 * - Perform cyl. count based initialisations (@ref config2.nCylinders)
 * - Perform injection and spark mode based setup
 *   - Assign injector open/close and coil charge begin/end functions to their dedicated global vars
 * - Perform fuel pressure priming by turning fuel pump on
 * - Read CLT and TPS sensors to have cranking pulsewidths computed correctly
 * - Mark Initialisation completed (this flag-marking is used in code to prevent after-init changes)
 */
void initialiseAll(void)
{   
    fpPrimed = false;
    injPrimed = false;

    pinMode(LED_BUILTIN, OUTPUT);
    digitalWrite(LED_BUILTIN, LOW);

    #if defined(CORE_STM32)
    configPage9.intcan_available = 1;   // device has internal canbus
    //STM32 can not currently enabled
    #endif

    /*
    ***********************************************************************************************************
    * EEPROM reset
    */
    #if defined(EEPROM_RESET_PIN)
    uint32_t start_time = millis();
    byte exit_erase_loop = false; 
    pinMode(EEPROM_RESET_PIN, INPUT_PULLUP);  

    //only start routine when this pin is low because it is pulled low
    while (digitalRead(EEPROM_RESET_PIN) != HIGH && (millis() - start_time)<1050)
    {
      //make sure the key is pressed for at least 0.5 second 
      if ((millis() - start_time)>500) {
        //if key is pressed afterboot for 0.5 second make led turn off
        digitalWrite(LED_BUILTIN, HIGH);

        //see if the user reacts to the led turned off with removing the keypress within 1 second
        while (((millis() - start_time)<1000) && (exit_erase_loop!=true)){

          //if user let go of key within 1 second erase eeprom
          if(digitalRead(EEPROM_RESET_PIN) != LOW){
            #if defined(FLASH_AS_EEPROM_h)
              EEPROM.read(0); //needed for SPI eeprom emulation.
              EEPROM.clear(); 
            #else 
              for (int i = 0 ; i < EEPROM.length() ; i++) { EEPROM.write(i, 255);}
            #endif
            //if erase done exit while loop.
            exit_erase_loop = true;
          }
        }
      } 
    }
    #endif
  
    // Unit tests should be independent of any stored configuration on the board!
#if !defined(UNIT_TEST)
    loadConfig();
    doUpdates(); //Check if any data items need updating (Occurs with firmware updates)
#endif


    //Always start with a clean slate on the bootloader capabilities level
    //This should be 0 until we hear otherwise from the 16u2
    configPage4.bootloaderCaps = 0;
    
    initBoard(); //This calls the current individual boards init function. See the board_xxx.ino files for these.
    initialiseTimers();
    
  #ifdef SD_LOGGING
    initRTC();
    initSD();
  #endif

    Serial.begin(115200);
    BIT_SET(currentStatus.status4, BIT_STATUS4_ALLOW_LEGACY_COMMS); //Flag legacy comms as being allowed on startip
    #if defined(secondarySerial_AVAILABLE)
      if (configPage9.enable_secondarySerial == 1) { secondarySerial.begin(115200); }
    #endif

    //Repoint the 2D table structs to the config pages that were just loaded
    taeTable.valueSize = SIZE_BYTE; //Set this table to use byte values
    taeTable.axisSize = SIZE_BYTE; //Set this table to use byte axis bins
    taeTable.xSize = 4;
    taeTable.values = configPage4.taeValues;
    taeTable.axisX = configPage4.taeBins;
    maeTable.valueSize = SIZE_BYTE; //Set this table to use byte values
    maeTable.axisSize = SIZE_BYTE; //Set this table to use byte axis bins
    maeTable.xSize = 4;
    maeTable.values = configPage4.maeRates;
    maeTable.axisX = configPage4.maeBins;
    WUETable.valueSize = SIZE_BYTE; //Set this table to use byte values
    WUETable.axisSize = SIZE_BYTE; //Set this table to use byte axis bins
    WUETable.xSize = 10;
    WUETable.values = configPage2.wueValues;
    WUETable.axisX = configPage4.wueBins;
    ASETable.valueSize = SIZE_BYTE;
    ASETable.axisSize = SIZE_BYTE; //Set this table to use byte axis bins
    ASETable.xSize = 4;
    ASETable.values = configPage2.asePct;
    ASETable.axisX = configPage2.aseBins;
    ASECountTable.valueSize = SIZE_BYTE;
    ASECountTable.axisSize = SIZE_BYTE; //Set this table to use byte axis bins
    ASECountTable.xSize = 4;
    ASECountTable.values = configPage2.aseCount;
    ASECountTable.axisX = configPage2.aseBins;
    PrimingPulseTable.valueSize = SIZE_BYTE;
    PrimingPulseTable.axisSize = SIZE_BYTE; //Set this table to use byte axis bins
    PrimingPulseTable.xSize = 4;
    PrimingPulseTable.values = configPage2.primePulse;
    PrimingPulseTable.axisX = configPage2.primeBins;
    crankingEnrichTable.valueSize = SIZE_BYTE;
    crankingEnrichTable.axisSize = SIZE_BYTE;
    crankingEnrichTable.xSize = 4;
    crankingEnrichTable.values = configPage10.crankingEnrichValues;
    crankingEnrichTable.axisX = configPage10.crankingEnrichBins;

    dwellVCorrectionTable.valueSize = SIZE_BYTE;
    dwellVCorrectionTable.axisSize = SIZE_BYTE; //Set this table to use byte axis bins
    dwellVCorrectionTable.xSize = 6;
    dwellVCorrectionTable.values = configPage4.dwellCorrectionValues;
    dwellVCorrectionTable.axisX = configPage6.voltageCorrectionBins;
    injectorVCorrectionTable.valueSize = SIZE_BYTE;
    injectorVCorrectionTable.axisSize = SIZE_BYTE; //Set this table to use byte axis bins
    injectorVCorrectionTable.xSize = 6;
    injectorVCorrectionTable.values = configPage6.injVoltageCorrectionValues;
    injectorVCorrectionTable.axisX = configPage6.voltageCorrectionBins;
    injectorAngleTable.valueSize = SIZE_INT;
    injectorAngleTable.axisSize = SIZE_BYTE; //Set this table to use byte axis bins
    injectorAngleTable.xSize = 4;
    injectorAngleTable.values = configPage2.injAng;
    injectorAngleTable.axisX = configPage2.injAngRPM;
    IATDensityCorrectionTable.valueSize = SIZE_BYTE;
    IATDensityCorrectionTable.axisSize = SIZE_BYTE; //Set this table to use byte axis bins
    IATDensityCorrectionTable.xSize = 9;
    IATDensityCorrectionTable.values = configPage6.airDenRates;
    IATDensityCorrectionTable.axisX = configPage6.airDenBins;
    baroFuelTable.valueSize = SIZE_BYTE;
    baroFuelTable.axisSize = SIZE_BYTE;
    baroFuelTable.xSize = 8;
    baroFuelTable.values = configPage4.baroFuelValues;
    baroFuelTable.axisX = configPage4.baroFuelBins;
    IATRetardTable.valueSize = SIZE_BYTE;
    IATRetardTable.axisSize = SIZE_BYTE; //Set this table to use byte axis bins
    IATRetardTable.xSize = 6;
    IATRetardTable.values = configPage4.iatRetValues;
    IATRetardTable.axisX = configPage4.iatRetBins;
    CLTAdvanceTable.valueSize = SIZE_BYTE;
    CLTAdvanceTable.axisSize = SIZE_BYTE; //Set this table to use byte axis bins
    CLTAdvanceTable.xSize = 6;
    CLTAdvanceTable.values = (byte*)configPage4.cltAdvValues;
    CLTAdvanceTable.axisX = configPage4.cltAdvBins;
    idleTargetTable.valueSize = SIZE_BYTE;
    idleTargetTable.axisSize = SIZE_BYTE; //Set this table to use byte axis bins
    idleTargetTable.xSize = 10;
    idleTargetTable.values = configPage6.iacCLValues;
    idleTargetTable.axisX = configPage6.iacBins;
    idleAdvanceTable.valueSize = SIZE_BYTE;
    idleAdvanceTable.axisSize = SIZE_BYTE; //Set this table to use byte axis bins
    idleAdvanceTable.xSize = 6;
    idleAdvanceTable.values = (byte*)configPage4.idleAdvValues;
    idleAdvanceTable.axisX = configPage4.idleAdvBins;
    rotarySplitTable.valueSize = SIZE_BYTE;
    rotarySplitTable.axisSize = SIZE_BYTE; //Set this table to use byte axis bins
    rotarySplitTable.xSize = 8;
    rotarySplitTable.values = configPage10.rotarySplitValues;
    rotarySplitTable.axisX = configPage10.rotarySplitBins;

    flexFuelTable.valueSize = SIZE_BYTE;
    flexFuelTable.axisSize = SIZE_BYTE; //Set this table to use byte axis bins
    flexFuelTable.xSize = 6;
    flexFuelTable.values = configPage10.flexFuelAdj;
    flexFuelTable.axisX = configPage10.flexFuelBins;
    flexAdvTable.valueSize = SIZE_BYTE;
    flexAdvTable.axisSize = SIZE_BYTE; //Set this table to use byte axis bins
    flexAdvTable.xSize = 6;
    flexAdvTable.values = configPage10.flexAdvAdj;
    flexAdvTable.axisX = configPage10.flexAdvBins;
    flexBoostTable.valueSize = SIZE_INT;
    flexBoostTable.axisSize = SIZE_BYTE; //Set this table to use byte axis bins (NOTE THIS IS DIFFERENT TO THE VALUES!!)
    flexBoostTable.xSize = 6;
    flexBoostTable.values = configPage10.flexBoostAdj;
    flexBoostTable.axisX = configPage10.flexBoostBins;
    fuelTempTable.valueSize = SIZE_BYTE;
    fuelTempTable.axisSize = SIZE_BYTE; //Set this table to use byte axis bins
    fuelTempTable.xSize = 6;
    fuelTempTable.values = configPage10.fuelTempValues;
    fuelTempTable.axisX = configPage10.fuelTempBins;

    knockWindowStartTable.valueSize = SIZE_BYTE;
    knockWindowStartTable.axisSize = SIZE_BYTE; //Set this table to use byte axis bins
    knockWindowStartTable.xSize = 6;
    knockWindowStartTable.values = configPage10.knock_window_angle;
    knockWindowStartTable.axisX = configPage10.knock_window_rpms;
    knockWindowDurationTable.valueSize = SIZE_BYTE;
    knockWindowDurationTable.axisSize = SIZE_BYTE; //Set this table to use byte axis bins
    knockWindowDurationTable.xSize = 6;
    knockWindowDurationTable.values = configPage10.knock_window_dur;
    knockWindowDurationTable.axisX = configPage10.knock_window_rpms;

    oilPressureProtectTable.valueSize = SIZE_BYTE;
    oilPressureProtectTable.axisSize = SIZE_BYTE; //Set this table to use byte axis bins
    oilPressureProtectTable.xSize = 4;
    oilPressureProtectTable.values = configPage10.oilPressureProtMins;
    oilPressureProtectTable.axisX = configPage10.oilPressureProtRPM;

    coolantProtectTable.valueSize = SIZE_BYTE;
    coolantProtectTable.axisSize = SIZE_BYTE; //Set this table to use byte axis bins
    coolantProtectTable.xSize = 6;
    coolantProtectTable.values = configPage9.coolantProtRPM;
    coolantProtectTable.axisX = configPage9.coolantProtTemp;


    fanPWMTable.valueSize = SIZE_BYTE;
    fanPWMTable.axisSize = SIZE_BYTE; //Set this table to use byte axis bins
    fanPWMTable.xSize = 4;
    fanPWMTable.values = configPage9.PWMFanDuty;
    fanPWMTable.axisX = configPage6.fanPWMBins;

    rollingCutTable.valueSize = SIZE_BYTE;
    rollingCutTable.axisSize = SIZE_SIGNED_BYTE; //X axis is SIGNED for this table. 
    rollingCutTable.xSize = 4;
    rollingCutTable.values = configPage15.rollingProtCutPercent;
    rollingCutTable.axisX = configPage15.rollingProtRPMDelta;

    wmiAdvTable.valueSize = SIZE_BYTE;
    wmiAdvTable.axisSize = SIZE_BYTE; //Set this table to use byte axis bins
    wmiAdvTable.xSize = 6;
    wmiAdvTable.values = configPage10.wmiAdvAdj;
    wmiAdvTable.axisX = configPage10.wmiAdvBins;

    cltCalibrationTable.valueSize = SIZE_INT;
    cltCalibrationTable.axisSize = SIZE_INT;
    cltCalibrationTable.xSize = 32;
    cltCalibrationTable.values = cltCalibration_values;
    cltCalibrationTable.axisX = cltCalibration_bins;

    iatCalibrationTable.valueSize = SIZE_INT;
    iatCalibrationTable.axisSize = SIZE_INT;
    iatCalibrationTable.xSize = 32;
    iatCalibrationTable.values = iatCalibration_values;
    iatCalibrationTable.axisX = iatCalibration_bins;

    o2CalibrationTable.valueSize = SIZE_BYTE;
    o2CalibrationTable.axisSize = SIZE_INT;
    o2CalibrationTable.xSize = 32;
    o2CalibrationTable.values = o2Calibration_values;
    o2CalibrationTable.axisX = o2Calibration_bins;
    
    //Setup the calibration tables
    loadCalibration();

    #if defined (NATIVE_CAN_AVAILABLE)
      configPage9.intcan_available = 1;   // device has internal canbus
      //Teensy uses the Flexcan_T4 library to use the internal canbus
      //enable local can interface
      //setup can interface to 500k   
      Can0.begin();
      Can0.setBaudRate(500000);
      Can0.enableFIFO();
    #endif

    //Set the pin mappings
    if((configPage2.pinMapping == 255) || (configPage2.pinMapping == 0)) //255 = EEPROM value in a blank AVR; 0 = EEPROM value in new FRAM
    {
      //First time running on this board
      resetConfigPages(); 
      setPinMapping(3); //Force board to v0.4
    }
    else { setPinMapping(configPage2.pinMapping); }

    /* Note: This must come after the call to setPinMapping() or else pins 29 and 30 will become unusable as outputs.
     * Workaround for: https://github.com/tonton81/FlexCAN_T4/issues/14 */
    #if defined(CORE_TEENSY35)
      Can0.setRX(DEF);
      Can0.setTX(DEF);
    #endif

    //End all coil charges to ensure no stray sparks on startup
    endCoil1Charge();
    endCoil2Charge();
    endCoil3Charge();
    endCoil4Charge();
    endCoil5Charge();
    #if (IGN_CHANNELS >= 6)
    endCoil6Charge();
    #endif
    #if (IGN_CHANNELS >= 7)
    endCoil7Charge();
    #endif
    #if (IGN_CHANNELS >= 8)
    endCoil8Charge();
    #endif

    //Similar for injectors, make sure they're turned off
    closeInjector1();
    closeInjector2();
    closeInjector3();
    closeInjector4();
    closeInjector5();
    #if (INJ_CHANNELS >= 6)
    closeInjector6();
    #endif
    #if (INJ_CHANNELS >= 7)
    closeInjector7();
    #endif
    #if (INJ_CHANNELS >= 8)
    closeInjector8();
    #endif
    
    //Set the tacho output default state
    digitalWrite(pinTachOut, HIGH);
    //Perform all initialisations
    initialiseSchedulers();
    //initialiseDisplay();
    initialiseIdle(true);
    initialiseFan();
    initialiseAirCon();
    initialiseAuxPWM();
    initialiseCorrections();
    BIT_CLEAR(currentStatus.engineProtectStatus, PROTECT_IO_ERROR); //Clear the I/O error bit. The bit will be set in initialiseADC() if there is problem in there.
    initialiseADC();
    initialiseProgrammableIO();

    //Check whether the flex sensor is enabled and if so, attach an interrupt for it
    if(configPage2.flexEnabled > 0)
    {
      attachInterrupt(digitalPinToInterrupt(pinFlex), flexPulse, CHANGE);
      currentStatus.ethanolPct = 0;
    }
    //Same as above, but for the VSS input
    if(configPage2.vssMode > 1) // VSS modes 2 and 3 are interrupt drive (Mode 1 is CAN)
    {
      attachInterrupt(digitalPinToInterrupt(pinVSS), vssPulse, RISING);
    }

    //Once the configs have been loaded, a number of one time calculations can be completed
    req_fuel_uS = configPage2.reqFuel * 100; //Convert to uS and an int. This is the only variable to be used in calculations
    inj_opentime_uS = configPage2.injOpen * 100; //Injector open time. Comes through as ms*10 (Eg 15.5ms = 155).

    if(configPage10.stagingEnabled == true)
    {
    uint32_t totalInjector = configPage10.stagedInjSizePri + configPage10.stagedInjSizeSec;
    /*
        These values are a percentage of the req_fuel value that would be required for each injector channel to deliver that much fuel.
        Eg:
        Pri injectors are 250cc
        Sec injectors are 500cc
        Total injector capacity = 750cc

        staged_req_fuel_mult_pri = 300% (The primary injectors would have to run 3x the overall PW in order to be the equivalent of the full 750cc capacity
        staged_req_fuel_mult_sec = 150% (The secondary injectors would have to run 1.5x the overall PW in order to be the equivalent of the full 750cc capacity
    */
    staged_req_fuel_mult_pri = (100 * totalInjector) / configPage10.stagedInjSizePri;
    staged_req_fuel_mult_sec = (100 * totalInjector) / configPage10.stagedInjSizeSec;
    }

    if (configPage4.trigPatternSec == SEC_TRIGGER_POLL && configPage4.TrigPattern == DECODER_MISSING_TOOTH)
    { configPage4.TrigEdgeSec = configPage4.PollLevelPolarity; } // set the secondary trigger edge automatically to correct working value with poll level mode to enable cam angle detection in closed loop vvt.
    //Explanation: currently cam trigger for VVT is only captured when revolution one == 1. So we need to make sure that the edge trigger happens on the first revolution. So now when we set the poll level to be low
    //on revolution one and it's checked at tooth #1. This means that the cam signal needs to go high during the first revolution to be high on next revolution at tooth #1. So poll level low = cam trigger edge rising.

    //Begin the main crank trigger interrupt pin setup
    //The interrupt numbering is a bit odd - See here for reference: arduino.cc/en/Reference/AttachInterrupt
    //These assignments are based on the Arduino Mega AND VARY BETWEEN BOARDS. Please confirm the board you are using and update accordingly.
    currentStatus.RPM = 0;
    currentStatus.hasSync = false;
    BIT_CLEAR(currentStatus.status3, BIT_STATUS3_HALFSYNC);
    currentStatus.runSecs = 0;
    currentStatus.secl = 0;
    //currentStatus.seclx10 = 0;
    currentStatus.startRevolutions = 0;
    currentStatus.syncLossCounter = 0;
    currentStatus.flatShiftingHard = false;
    currentStatus.launchingHard = false;
    currentStatus.crankRPM = ((unsigned int)configPage4.crankRPM * 10); //Crank RPM limit (Saves us calculating this over and over again. It's updated once per second in timers.ino)
    currentStatus.fuelPumpOn = false;
    currentStatus.engineProtectStatus = 0;
    triggerFilterTime = 0; //Trigger filter time is the shortest possible time (in uS) that there can be between crank teeth (ie at max RPM). Any pulses that occur faster than this time will be discarded as noise. This is simply a default value, the actual values are set in the setup() functions of each decoder
    dwellLimit_uS = (1000 * configPage4.dwellLimit);
    currentStatus.nChannels = ((uint8_t)INJ_CHANNELS << 4) + IGN_CHANNELS; //First 4 bits store the number of injection channels, 2nd 4 store the number of ignition channels
    fpPrimeTime = 0;
    ms_counter = 0;
    fixedCrankingOverride = 0;
    timer5_overflow_count = 0;
    toothHistoryIndex = 0;
    toothLastToothTime = 0;

    //Lookup the current MAP reading for barometric pressure
    instanteneousMAPReading();
    readBaro();
    
    noInterrupts();
    initialiseTriggers();

    //The secondary input can be used for VSS if nothing else requires it. Allows for the standard VR conditioner to be used for VSS. This MUST be run after the initialiseTriggers() function
    if( VSS_USES_RPM2() ) { attachInterrupt(digitalPinToInterrupt(pinVSS), vssPulse, RISING); } //Secondary trigger input can safely be used for VSS
    if( FLEX_USES_RPM2() ) { attachInterrupt(digitalPinToInterrupt(pinFlex), flexPulse, CHANGE); } //Secondary trigger input can safely be used for Flex sensor

    //End crank trigger interrupt attachment
    if(configPage2.strokes == FOUR_STROKE)
    {
      //Default is 1 squirt per revolution, so we halve the given req-fuel figure (Which would be over 2 revolutions)
      req_fuel_uS = req_fuel_uS / 2; //The req_fuel calculation above gives the total required fuel (At VE 100%) in the full cycle. If we're doing more than 1 squirt per cycle then we need to split the amount accordingly. (Note that in a non-sequential 4-stroke setup you cannot have less than 2 squirts as you cannot determine the stroke to make the single squirt on)
    }

    //Initial values for loop times
    currentLoopTime = micros_safe();
    mainLoopCount = 0;

    if(configPage2.divider == 0) { currentStatus.nSquirts = 2; } //Safety check.
    else { currentStatus.nSquirts = configPage2.nCylinders / configPage2.divider; } //The number of squirts being requested. This is manually overridden below for sequential setups (Due to TS req_fuel calc limitations)
    if(currentStatus.nSquirts == 0) { currentStatus.nSquirts = 1; } //Safety check. Should never happen as TS will give an error, but leave in case tune is manually altered etc. 

    //Calculate the number of degrees between cylinders
    //Set some default values. These will be updated below if required.
    CRANK_ANGLE_MAX_IGN = 360;
    CRANK_ANGLE_MAX_INJ = 360;

    maxInjOutputs = 1; // Disable all injectors expect channel 1

    ignition1EndAngle = 0;
    ignition2EndAngle = 0;
    ignition3EndAngle = 0;
    ignition4EndAngle = 0;
#if IGN_CHANNELS >= 5
    ignition5EndAngle = 0;
#endif
#if IGN_CHANNELS >= 6
    ignition6EndAngle = 0;
#endif
#if IGN_CHANNELS >= 7
    ignition7EndAngle = 0;
#endif
#if IGN_CHANNELS >= 8
    ignition8EndAngle = 0;
#endif

    if(configPage2.strokes == FOUR_STROKE) { CRANK_ANGLE_MAX_INJ = 720 / currentStatus.nSquirts; }
    else { CRANK_ANGLE_MAX_INJ = 360 / currentStatus.nSquirts; }

    switch (configPage2.nCylinders) {
    case 1:
        channel1IgnDegrees = 0;
        channel1InjDegrees = 0;
        maxIgnOutputs = 1;
        maxInjOutputs = 1;

        //Sequential ignition works identically on a 1 cylinder whether it's odd or even fire. 
        if( (configPage4.sparkMode == IGN_MODE_SEQUENTIAL) && (configPage2.strokes == FOUR_STROKE) ) { CRANK_ANGLE_MAX_IGN = 720; }

        if ( (configPage2.injLayout == INJ_SEQUENTIAL) && (configPage2.strokes == FOUR_STROKE) )
        {
          CRANK_ANGLE_MAX_INJ = 720;
          currentStatus.nSquirts = 1;
          req_fuel_uS = req_fuel_uS * 2;
        }

        //Check if injector staging is enabled
        if(configPage10.stagingEnabled == true)
        {
          maxInjOutputs = 2;
          channel2InjDegrees = channel1InjDegrees;
        }
        break;

    case 2:
        channel1IgnDegrees = 0;
        channel1InjDegrees = 0;
        maxIgnOutputs = 2;
        maxInjOutputs = 2;
        if (configPage2.engineType == EVEN_FIRE ) { channel2IgnDegrees = 180; }
        else { channel2IgnDegrees = configPage2.oddfire2; }

        //Sequential ignition works identically on a 2 cylinder whether it's odd or even fire (With the default being a 180 degree second cylinder).
        if( (configPage4.sparkMode == IGN_MODE_SEQUENTIAL) && (configPage2.strokes == FOUR_STROKE) ) { CRANK_ANGLE_MAX_IGN = 720; }

        if ( (configPage2.injLayout == INJ_SEQUENTIAL) && (configPage2.strokes == FOUR_STROKE) )
        {
          CRANK_ANGLE_MAX_INJ = 720;
          currentStatus.nSquirts = 1;
          req_fuel_uS = req_fuel_uS * 2;
        }
        //The below are true regardless of whether this is running sequential or not
        if (configPage2.engineType == EVEN_FIRE ) { channel2InjDegrees = 180; }
        else { channel2InjDegrees = configPage2.oddfire2; }
        if (!configPage2.injTiming) 
        { 
          //For simultaneous, all squirts happen at the same time
          channel1InjDegrees = 0;
          channel2InjDegrees = 0; 
        }

        //Check if injector staging is enabled
        if(configPage10.stagingEnabled == true)
        {
          maxInjOutputs = 4;

          channel3InjDegrees = channel1InjDegrees;
          channel4InjDegrees = channel2InjDegrees;
        }

        break;

    case 3:
        channel1IgnDegrees = 0;
        maxIgnOutputs = 3;
        maxInjOutputs = 3;
        if (configPage2.engineType == EVEN_FIRE )
        {
          //Sequential and Single channel modes both run over 720 crank degrees, but only on 4 stroke engines.
          if( ( (configPage4.sparkMode == IGN_MODE_SEQUENTIAL) || (configPage4.sparkMode == IGN_MODE_SINGLE) ) && (configPage2.strokes == FOUR_STROKE) )
          {
            channel2IgnDegrees = 240;
            channel3IgnDegrees = 480;

            CRANK_ANGLE_MAX_IGN = 720;
          }
          else
          {
            channel2IgnDegrees = 120;
            channel3IgnDegrees = 240;
          }
        }
        else
        {
          channel2IgnDegrees = configPage2.oddfire2;
          channel3IgnDegrees = configPage2.oddfire3;
        }

        //For alternating injection, the squirt occurs at different times for each channel
        if( (configPage2.injLayout == INJ_SEMISEQUENTIAL) || (configPage2.injLayout == INJ_PAIRED) )
        {
          channel1InjDegrees = 0;
          channel2InjDegrees = 120;
          channel3InjDegrees = 240;

          //Adjust the injection angles based on the number of squirts
          if (currentStatus.nSquirts > 2)
          {
            channel2InjDegrees = (channel2InjDegrees * 2) / currentStatus.nSquirts;
            channel3InjDegrees = (channel3InjDegrees * 2) / currentStatus.nSquirts;
          }

          if (!configPage2.injTiming) 
          { 
            //For simultaneous, all squirts happen at the same time
            channel1InjDegrees = 0;
            channel2InjDegrees = 0;
            channel3InjDegrees = 0; 
          } 
        }
        else if (configPage2.injLayout == INJ_SEQUENTIAL)
        {
          currentStatus.nSquirts = 1;

          if(configPage2.strokes == TWO_STROKE)
          {
            channel1InjDegrees = 0;
            channel2InjDegrees = 120;
            channel3InjDegrees = 240;
            CRANK_ANGLE_MAX_INJ = 360;
          }
          else
          {
            req_fuel_uS = req_fuel_uS * 2;
            channel1InjDegrees = 0;
            channel2InjDegrees = 240;
            channel3InjDegrees = 480;
            CRANK_ANGLE_MAX_INJ = 720;
          }
        }
        else
        {
          //Should never happen, but default values
          channel1InjDegrees = 0;
          channel2InjDegrees = 120;
          channel3InjDegrees = 240;
        }

        //Check if injector staging is enabled
        if(configPage10.stagingEnabled == true)
        {
          #if INJ_CHANNELS >= 6
            maxInjOutputs = 6;

            channel4InjDegrees = channel1InjDegrees;
            channel5InjDegrees = channel2InjDegrees;
            channel6InjDegrees = channel3InjDegrees;
          #else
            //Staged output is on channel 4
            maxInjOutputs = 4;
            channel4InjDegrees = channel1InjDegrees;
          #endif
        }
        break;
    case 4:
        channel1IgnDegrees = 0;
        channel1InjDegrees = 0;
        maxIgnOutputs = 2; //Default value for 4 cylinder, may be changed below
        maxInjOutputs = 2;
        if (configPage2.engineType == EVEN_FIRE )
        {
          channel2IgnDegrees = 180;

          if( (configPage4.sparkMode == IGN_MODE_SEQUENTIAL) && (configPage2.strokes == FOUR_STROKE) )
          {
            channel3IgnDegrees = 360;
            channel4IgnDegrees = 540;

            CRANK_ANGLE_MAX_IGN = 720;
            maxIgnOutputs = 4;
          }
          if(configPage4.sparkMode == IGN_MODE_ROTARY)
          {
            //Rotary uses the ign 3 and 4 schedules for the trailing spark. They are offset from the ign 1 and 2 channels respectively and so use the same degrees as them
            channel3IgnDegrees = 0;
            channel4IgnDegrees = 180;
            maxIgnOutputs = 4;

            configPage4.IgInv = GOING_LOW; //Force Going Low ignition mode (Going high is never used for rotary)
          }
        }
        else
        {
          channel2IgnDegrees = configPage2.oddfire2;
          channel3IgnDegrees = configPage2.oddfire3;
          channel4IgnDegrees = configPage2.oddfire4;
          maxIgnOutputs = 4;
        }

        //For alternating injection, the squirt occurs at different times for each channel
        if( (configPage2.injLayout == INJ_SEMISEQUENTIAL) || (configPage2.injLayout == INJ_PAIRED) || (configPage2.strokes == TWO_STROKE) )
        {
          channel2InjDegrees = 180;

          if (!configPage2.injTiming) 
          { 
            //For simultaneous, all squirts happen at the same time
            channel1InjDegrees = 0;
            channel2InjDegrees = 0; 
          }
          else if (currentStatus.nSquirts > 2)
          {
            //Adjust the injection angles based on the number of squirts
            channel2InjDegrees = (channel2InjDegrees * 2) / currentStatus.nSquirts;
          }
          else { } //Do nothing, default values are correct
        }
        else if (configPage2.injLayout == INJ_SEQUENTIAL)
        {
          channel2InjDegrees = 180;
          channel3InjDegrees = 360;
          channel4InjDegrees = 540;

          maxInjOutputs = 4;

          CRANK_ANGLE_MAX_INJ = 720;
          currentStatus.nSquirts = 1;
          req_fuel_uS = req_fuel_uS * 2;
        }
        else
        {
          //Should never happen, but default values
          maxInjOutputs = 2;
        }

        //Check if injector staging is enabled
        if(configPage10.stagingEnabled == true)
        {
          maxInjOutputs = 4;

          if( (configPage2.injLayout == INJ_SEQUENTIAL) || (configPage2.injLayout == INJ_SEMISEQUENTIAL) )
          {
            //Staging with 4 cylinders semi/sequential requires 8 total channels
            #if INJ_CHANNELS >= 8
              maxInjOutputs = 8;

              channel5InjDegrees = channel1InjDegrees;
              channel6InjDegrees = channel2InjDegrees;
              channel7InjDegrees = channel3InjDegrees;
              channel8InjDegrees = channel4InjDegrees;
            #else
              //This is an invalid config as there are not enough outputs to support sequential + staging
              //Put the staging output to the non-existant channel 5
              #if (INJ_CHANNELS >= 5)
              maxInjOutputs = 5;
              channel5InjDegrees = channel1InjDegrees;
              #endif
            #endif
          }
          else
          {
            channel3InjDegrees = channel1InjDegrees;
            channel4InjDegrees = channel2InjDegrees;
          }
        }

        break;
    case 5:
        channel1IgnDegrees = 0;
        channel2IgnDegrees = 72;
        channel3IgnDegrees = 144;
        channel4IgnDegrees = 216;
        channel5IgnDegrees = 288;
        maxIgnOutputs = 5; //Only 4 actual outputs, so that's all that can be cut
        maxInjOutputs = 4; //Is updated below to 5 if there are enough channels

        if(configPage4.sparkMode == IGN_MODE_SEQUENTIAL)
        {
          channel2IgnDegrees = 144;
          channel3IgnDegrees = 288;
          channel4IgnDegrees = 432;
          channel5IgnDegrees = 576;

          CRANK_ANGLE_MAX_IGN = 720;
        }

        //For alternating injection, the squirt occurs at different times for each channel
        if( (configPage2.injLayout == INJ_SEMISEQUENTIAL) || (configPage2.injLayout == INJ_PAIRED) || (configPage2.strokes == TWO_STROKE) )
        {
          if (!configPage2.injTiming) 
          { 
            //For simultaneous, all squirts happen at the same time
            channel1InjDegrees = 0;
            channel2InjDegrees = 0;
            channel3InjDegrees = 0;
            channel4InjDegrees = 0;
#if (INJ_CHANNELS >= 5)
            channel5InjDegrees = 0; 
#endif
          }
          else
          {
            channel1InjDegrees = 0;
            channel2InjDegrees = 72;
            channel3InjDegrees = 144;
            channel4InjDegrees = 216;
#if (INJ_CHANNELS >= 5)
            channel5InjDegrees = 288;
#endif

            //Divide by currentStatus.nSquirts ?
          }
        }
    #if INJ_CHANNELS >= 5
        else if (configPage2.injLayout == INJ_SEQUENTIAL)
        {
          channel1InjDegrees = 0;
          channel2InjDegrees = 144;
          channel3InjDegrees = 288;
          channel4InjDegrees = 432;
          channel5InjDegrees = 576;

          maxInjOutputs = 5;

          CRANK_ANGLE_MAX_INJ = 720;
          currentStatus.nSquirts = 1;
          req_fuel_uS = req_fuel_uS * 2;
        }
    #endif

    #if INJ_CHANNELS >= 6
          if(configPage10.stagingEnabled == true) { maxInjOutputs = 6; }
    #endif
        break;
    case 6:
        channel1IgnDegrees = 0;
        channel2IgnDegrees = 120;
        channel3IgnDegrees = 240;
        maxIgnOutputs = 3;
        maxInjOutputs = 3;

    #if IGN_CHANNELS >= 6
        if( (configPage4.sparkMode == IGN_MODE_SEQUENTIAL))
        {
        channel4IgnDegrees = 360;
        channel5IgnDegrees = 480;
        channel6IgnDegrees = 600;
        CRANK_ANGLE_MAX_IGN = 720;
        maxIgnOutputs = 6;
        }
    #endif

        //For alternating injection, the squirt occurs at different times for each channel
        if( (configPage2.injLayout == INJ_SEMISEQUENTIAL) || (configPage2.injLayout == INJ_PAIRED) )
        {
          channel1InjDegrees = 0;
          channel2InjDegrees = 120;
          channel3InjDegrees = 240;
          if (!configPage2.injTiming)
          {
            //For simultaneous, all squirts happen at the same time
            channel1InjDegrees = 0;
            channel2InjDegrees = 0;
            channel3InjDegrees = 0;
          }
          else if (currentStatus.nSquirts > 2)
          {
            //Adjust the injection angles based on the number of squirts
            channel2InjDegrees = (channel2InjDegrees * 2) / currentStatus.nSquirts;
            channel3InjDegrees = (channel3InjDegrees * 2) / currentStatus.nSquirts;
          }
        }

    #if INJ_CHANNELS >= 6
        if (configPage2.injLayout == INJ_SEQUENTIAL)
        {
          channel1InjDegrees = 0;
          channel2InjDegrees = 120;
          channel3InjDegrees = 240;
          channel4InjDegrees = 360;
          channel5InjDegrees = 480;
          channel6InjDegrees = 600;

          maxInjOutputs = 6;

          CRANK_ANGLE_MAX_INJ = 720;
          currentStatus.nSquirts = 1;
          req_fuel_uS = req_fuel_uS * 2;
        }
        else if(configPage10.stagingEnabled == true) //Check if injector staging is enabled
        {
          maxInjOutputs = 6;

          if( (configPage2.injLayout == INJ_SEQUENTIAL) || (configPage2.injLayout == INJ_SEMISEQUENTIAL) )
          {
            //Staging with 6 cylinders semi/sequential requires 7 total channels
            #if INJ_CHANNELS >= 7
              maxInjOutputs = 7;

              channel5InjDegrees = channel1InjDegrees;
              channel6InjDegrees = channel2InjDegrees;
              channel7InjDegrees = channel3InjDegrees;
              channel8InjDegrees = channel4InjDegrees;
            #else
              //This is an invalid config as there are not enough outputs to support sequential + staging
              //Put the staging output to the non-existant channel 7
              maxInjOutputs = 7;
              channel7InjDegrees = channel1InjDegrees;
            #endif
          }
        }
    #endif
        break;
    case 8:
        channel1IgnDegrees = 0;
        channel2IgnDegrees = 90;
        channel3IgnDegrees = 180;
        channel4IgnDegrees = 270;
        maxIgnOutputs = 4;
        maxInjOutputs = 4;


        if( (configPage4.sparkMode == IGN_MODE_SINGLE))
        {
          maxIgnOutputs = 4;
          CRANK_ANGLE_MAX_IGN = 360;
        }
    

    #if IGN_CHANNELS >= 8
        if( (configPage4.sparkMode == IGN_MODE_SEQUENTIAL))
        {
        channel5IgnDegrees = 360;
        channel6IgnDegrees = 450;
        channel7IgnDegrees = 540;
        channel8IgnDegrees = 630;
        maxIgnOutputs = 8;
        CRANK_ANGLE_MAX_IGN = 720;
        }
    #endif

        //For alternating injection, the squirt occurs at different times for each channel
        if( (configPage2.injLayout == INJ_SEMISEQUENTIAL) || (configPage2.injLayout == INJ_PAIRED) )
        {
          channel1InjDegrees = 0;
          channel2InjDegrees = 90;
          channel3InjDegrees = 180;
          channel4InjDegrees = 270;

          if (!configPage2.injTiming)
          {
            //For simultaneous, all squirts happen at the same time
            channel1InjDegrees = 0;
            channel2InjDegrees = 0;
            channel3InjDegrees = 0;
            channel4InjDegrees = 0;
          }
          else if (currentStatus.nSquirts > 2)
          {
            //Adjust the injection angles based on the number of squirts
            channel2InjDegrees = (channel2InjDegrees * 2) / currentStatus.nSquirts;
            channel3InjDegrees = (channel3InjDegrees * 2) / currentStatus.nSquirts;
            channel4InjDegrees = (channel4InjDegrees * 2) / currentStatus.nSquirts;
          }
        }

    #if INJ_CHANNELS >= 8
        else if (configPage2.injLayout == INJ_SEQUENTIAL)
        {
          channel1InjDegrees = 0;
          channel2InjDegrees = 90;
          channel3InjDegrees = 180;
          channel4InjDegrees = 270;
          channel5InjDegrees = 360;
          channel6InjDegrees = 450;
          channel7InjDegrees = 540;
          channel8InjDegrees = 630;

          maxInjOutputs = 8;

          CRANK_ANGLE_MAX_INJ = 720;
          currentStatus.nSquirts = 1;
          req_fuel_uS = req_fuel_uS * 2;
        }
    #endif

        break;
    default: //Handle this better!!!
        channel1InjDegrees = 0;
        channel2InjDegrees = 180;
        break;
    }

    currentStatus.status3 |= currentStatus.nSquirts << BIT_STATUS3_NSQUIRTS1; //Top 3 bits of the status3 variable are the number of squirts. This must be done after the above section due to nSquirts being forced to 1 for sequential
    
    //Special case:
    //3 or 5 squirts per cycle MUST be tracked over 720 degrees. This is because the angles for them (Eg 720/3=240) are not evenly divisible into 360
    //This is ONLY the case on 4 stroke systems
    if( (currentStatus.nSquirts == 3) || (currentStatus.nSquirts == 5) )
    {
      if(configPage2.strokes == FOUR_STROKE) { CRANK_ANGLE_MAX_INJ = 720; }
    }
    
    switch(configPage2.injLayout)
    {
    case INJ_PAIRED:
        //Paired injection
        inj1StartFunction = openInjector1;
        inj1EndFunction = closeInjector1;
        inj2StartFunction = openInjector2;
        inj2EndFunction = closeInjector2;
        inj3StartFunction = openInjector3;
        inj3EndFunction = closeInjector3;
        inj4StartFunction = openInjector4;
        inj4EndFunction = closeInjector4;
        inj5StartFunction = openInjector5;
        inj5EndFunction = closeInjector5;
        break;

    case INJ_SEMISEQUENTIAL:
        //Semi-Sequential injection. Currently possible with 4, 6 and 8 cylinders. 5 cylinder is a special case
        if( configPage2.nCylinders == 4 )
        {
          if(configPage4.inj4cylPairing == INJ_PAIR_13_24)
          {
            inj1StartFunction = openInjector1and3;
            inj1EndFunction = closeInjector1and3;
            inj2StartFunction = openInjector2and4;
            inj2EndFunction = closeInjector2and4;
          }
          else
          {
            inj1StartFunction = openInjector1and4;
            inj1EndFunction = closeInjector1and4;
            inj2StartFunction = openInjector2and3;
            inj2EndFunction = closeInjector2and3;
          }
        }
        else if( configPage2.nCylinders == 5 ) //This is similar to the paired injection but uses five injector outputs instead of four
        {
          inj1StartFunction = openInjector1;
          inj1EndFunction = closeInjector1;
          inj2StartFunction = openInjector2;
          inj2EndFunction = closeInjector2;
          inj3StartFunction = openInjector3and5;
          inj3EndFunction = closeInjector3and5;
          inj4StartFunction = openInjector4;
          inj4EndFunction = closeInjector4;
        }
        else if( configPage2.nCylinders == 6 )
        {
          inj1StartFunction = openInjector1and4;
          inj1EndFunction = closeInjector1and4;
          inj2StartFunction = openInjector2and5;
          inj2EndFunction = closeInjector2and5;
          inj3StartFunction = openInjector3and6;
          inj3EndFunction = closeInjector3and6;
        }
        else if( configPage2.nCylinders == 8 )
        {
          inj1StartFunction = openInjector1and5;
          inj1EndFunction = closeInjector1and5;
          inj2StartFunction = openInjector2and6;
          inj2EndFunction = closeInjector2and6;
          inj3StartFunction = openInjector3and7;
          inj3EndFunction = closeInjector3and7;
          inj4StartFunction = openInjector4and8;
          inj4EndFunction = closeInjector4and8;
        }
        else
        {
          //Fall back to paired injection
          inj1StartFunction = openInjector1;
          inj1EndFunction = closeInjector1;
          inj2StartFunction = openInjector2;
          inj2EndFunction = closeInjector2;
          inj3StartFunction = openInjector3;
          inj3EndFunction = closeInjector3;
          inj4StartFunction = openInjector4;
          inj4EndFunction = closeInjector4;
          inj5StartFunction = openInjector5;
          inj5EndFunction = closeInjector5;
        }
        break;

    case INJ_SEQUENTIAL:
        //Sequential injection
        inj1StartFunction = openInjector1;
        inj1EndFunction = closeInjector1;
        inj2StartFunction = openInjector2;
        inj2EndFunction = closeInjector2;
        inj3StartFunction = openInjector3;
        inj3EndFunction = closeInjector3;
        inj4StartFunction = openInjector4;
        inj4EndFunction = closeInjector4;
        inj5StartFunction = openInjector5;
        inj5EndFunction = closeInjector5;
        inj6StartFunction = openInjector6;
        inj6EndFunction = closeInjector6;
        inj7StartFunction = openInjector7;
        inj7EndFunction = closeInjector7;
        inj8StartFunction = openInjector8;
        inj8EndFunction = closeInjector8;
        break;

    default:
        //Paired injection
        inj1StartFunction = openInjector1;
        inj1EndFunction = closeInjector1;
        inj2StartFunction = openInjector2;
        inj2EndFunction = closeInjector2;
        inj3StartFunction = openInjector3;
        inj3EndFunction = closeInjector3;
        inj4StartFunction = openInjector4;
        inj4EndFunction = closeInjector4;
        inj5StartFunction = openInjector5;
        inj5EndFunction = closeInjector5;
        break;
    }

    switch(configPage4.sparkMode)
    {
    case IGN_MODE_WASTED:
        //Wasted Spark (Normal mode)
        ign1StartFunction = beginCoil1Charge;
        ign1EndFunction = endCoil1Charge;
        ign2StartFunction = beginCoil2Charge;
        ign2EndFunction = endCoil2Charge;
        ign3StartFunction = beginCoil3Charge;
        ign3EndFunction = endCoil3Charge;
        ign4StartFunction = beginCoil4Charge;
        ign4EndFunction = endCoil4Charge;
        ign5StartFunction = beginCoil5Charge;
        ign5EndFunction = endCoil5Charge;
        break;

    case IGN_MODE_SINGLE:
        //Single channel mode. All ignition pulses are on channel 1
        ign1StartFunction = beginCoil1Charge;
        ign1EndFunction = endCoil1Charge;
        ign2StartFunction = beginCoil1Charge;
        ign2EndFunction = endCoil1Charge;
        ign3StartFunction = beginCoil1Charge;
        ign3EndFunction = endCoil1Charge;
        ign4StartFunction = beginCoil1Charge;
        ign4EndFunction = endCoil1Charge;
        ign5StartFunction = beginCoil1Charge;
        ign5EndFunction = endCoil1Charge;
        ign6StartFunction = beginCoil1Charge;
        ign6EndFunction = endCoil1Charge;
        ign7StartFunction = beginCoil1Charge;
        ign7EndFunction = endCoil1Charge;
        ign8StartFunction = beginCoil1Charge;
        ign8EndFunction = endCoil1Charge;
        break;

    case IGN_MODE_WASTEDCOP:
        //Wasted COP mode. Note, most of the boards can only run this for 4-cyl only.
        //Wasted COP mode for 4 cylinders. Ignition channels 1&3 and 2&4 are paired together
        if( configPage2.nCylinders <= 4 )
        {
          ign1StartFunction = beginCoil1and3Charge;
          ign1EndFunction = endCoil1and3Charge;
          ign2StartFunction = beginCoil2and4Charge;
          ign2EndFunction = endCoil2and4Charge;

          ign3StartFunction = nullCallback;
          ign3EndFunction = nullCallback;
          ign4StartFunction = nullCallback;
          ign4EndFunction = nullCallback;
        }
        //Wasted COP mode for 6 cylinders. Ignition channels 1&4, 2&5 and 3&6 are paired together
        else if( configPage2.nCylinders == 6 )
          {
          ign1StartFunction = beginCoil1and4Charge;
          ign1EndFunction = endCoil1and4Charge;
          ign2StartFunction = beginCoil2and5Charge;
          ign2EndFunction = endCoil2and5Charge;
          ign3StartFunction = beginCoil3and6Charge;
          ign3EndFunction = endCoil3and6Charge;

          ign4StartFunction = nullCallback;
          ign4EndFunction = nullCallback;
          ign5StartFunction = nullCallback;
          ign5EndFunction = nullCallback;
          ign6StartFunction = nullCallback;
          ign6EndFunction = nullCallback;
        }
        //Wasted COP mode for 8 cylinders. Ignition channels 1&5, 2&6, 3&7 and 4&8 are paired together
        else if( configPage2.nCylinders == 8 )
          {
          ign1StartFunction = beginCoil1and5Charge;
          ign1EndFunction = endCoil1and5Charge;
          ign2StartFunction = beginCoil2and6Charge;
          ign2EndFunction = endCoil2and6Charge;
          ign3StartFunction = beginCoil3and7Charge;
          ign3EndFunction = endCoil3and7Charge;
          ign4StartFunction = beginCoil4and8Charge;
          ign4EndFunction = endCoil4and8Charge;

          ign5StartFunction = nullCallback;
          ign5EndFunction = nullCallback;
          ign6StartFunction = nullCallback;
          ign6EndFunction = nullCallback;
          ign7StartFunction = nullCallback;
          ign7EndFunction = nullCallback;
          ign8StartFunction = nullCallback;
          ign8EndFunction = nullCallback;
        }
        else
        {
          //If the person has inadvertently selected this when running more than 4 cylinders or other than 6 cylinders, just use standard Wasted spark mode
          ign1StartFunction = beginCoil1Charge;
          ign1EndFunction = endCoil1Charge;
          ign2StartFunction = beginCoil2Charge;
          ign2EndFunction = endCoil2Charge;
          ign3StartFunction = beginCoil3Charge;
          ign3EndFunction = endCoil3Charge;
          ign4StartFunction = beginCoil4Charge;
          ign4EndFunction = endCoil4Charge;
          ign5StartFunction = beginCoil5Charge;
          ign5EndFunction = endCoil5Charge;
        }
        break;

    case IGN_MODE_SEQUENTIAL:
        ign1StartFunction = beginCoil1Charge;
        ign1EndFunction = endCoil1Charge;
        ign2StartFunction = beginCoil2Charge;
        ign2EndFunction = endCoil2Charge;
        ign3StartFunction = beginCoil3Charge;
        ign3EndFunction = endCoil3Charge;
        ign4StartFunction = beginCoil4Charge;
        ign4EndFunction = endCoil4Charge;
        ign5StartFunction = beginCoil5Charge;
        ign5EndFunction = endCoil5Charge;
        ign6StartFunction = beginCoil6Charge;
        ign6EndFunction = endCoil6Charge;
        ign7StartFunction = beginCoil7Charge;
        ign7EndFunction = endCoil7Charge;
        ign8StartFunction = beginCoil8Charge;
        ign8EndFunction = endCoil8Charge;
        break;

    case IGN_MODE_ROTARY:
        if(configPage10.rotaryType == ROTARY_IGN_FC)
        {
          //Ignition channel 1 is a wasted spark signal for leading signal on both rotors
          ign1StartFunction = beginCoil1Charge;
          ign1EndFunction = endCoil1Charge;
          ign2StartFunction = beginCoil1Charge;
          ign2EndFunction = endCoil1Charge;

          ign3StartFunction = beginTrailingCoilCharge;
          ign3EndFunction = endTrailingCoilCharge1;
          ign4StartFunction = beginTrailingCoilCharge;
          ign4EndFunction = endTrailingCoilCharge2;
        }
        else if(configPage10.rotaryType == ROTARY_IGN_FD)
        {
          //Ignition channel 1 is a wasted spark signal for leading signal on both rotors
          ign1StartFunction = beginCoil1Charge;
          ign1EndFunction = endCoil1Charge;
          ign2StartFunction = beginCoil1Charge;
          ign2EndFunction = endCoil1Charge;

          //Trailing coils have their own channel each
          //IGN2 = front rotor trailing spark
          ign3StartFunction = beginCoil2Charge;
          ign3EndFunction = endCoil2Charge;
          //IGN3 = rear rotor trailing spark
          ign4StartFunction = beginCoil3Charge;
          ign4EndFunction = endCoil3Charge;

          //IGN4 not used
        }
        else if(configPage10.rotaryType == ROTARY_IGN_RX8)
        {
          //RX8 outputs are simply 1 coil and 1 output per plug

          //IGN1 is front rotor, leading spark
          ign1StartFunction = beginCoil1Charge;
          ign1EndFunction = endCoil1Charge;
          //IGN2 is rear rotor, leading spark
          ign2StartFunction = beginCoil2Charge;
          ign2EndFunction = endCoil2Charge;
          //IGN3 = front rotor trailing spark
          ign3StartFunction = beginCoil3Charge;
          ign3EndFunction = endCoil3Charge;
          //IGN4 = rear rotor trailing spark
          ign4StartFunction = beginCoil4Charge;
          ign4EndFunction = endCoil4Charge;
        }
        else { } //No action for other RX ignition modes (Future expansion / MISRA compliant). 
        break;

    default:
        //Wasted spark (Shouldn't ever happen anyway)
        ign1StartFunction = beginCoil1Charge;
        ign1EndFunction = endCoil1Charge;
        ign2StartFunction = beginCoil2Charge;
        ign2EndFunction = endCoil2Charge;
        ign3StartFunction = beginCoil3Charge;
        ign3EndFunction = endCoil3Charge;
        ign4StartFunction = beginCoil4Charge;
        ign4EndFunction = endCoil4Charge;
        ign5StartFunction = beginCoil5Charge;
        ign5EndFunction = endCoil5Charge;
        break;
    }

    //Begin priming the fuel pump. This is turned off in the low resolution, 1s interrupt in timers.ino
    //First check that the priming time is not 0
    if(configPage2.fpPrime > 0)
    {
      FUEL_PUMP_ON();
      currentStatus.fuelPumpOn = true;
    }
    else { fpPrimed = true; } //If the user has set 0 for the pump priming, immediately mark the priming as being completed

    interrupts();
    readCLT(false); // Need to read coolant temp to make priming pulsewidth work correctly. The false here disables use of the filter
    readTPS(false); // Need to read tps to detect flood clear state

    /* tacho sweep function. */
    tachoSweepEnabled = (configPage2.useTachoSweep > 0);
    /* SweepMax is stored as a byte, RPM/100. divide by 60 to convert min to sec (net 5/3).  Multiply by ignition pulses per rev.
       tachoSweepIncr is also the number of tach pulses per second */
    tachoSweepIncr = configPage2.tachoSweepMaxRPM * maxIgnOutputs * 5 / 3;
    
    initialisationComplete = true;
    digitalWrite(LED_BUILTIN, HIGH);

}
/** Set board / microcontroller specific pin mappings / assignments.
 * The boardID is switch-case compared against raw boardID integers (not enum or defined label, and probably no need for that either)
 * which are originated from tuning SW (e.g. TS) set values and are available in reference/speeduino.ini (See pinLayout, note also that
 * numbering is not contiguous here).
 */
void setPinMapping(byte boardID)
{
  //Force set defaults. Will be overwritten below if needed.
  injectorOutputControl = OUTPUT_CONTROL_DIRECT;
  ignitionOutputControl = OUTPUT_CONTROL_DIRECT;

  switch (boardID)
  {
    //Note: Case 0 (Speeduino v0.1) was removed in Nov 2020 to handle default case for blank FRAM modules

    case 1:
    #ifndef SMALL_FLASH_MODE //No support for bluepill here anyway
      //Pin mappings as per the v0.2 shield
      pinInjector1 = 8; //Output pin injector 1 is on
      pinInjector2 = 9; //Output pin injector 2 is on
      pinInjector3 = 10; //Output pin injector 3 is on
      pinInjector4 = 11; //Output pin injector 4 is on
      pinInjector5 = 12; //Output pin injector 5 is on
      pinCoil1 = 28; //Pin for coil 1
      pinCoil2 = 24; //Pin for coil 2
      pinCoil3 = 40; //Pin for coil 3
      pinCoil4 = 36; //Pin for coil 4
      pinCoil5 = 34; //Pin for coil 5 PLACEHOLDER value for now
      pinTrigger = 20; //The CAS pin
      pinTrigger2 = 21; //The Cam Sensor pin
      pinTrigger3 = 3; //The Cam sensor 2 pin
      pinTPS = A2; //TPS input pin
      pinMAP = A3; //MAP sensor pin
      pinIAT = A0; //IAT sensor pin
      pinCLT = A1; //CLS sensor pin
      pinO2 = A8; //O2 Sensor pin
      pinBat = A4; //Battery reference voltage pin
      pinDisplayReset = 48; // OLED reset pin
      pinTachOut = 49; //Tacho output pin
      pinIdle1 = 30; //Single wire idle control
      pinIdle2 = 31; //2 wire idle control
      pinStepperDir = 16; //Direction pin  for DRV8825 driver
      pinStepperStep = 17; //Step pin for DRV8825 driver
      pinFan = 47; //Pin for the fan output
      pinFuelPump = 4; //Fuel pump output
      pinFlex = 2; // Flex sensor (Must be external interrupt enabled)
      pinResetControl = 43; //Reset control output
      break;
    #endif
    case 2:
    #ifndef SMALL_FLASH_MODE //No support for bluepill here anyway
      //Pin mappings as per the v0.3 shield
      pinInjector1 = 8; //Output pin injector 1 is on
      pinInjector2 = 9; //Output pin injector 2 is on
      pinInjector3 = 10; //Output pin injector 3 is on
      pinInjector4 = 11; //Output pin injector 4 is on
      pinInjector5 = 12; //Output pin injector 5 is on
      pinCoil1 = 28; //Pin for coil 1
      pinCoil2 = 24; //Pin for coil 2
      pinCoil3 = 40; //Pin for coil 3
      pinCoil4 = 36; //Pin for coil 4
      pinCoil5 = 34; //Pin for coil 5 PLACEHOLDER value for now
      pinTrigger = 19; //The CAS pin
      pinTrigger2 = 18; //The Cam Sensor pin
      pinTrigger3 = 3; //The Cam sensor 2 pin
      pinTPS = A2;//TPS input pin
      pinMAP = A3; //MAP sensor pin
      pinIAT = A0; //IAT sensor pin
      pinCLT = A1; //CLS sensor pin
      pinO2 = A8; //O2 Sensor pin
      pinBat = A4; //Battery reference voltage pin
      pinDisplayReset = 48; // OLED reset pin
      pinTachOut = 49; //Tacho output pin
      pinIdle1 = 5; //Single wire idle control
      pinIdle2 = 53; //2 wire idle control
      pinBoost = 7; //Boost control
      pinVVT_1 = 6; //Default VVT output
      pinVVT_2 = 48; //Default VVT2 output
      pinFuelPump = 4; //Fuel pump output
      pinStepperDir = 16; //Direction pin  for DRV8825 driver
      pinStepperStep = 17; //Step pin for DRV8825 driver
      pinStepperEnable = 26; //Enable pin for DRV8825
      pinFan = A13; //Pin for the fan output
      pinLaunch = 51; //Can be overwritten below
      pinFlex = 2; // Flex sensor (Must be external interrupt enabled)
      pinResetControl = 50; //Reset control output
      pinBaro = A5;
      pinVSS = 20;

      #if defined(CORE_TEENSY35)
        pinTrigger = 23;
        pinStepperDir = 33;
        pinStepperStep = 34;
        pinCoil1 = 31;
        pinTachOut = 28;
        pinFan = 27;
        pinCoil4 = 21;
        pinCoil3 = 30;
        pinO2 = A22;
      #endif
    #endif
      break;

    case 3:
      //Pin mappings as per the v0.4 shield
      pinInjector1 = 8; //Output pin injector 1 is on
      pinInjector2 = 9; //Output pin injector 2 is on
      pinInjector3 = 10; //Output pin injector 3 is on
      pinInjector4 = 11; //Output pin injector 4 is on
      pinInjector5 = 12; //Output pin injector 5 is on
      pinInjector6 = 50; //CAUTION: Uses the same as Coil 4 below. 
      pinCoil1 = 40; //Pin for coil 1
      pinCoil2 = 38; //Pin for coil 2
      pinCoil3 = 52; //Pin for coil 3
      pinCoil4 = 50; //Pin for coil 4
      pinCoil5 = 34; //Pin for coil 5 PLACEHOLDER value for now
      pinTrigger = 19; //The CAS pin
      pinTrigger2 = 18; //The Cam Sensor pin
      pinTrigger3 = 3; //The Cam sensor 2 pin
      pinTPS = A2;//TPS input pin
      pinMAP = A3; //MAP sensor pin
      pinIAT = A0; //IAT sensor pin
      pinCLT = A1; //CLS sensor pin
      pinO2 = A8; //O2 Sensor pin
      pinBat = A4; //Battery reference voltage pin
      pinDisplayReset = 48; // OLED reset pin
      pinTachOut = 49; //Tacho output pin  (Goes to ULN2803)
      pinIdle1 = 5; //Single wire idle control
      pinIdle2 = 6; //2 wire idle control
      pinBoost = 7; //Boost control
      pinVVT_1 = 4; //Default VVT output
      pinVVT_2 = 48; //Default VVT2 output
      pinFuelPump = 45; //Fuel pump output  (Goes to ULN2803)
      pinStepperDir = 16; //Direction pin  for DRV8825 driver
      pinStepperStep = 17; //Step pin for DRV8825 driver
      pinStepperEnable = 24; //Enable pin for DRV8825
      pinFan = 47; //Pin for the fan output (Goes to ULN2803)
      pinLaunch = 51; //Can be overwritten below
      pinFlex = 2; // Flex sensor (Must be external interrupt enabled)
      pinResetControl = 43; //Reset control output
      pinBaro = A5;
      pinVSS = 20;
      pinWMIEmpty = 46;
      pinWMIIndicator = 44;
      pinWMIEnabled = 42;

      #if defined(CORE_TEENSY35)
        pinInjector6 = 51;

        pinTrigger = 23;
        pinTrigger2 = 36;
        pinStepperDir = 34;
        pinStepperStep = 35;
        pinCoil1 = 31;
        pinCoil2 = 32;
        pinTachOut = 28;
        pinFan = 27;
        pinCoil4 = 29;
        pinCoil3 = 30;
        pinO2 = A22;
      #elif defined(CORE_TEENSY41)
        //These are only to prevent lockups or weird behaviour on T4.1 when this board is used as the default
        pinBaro = A4; 
        pinMAP = A5;
        pinTPS = A3; //TPS input pin
        pinIAT = A0; //IAT sensor pin
        pinCLT = A1; //CLS sensor pin
        pinO2 = A2; //O2 Sensor pin
        pinBat = A15; //Battery reference voltage pin. Needs Alpha4+
        pinLaunch = 34; //Can be overwritten below
        pinVSS = 35;
        pinSpareTemp2 = A16; //WRONG! Needs updating!!
        pinSpareTemp2 = A17; //WRONG! Needs updating!!

        pinTrigger = 20; //The CAS pin
        pinTrigger2 = 21; //The Cam Sensor pin
        pinTrigger3 = 23;

        pinStepperDir = 34;
        pinStepperStep = 35;
        
        pinCoil1 = 31;
        pinCoil2 = 32;
        pinCoil4 = 29;
        pinCoil3 = 30;

        pinTachOut = 28;
        pinFan = 27;
        pinFuelPump = 33;
        pinWMIEmpty = 34;
        pinWMIIndicator = 35;
        pinWMIEnabled = 36;
      #elif defined(STM32F407xx)
     //Pin definitions for experimental board Tjeerd 
        //Black F407VE wiki.stm32duino.com/index.php?title=STM32F407

        //******************************************
        //******** PORTA CONNECTIONS *************** 
        //******************************************
        /* = PA0 */ //Wakeup ADC123
        // = PA1;
        // = PA2;
        // = PA3;
        // = PA4;
        /* = PA5; */ //ADC12
        /* = PA6; */ //ADC12 LED_BUILTIN_1
        pinFuelPump = PA7; //ADC12 LED_BUILTIN_2
        pinCoil3 = PA8;
        /* = PA9 */ //TXD1
        /* = PA10 */ //RXD1
        /* = PA11 */ //(DO NOT USE FOR SPEEDUINO) USB
        /* = PA12 */ //(DO NOT USE FOR SPEEDUINO) USB 
        /* = PA13 */ //(DO NOT USE FOR SPEEDUINO) NOT ON GPIO - DEBUG ST-LINK
        /* = PA14 */ //(DO NOT USE FOR SPEEDUINO) NOT ON GPIO - DEBUG ST-LINK
        /* = PA15 */ //(DO NOT USE FOR SPEEDUINO) NOT ON GPIO - DEBUG ST-LINK

        //******************************************
        //******** PORTB CONNECTIONS *************** 
        //******************************************
        /* = PB0; */ //(DO NOT USE FOR SPEEDUINO) ADC123 - SPI FLASH CHIP CS pin
        pinBaro = PB1; //ADC12
        /* = PB2; */ //(DO NOT USE FOR SPEEDUINO) BOOT1 
        /* = PB3; */ //(DO NOT USE FOR SPEEDUINO) SPI1_SCK FLASH CHIP
        /* = PB4; */ //(DO NOT USE FOR SPEEDUINO) SPI1_MISO FLASH CHIP
        /* = PB5; */ //(DO NOT USE FOR SPEEDUINO) SPI1_MOSI FLASH CHIP
        /* = PB6; */ //NRF_CE
        /* = PB7; */ //NRF_CS
        /* = PB8; */ //NRF_IRQ
        pinCoil2 = PB9; //
        /* = PB9; */ //
        pinCoil4 = PB10; //TXD3
        pinIdle1 = PB11; //RXD3
        pinIdle2 = PB12; //
        pinBoost = PB12; //
        /* = PB13; */ //SPI2_SCK
        /* = PB14; */ //SPI2_MISO
        /* = PB15; */ //SPI2_MOSI

        //******************************************
        //******** PORTC CONNECTIONS *************** 
        //******************************************
        pinMAP = PC0; //ADC123 
        pinTPS = PC1; //ADC123
        pinIAT = PC2; //ADC123
        pinCLT = PC3; //ADC123
        pinO2 = PC4;  //ADC12
        pinBat = PC5; //ADC12
        pinVVT_1 = PC6; //
        pinDisplayReset = PC7; //
        /* = PC8; */ //(DO NOT USE FOR SPEEDUINO) - SDIO_D0
        /* = PC9; */ //(DO NOT USE FOR SPEEDUINO) - SDIO_D1
        /* = PC10; */ //(DO NOT USE FOR SPEEDUINO) - SDIO_D2
        /* = PC11; */ //(DO NOT USE FOR SPEEDUINO) - SDIO_D3
        /* = PC12; */ //(DO NOT USE FOR SPEEDUINO) - SDIO_SCK
        pinTachOut = PC13; //
        /* = PC14; */ //(DO NOT USE FOR SPEEDUINO) - OSC32_IN
        /* = PC15; */ //(DO NOT USE FOR SPEEDUINO) - OSC32_OUT

        //******************************************
        //******** PORTD CONNECTIONS *************** 
        //******************************************
        /* = PD0; */ //CANRX
        /* = PD1; */ //CANTX
        /* = PD2; */ //(DO NOT USE FOR SPEEDUINO) - SDIO_CMD
        pinVVT_2 = PD3; //
        pinFlex = PD4;
        /* = PD5;*/ //TXD2
        /* = PD6; */ //RXD2
        pinCoil1 = PD7; //
        /* = PD8; */ //
        pinCoil5 = PD9;//
        /* = PD10; */ //
        /* = PD11; */ //
        pinInjector1 = PD12; //
        pinInjector2 = PD13; //
        pinInjector3 = PD14; //
        pinInjector4 = PD15; //

        //******************************************
        //******** PORTE CONNECTIONS *************** 
        //******************************************
        pinTrigger = PE0; //
        pinTrigger2 = PE1; //
        pinStepperEnable = PE2; //
        /* = PE3; */ //ONBOARD KEY1
        /* = PE4; */ //ONBOARD KEY2
        pinStepperStep = PE5; //
        pinFan = PE6; //
        pinStepperDir = PE7; //
        /* = PE8; */ //
        /* = PE9; */ //
        /* = PE10; */ //
        pinInjector5 = PE11; //
        pinInjector6 = PE12; //
        /* = PE13; */ //
        /* = PE14; */ //
        /* = PE15; */ //

      #elif defined(CORE_STM32)
        //https://github.com/stm32duino/Arduino_Core_STM32/blob/master/variants/Generic_F411Cx/variant.h#L28
        //pins PA12, PA11 are used for USB or CAN couldn't be used for GPIO
        //pins PB12, PB13, PB14 and PB15 are used to SPI FLASH
        //PB2 can't be used as input because it's the BOOT pin
        pinInjector1 = PB7; //Output pin injector 1 is on
        pinInjector2 = PB6; //Output pin injector 2 is on
        pinInjector3 = PB5; //Output pin injector 3 is on
        pinInjector4 = PB4; //Output pin injector 4 is on
        pinCoil1 = PB9; //Pin for coil 1
        pinCoil2 = PB8; //Pin for coil 2
        pinCoil3 = PB3; //Pin for coil 3
        pinCoil4 = PA15; //Pin for coil 4
        pinTPS = A2;//TPS input pin
        pinMAP = A3; //MAP sensor pin
        pinIAT = A0; //IAT sensor pin
        pinCLT = A1; //CLS sensor pin
        pinO2 = A8; //O2 Sensor pin
        pinBat = A4; //Battery reference voltage pin
        pinBaro = pinMAP;
        pinTachOut = PB1; //Tacho output pin  (Goes to ULN2803)
        pinIdle1 = PB2; //Single wire idle control
        pinIdle2 = PB10; //2 wire idle control
        pinBoost = PA6; //Boost control
        pinStepperDir = PB10; //Direction pin  for DRV8825 driver
        pinStepperStep = PB2; //Step pin for DRV8825 driver
        pinFuelPump = PA8; //Fuel pump output
        pinFan = PA5; //Pin for the fan output (Goes to ULN2803)
        //external interrupt enabled pins
        pinFlex = PC14; // Flex sensor (Must be external interrupt enabled)
        pinTrigger = PC13; //The CAS pin also led pin so bad idea
        pinTrigger2 = PC15; //The Cam Sensor pin
      #endif
      break;

    case 6:
      #ifndef SMALL_FLASH_MODE
      //Pin mappings as per the 2001-05 MX5 PNP shield
      pinInjector1 = 44; //Output pin injector 1 is on
      pinInjector2 = 46; //Output pin injector 2 is on
      pinInjector3 = 47; //Output pin injector 3 is on
      pinInjector4 = 45; //Output pin injector 4 is on
      pinInjector5 = 14; //Output pin injector 5 is on
      pinCoil1 = 42; //Pin for coil 1
      pinCoil2 = 43; //Pin for coil 2
      pinCoil3 = 32; //Pin for coil 3
      pinCoil4 = 33; //Pin for coil 4
      pinCoil5 = 34; //Pin for coil 5 PLACEHOLDER value for now
      pinTrigger = 19; //The CAS pin
      pinTrigger2 = 18; //The Cam Sensor pin
      pinTrigger3 = 2; //The Cam sensor 2 pin
      pinTPS = A2;//TPS input pin
      pinMAP = A5; //MAP sensor pin
      pinIAT = A0; //IAT sensor pin
      pinCLT = A1; //CLS sensor pin
      pinO2 = A3; //O2 Sensor pin
      pinBat = A4; //Battery reference voltage pin
      pinDisplayReset = 48; // OLED reset pin
      pinTachOut = 23; //Tacho output pin  (Goes to ULN2803)
      pinIdle1 = 5; //Single wire idle control
      pinBoost = 4;
      pinVVT_1 = 11; //Default VVT output
      pinVVT_2 = 48; //Default VVT2 output
      pinIdle2 = 4; //2 wire idle control (Note this is shared with boost!!!)
      pinFuelPump = 40; //Fuel pump output
      pinStepperDir = 16; //Direction pin  for DRV8825 driver
      pinStepperStep = 17; //Step pin for DRV8825 driver
      pinStepperEnable = 24;
      pinFan = 41; //Pin for the fan output
      pinLaunch = 12; //Can be overwritten below
      pinFlex = 3; // Flex sensor (Must be external interrupt enabled)
      pinResetControl = 39; //Reset control output
      #endif
      //This is NOT correct. It has not yet been tested with this board
      #if defined(CORE_TEENSY35)
        pinTrigger = 23;
        pinTrigger2 = 36;
        pinStepperDir = 34;
        pinStepperStep = 35;
        pinCoil1 = 33; //Done
        pinCoil2 = 24; //Done
        pinCoil3 = 51; //Won't work (No mapping for pin 32)
        pinCoil4 = 52; //Won't work (No mapping for pin 33)
        pinFuelPump = 26; //Requires PVT4 adapter or above
        pinFan = 50; //Won't work (No mapping for pin 35)
        pinTachOut = 28; //Done
      #endif
      break;

    case 8:
      #ifndef SMALL_FLASH_MODE
      //Pin mappings as per the 1996-97 MX5 PNP shield
      pinInjector1 = 11; //Output pin injector 1 is on
      pinInjector2 = 10; //Output pin injector 2 is on
      pinInjector3 = 9; //Output pin injector 3 is on
      pinInjector4 = 8; //Output pin injector 4 is on
      pinInjector5 = 14; //Output pin injector 5 is on
      pinCoil1 = 39; //Pin for coil 1
      pinCoil2 = 41; //Pin for coil 2
      pinCoil3 = 32; //Pin for coil 3
      pinCoil4 = 33; //Pin for coil 4
      pinCoil5 = 34; //Pin for coil 5 PLACEHOLDER value for now
      pinTrigger = 19; //The CAS pin
      pinTrigger2 = 18; //The Cam Sensor pin
      pinTPS = A2;//TPS input pin
      pinMAP = A5; //MAP sensor pin
      pinIAT = A0; //IAT sensor pin
      pinCLT = A1; //CLS sensor pin
      pinO2 = A3; //O2 Sensor pin
      pinBat = A4; //Battery reference voltage pin
      pinDisplayReset = 48; // OLED reset pin
      pinTachOut = A9; //Tacho output pin  (Goes to ULN2803)
      pinIdle1 = 2; //Single wire idle control
      pinBoost = 4;
      pinIdle2 = 4; //2 wire idle control (Note this is shared with boost!!!)
      pinFuelPump = 49; //Fuel pump output
      pinStepperDir = 16; //Direction pin  for DRV8825 driver
      pinStepperStep = 17; //Step pin for DRV8825 driver
      pinStepperEnable = 24;
      pinFan = 35; //Pin for the fan output
      pinLaunch = 37; //Can be overwritten below
      pinFlex = 3; // Flex sensor (Must be external interrupt enabled)
      pinResetControl = 44; //Reset control output

      //This is NOT correct. It has not yet been tested with this board
      #if defined(CORE_TEENSY35)
        pinTrigger = 23;
        pinTrigger2 = 36;
        pinStepperDir = 34;
        pinStepperStep = 35;
        pinCoil1 = 33; //Done
        pinCoil2 = 24; //Done
        pinCoil3 = 51; //Won't work (No mapping for pin 32)
        pinCoil4 = 52; //Won't work (No mapping for pin 33)
        pinFuelPump = 26; //Requires PVT4 adapter or above
        pinFan = 50; //Won't work (No mapping for pin 35)
        pinTachOut = 28; //Done
      #endif
      #endif
      break;

    case 9:
     #ifndef SMALL_FLASH_MODE
      //Pin mappings as per the 89-95 MX5 PNP shield
      pinInjector1 = 11; //Output pin injector 1 is on
      pinInjector2 = 10; //Output pin injector 2 is on
      pinInjector3 = 9; //Output pin injector 3 is on
      pinInjector4 = 8; //Output pin injector 4 is on
      pinInjector5 = 14; //Output pin injector 5 is on
      pinCoil1 = 39; //Pin for coil 1
      pinCoil2 = 41; //Pin for coil 2
      pinCoil3 = 32; //Pin for coil 3
      pinCoil4 = 33; //Pin for coil 4
      pinCoil5 = 34; //Pin for coil 5 PLACEHOLDER value for now
      pinTrigger = 19; //The CAS pin
      pinTrigger2 = 18; //The Cam Sensor pin
      pinTPS = A2;//TPS input pin
      pinMAP = A5; //MAP sensor pin
      pinIAT = A0; //IAT sensor pin
      pinCLT = A1; //CLS sensor pin
      pinO2 = A3; //O2 Sensor pin
      pinBat = A4; //Battery reference voltage pin
      pinDisplayReset = 48; // OLED reset pin
      pinTachOut = 49; //Tacho output pin  (Goes to ULN2803)
      pinIdle1 = 2; //Single wire idle control
      pinBoost = 4;
      pinIdle2 = 4; //2 wire idle control (Note this is shared with boost!!!)
      pinFuelPump = 37; //Fuel pump output
      //Note that there is no stepper driver output on the PNP boards. These pins are unconnected and remain here just to prevent issues with random pin numbers occurring
      pinStepperEnable = 15; //Enable pin for the DRV8825
      pinStepperDir = 16; //Direction pin  for DRV8825 driver
      pinStepperStep = 17; //Step pin for DRV8825 driver
      pinFan = 35; //Pin for the fan output
      pinLaunch = 12; //Can be overwritten below
      pinFlex = 3; // Flex sensor (Must be external interrupt enabled)
      pinResetControl = 44; //Reset control output
      pinVSS = 20;
      pinIdleUp = 48;
      pinCTPS = 47;
      #endif
      #if defined(CORE_TEENSY35)
        pinTrigger = 23;
        pinTrigger2 = 36;
        pinStepperDir = 34;
        pinStepperStep = 35;
        pinCoil1 = 33; //Done
        pinCoil2 = 24; //Done
        pinCoil3 = 51; //Won't work (No mapping for pin 32)
        pinCoil4 = 52; //Won't work (No mapping for pin 33)
        pinFuelPump = 26; //Requires PVT4 adapter or above
        pinFan = 50; //Won't work (No mapping for pin 35)
        pinTachOut = 28; //Done
      #endif
      break;

    case 10:
    #ifndef SMALL_FLASH_MODE //No support for bluepill here anyway
      //Pin mappings for user turtanas PCB
      pinInjector1 = 4; //Output pin injector 1 is on
      pinInjector2 = 5; //Output pin injector 2 is on
      pinInjector3 = 6; //Output pin injector 3 is on
      pinInjector4 = 7; //Output pin injector 4 is on
      pinInjector5 = 8; //Placeholder only - NOT USED
      pinInjector6 = 9; //Placeholder only - NOT USED
      pinInjector7 = 10; //Placeholder only - NOT USED
      pinInjector8 = 11; //Placeholder only - NOT USED
      pinCoil1 = 24; //Pin for coil 1
      pinCoil2 = 28; //Pin for coil 2
      pinCoil3 = 36; //Pin for coil 3
      pinCoil4 = 40; //Pin for coil 4
      pinCoil5 = 34; //Pin for coil 5 PLACEHOLDER value for now
      pinTrigger = 18; //The CAS pin
      pinTrigger2 = 19; //The Cam Sensor pin
      pinTPS = A2;//TPS input pin
      pinMAP = A3; //MAP sensor pin
      pinMAP2 = A8; //MAP2 sensor pin
      pinIAT = A0; //IAT sensor pin
      pinCLT = A1; //CLS sensor pin
      pinO2 = A4; //O2 Sensor pin
      pinBat = A7; //Battery reference voltage pin
      pinDisplayReset = 48; // OLED reset pin
      pinSpareTemp1 = A6;
      pinSpareTemp2 = A5;
      pinTachOut = 41; //Tacho output pin transistor is missing 2n2222 for this and 1k for 12v
      pinFuelPump = 42; //Fuel pump output 2n2222
      pinFan = 47; //Pin for the fan output
      pinTachOut = 49; //Tacho output pin
      pinFlex = 2; // Flex sensor (Must be external interrupt enabled)
      pinResetControl = 26; //Reset control output

    #endif
      break;

    case 20:
    #if defined(CORE_AVR) && !defined(SMALL_FLASH_MODE) //No support for bluepill here anyway
      //Pin mappings as per the Plazomat In/Out shields Rev 0.1
      pinInjector1 = 8; //Output pin injector 1 is on
      pinInjector2 = 9; //Output pin injector 2 is on
      pinInjector3 = 10; //Output pin injector 3 is on
      pinInjector4 = 11; //Output pin injector 4 is on
      pinInjector5 = 12; //Output pin injector 5 is on
      pinCoil1 = 28; //Pin for coil 1
      pinCoil2 = 24; //Pin for coil 2
      pinCoil3 = 40; //Pin for coil 3
      pinCoil4 = 36; //Pin for coil 4
      pinCoil5 = 34; //Pin for coil 5 PLACEHOLDER value for now
      pinSpareOut1 = 4; //Spare LSD Output 1(PWM)
      pinSpareOut2 = 5; //Spare LSD Output 2(PWM)
      pinSpareOut3 = 6; //Spare LSD Output 3(PWM)
      pinSpareOut4 = 7; //Spare LSD Output 4(PWM)
      pinSpareOut5 = 50; //Spare LSD Output 5(digital)
      pinSpareOut6 = 52; //Spare LSD Output 6(digital)
      pinTrigger = 20; //The CAS pin
      pinTrigger2 = 21; //The Cam Sensor pin
      pinSpareTemp2 = A15; //spare Analog input 2
      pinSpareTemp1 = A14; //spare Analog input 1
      pinO2 = A8; //O2 Sensor pin
      pinBat = A4; //Battery reference voltage pin
      pinMAP = A3; //MAP sensor pin
      pinTPS = A2;//TPS input pin
      pinCLT = A1; //CLS sensor pin
      pinIAT = A0; //IAT sensor pin
      pinFan = 47; //Pin for the fan output
      pinFuelPump = 4; //Fuel pump output
      pinTachOut = 49; //Tacho output pin
      pinResetControl = 26; //Reset control output
    #endif
      break;

    case 30:
    #ifndef SMALL_FLASH_MODE //No support for bluepill here anyway
      //Pin mappings as per the dazv6 shield
      pinInjector1 = 8; //Output pin injector 1 is on
      pinInjector2 = 9; //Output pin injector 2 is on
      pinInjector3 = 10; //Output pin injector 3 is on
      pinInjector4 = 11; //Output pin injector 4 is on
      pinInjector5 = 12; //Output pin injector 5 is on
      pinCoil1 = 40; //Pin for coil 1
      pinCoil2 = 38; //Pin for coil 2
      pinCoil3 = 50; //Pin for coil 3
      pinCoil4 = 52; //Pin for coil 4
      pinCoil5 = 34; //Pin for coil 5 PLACEHOLDER value for now
      pinTrigger = 19; //The CAS pin
      pinTrigger2 = 18; //The Cam Sensor pin
      pinTrigger3 = 17; // cam sensor 2 pin, pin17 isn't external trigger enabled in arduino mega??
      pinTPS = A2;//TPS input pin
      pinMAP = A3; //MAP sensor pin
      pinIAT = A0; //IAT sensor pin
      pinCLT = A1; //CLS sensor pin
      pinO2 = A8; //O2 Sensor pin
      pinO2_2 = A9; //O2 sensor pin (second sensor)
      pinBat = A4; //Battery reference voltage pin
      pinDisplayReset = 48; // OLED reset pin
      pinTachOut = 49; //Tacho output pin
      pinIdle1 = 5; //Single wire idle control
      pinFuelPump = 45; //Fuel pump output
      pinStepperDir = 20; //Direction pin  for DRV8825 driver
      pinStepperStep = 21; //Step pin for DRV8825 driver
      pinSpareHOut1 = 4; // high current output spare1
      pinSpareHOut2 = 6; // high current output spare2
      pinBoost = 7;
      pinSpareLOut1 = 43; //low current output spare1
      pinSpareLOut2 = 47;
      pinSpareLOut3 = 49;
      pinSpareLOut4 = 51;
      pinSpareLOut5 = 53;
      pinFan = 47; //Pin for the fan output
    #endif
      break;

   case 31:
      //Pin mappings for the BMW PnP PCBs by pazi88.
      #if defined(CORE_AVR)
      //This is the regular MEGA2560 pin mapping
      pinInjector1 = 8; //Output pin injector 1
      pinInjector2 = 9; //Output pin injector 2
      pinInjector3 = 10; //Output pin injector 3
      pinInjector4 = 11; //Output pin injector 4
      pinInjector5 = 12; //Output pin injector 5
      pinInjector6 = 50; //Output pin injector 6
      pinInjector7 = 39; //Output pin injector 7 (placeholder)
      pinInjector8 = 42; //Output pin injector 8 (placeholder)
      pinCoil1 = 40; //Pin for coil 1
      pinCoil2 = 38; //Pin for coil 2
      pinCoil3 = 52; //Pin for coil 3
      pinCoil4 = 48; //Pin for coil 4
      pinCoil5 = 36; //Pin for coil 5
      pinCoil6 = 34; //Pin for coil 6
      pinCoil7 = 46; //Pin for coil 7 (placeholder)
      pinCoil8 = 53; //Pin for coil 8 (placeholder)
      pinTrigger = 19; //The CAS pin
      pinTrigger2 = 18; //The Cam Sensor pin
      pinTrigger3 = 20; //The Cam sensor 2 pin
      pinTPS = A2;//TPS input pin
      pinMAP = A3; //MAP sensor pin
      pinEMAP = A15; //EMAP sensor pin
      pinIAT = A0; //IAT sensor pin
      pinCLT = A1; //CLT sensor pin
      pinO2 = A8; //O2 Sensor pin
      pinBat = A4; //Battery reference voltage pin
      pinBaro = A5; //Baro sensor pin
      pinDisplayReset = 41; // OLED reset pin
      pinTachOut = 49; //Tacho output pin  (Goes to ULN2003)
      pinIdle1 = 5; //ICV pin1
      pinIdle2 = 6; //ICV pin3
      pinBoost = 7; //Boost control
      pinVVT_1 = 4; //VVT1 output (intake vanos)
      pinVVT_2 = 26; //VVT2 output (exhaust vanos)
      pinFuelPump = 45; //Fuel pump output  (Goes to ULN2003)
      pinStepperDir = 16; //Stepper valve isn't used with these
      pinStepperStep = 17; //Stepper valve isn't used with these
      pinStepperEnable = 24; //Stepper valve isn't used with these
      pinFan = 47; //Pin for the fan output (Goes to ULN2003)
      pinLaunch = 51; //Launch control pin
      pinFlex = 2; // Flex sensor
      pinResetControl = 43; //Reset control output
      pinVSS = 3; //VSS input pin
      pinWMIEmpty = 31; //(placeholder)
      pinWMIIndicator = 33; //(placeholder)
      pinWMIEnabled = 35; //(placeholder)
      pinIdleUp = 37; //(placeholder)
      pinCTPS = A6; //(placeholder)
     #elif defined(STM32F407xx)
      pinInjector1 = PB15; //Output pin injector 1
      pinInjector2 = PB14; //Output pin injector 2
      pinInjector3 = PB12; //Output pin injector 3
      pinInjector4 = PB13; //Output pin injector 4
      pinInjector5 = PA8; //Output pin injector 5
      pinInjector6 = PE7; //Output pin injector 6
      pinInjector7 = PE13; //Output pin injector 7 (placeholder)
      pinInjector8 = PE10; //Output pin injector 8 (placeholder)
      pinCoil1 = PE2; //Pin for coil 1
      pinCoil2 = PE3; //Pin for coil 2
      pinCoil3 = PC13; //Pin for coil 3
      pinCoil4 = PE6; //Pin for coil 4
      pinCoil5 = PE4; //Pin for coil 5
      pinCoil6 = PE5; //Pin for coil 6
      pinCoil7 = PE0; //Pin for coil 7 (placeholder)
      pinCoil8 = PB9; //Pin for coil 8 (placeholder)
      pinTrigger = PD3; //The CAS pin
      pinTrigger2 = PD4; //The Cam Sensor pin
      pinTPS = PA2;//TPS input pin
      pinMAP = PA3; //MAP sensor pin
      pinEMAP = PC5; //EMAP sensor pin
      pinIAT = PA0; //IAT sensor pin
      pinCLT = PA1; //CLS sensor pin
      pinO2 = PB0; //O2 Sensor pin
      pinBat = PA4; //Battery reference voltage pin
      pinBaro = PA5; //Baro sensor pin
      pinDisplayReset = PE12; // OLED reset pin
      pinTachOut = PE8; //Tacho output pin  (Goes to ULN2003)
      pinIdle1 = PD10; //ICV pin1
      pinIdle2 = PD9; //ICV pin3
      pinBoost = PD8; //Boost control
      pinVVT_1 = PD11; //VVT1 output (intake vanos)
      pinVVT_2 = PC7; //VVT2 output (exhaust vanos)
      pinFuelPump = PE11; //Fuel pump output  (Goes to ULN2003)
      pinStepperDir = PB10; //Stepper valve isn't used with these
      pinStepperStep = PB11; //Stepper valve isn't used with these
      pinStepperEnable = PA15; //Stepper valve isn't used with these
      pinFan = PE9; //Pin for the fan output (Goes to ULN2003)
      pinLaunch = PB8; //Launch control pin
      pinFlex = PD7; // Flex sensor
      pinResetControl = PB7; //Reset control output
      pinVSS = PB6; //VSS input pin
      pinWMIEmpty = PD15; //(placeholder)
      pinWMIIndicator = PD13; //(placeholder)
      pinWMIEnabled = PE15; //(placeholder)
      pinIdleUp = PE14; //(placeholder)
      pinCTPS = PA6; //(placeholder)
     #endif
      break;

    case 40:
     #ifndef SMALL_FLASH_MODE
      //Pin mappings as per the NO2C shield
      pinInjector1 = 8; //Output pin injector 1 is on
      pinInjector2 = 9; //Output pin injector 2 is on
      pinInjector3 = 11; //Output pin injector 3 is on - NOT USED
      pinInjector4 = 12; //Output pin injector 4 is on - NOT USED
      pinInjector5 = 13; //Placeholder only - NOT USED
      pinCoil1 = 23; //Pin for coil 1
      pinCoil2 = 22; //Pin for coil 2
      pinCoil3 = 2; //Pin for coil 3 - ONLY WITH DB2
      pinCoil4 = 3; //Pin for coil 4 - ONLY WITH DB2
      pinCoil5 = 46; //Placeholder only - NOT USED
      pinTrigger = 19; //The CAS pin
      pinTrigger2 = 18; //The Cam Sensor pin
      pinTrigger3 = 21; //The Cam sensor 2 pin
      pinTPS = A3; //TPS input pin
      pinMAP = A0; //MAP sensor pin
      pinIAT = A5; //IAT sensor pin
      pinCLT = A4; //CLT sensor pin
      pinO2 = A2; //O2 sensor pin
      pinBat = A1; //Battery reference voltage pin
      pinBaro = A6; //Baro sensor pin - ONLY WITH DB
      pinSpareTemp1 = A7; //spare Analog input 1 - ONLY WITH DB
      pinDisplayReset = 48; // OLED reset pin - NOT USED
      pinTachOut = 38; //Tacho output pin
      pinIdle1 = 5; //Single wire idle control
      pinIdle2 = 47; //2 wire idle control - NOT USED
      pinBoost = 7; //Boost control
      pinVVT_1 = 6; //Default VVT output
      pinVVT_2 = 48; //Default VVT2 output
      pinFuelPump = 4; //Fuel pump output
      pinStepperDir = 25; //Direction pin for DRV8825 driver
      pinStepperStep = 24; //Step pin for DRV8825 driver
      pinStepperEnable = 27; //Enable pin for DRV8825 driver
      pinLaunch = 10; //Can be overwritten below
      pinFlex = 20; // Flex sensor (Must be external interrupt enabled) - ONLY WITH DB
      pinFan = 30; //Pin for the fan output - ONLY WITH DB
      pinSpareLOut1 = 32; //low current output spare1 - ONLY WITH DB
      pinSpareLOut2 = 34; //low current output spare2 - ONLY WITH DB
      pinSpareLOut3 = 36; //low current output spare3 - ONLY WITH DB
      pinResetControl = 26; //Reset control output
      #endif
      break;

    case 41:
    #ifndef SMALL_FLASH_MODE //No support for bluepill here anyway
      //Pin mappings as per the UA4C shield
      pinInjector1 = 8; //Output pin injector 1 is on
      pinInjector2 = 7; //Output pin injector 2 is on
      pinInjector3 = 6; //Output pin injector 3 is on
      pinInjector4 = 5; //Output pin injector 4 is on
      pinInjector5 = 45; //Output pin injector 5 is on PLACEHOLDER value for now
      pinCoil1 = 35; //Pin for coil 1
      pinCoil2 = 36; //Pin for coil 2
      pinCoil3 = 33; //Pin for coil 3
      pinCoil4 = 34; //Pin for coil 4
      pinCoil5 = 44; //Pin for coil 5 PLACEHOLDER value for now
      pinTrigger = 19; //The CAS pin
      pinTrigger2 = 18; //The Cam Sensor pin
      pinTrigger3 = 3; //The Cam sensor 2 pin
      pinFlex = 20; // Flex sensor
      pinTPS = A3; //TPS input pin
      pinMAP = A0; //MAP sensor pin
      pinBaro = A7; //Baro sensor pin
      pinIAT = A5; //IAT sensor pin
      pinCLT = A4; //CLS sensor pin
      pinO2 = A1; //O2 Sensor pin
      pinO2_2 = A9; //O2 sensor pin (second sensor)
      pinBat = A2; //Battery reference voltage pin
      pinSpareTemp1 = A8; //spare Analog input 1
      pinLaunch = 37; //Can be overwritten below
      pinDisplayReset = 48; // OLED reset pin PLACEHOLDER value for now
      pinTachOut = 22; //Tacho output pin
      pinIdle1 = 9; //Single wire idle control
      pinIdle2 = 10; //2 wire idle control
      pinFuelPump = 23; //Fuel pump output
      pinVVT_1 = 11; //Default VVT output
      pinVVT_2 = 48; //Default VVT2 output
      pinStepperDir = 32; //Direction pin  for DRV8825 driver
      pinStepperStep = 31; //Step pin for DRV8825 driver
      pinStepperEnable = 30; //Enable pin for DRV8825 driver
      pinBoost = 12; //Boost control
      pinSpareLOut1 = 26; //low current output spare1
      pinSpareLOut2 = 27; //low current output spare2
      pinSpareLOut3 = 28; //low current output spare3
      pinSpareLOut4 = 29; //low current output spare4
      pinFan = 24; //Pin for the fan output
      pinResetControl = 46; //Reset control output PLACEHOLDER value for now
    #endif
      break;
	  	  
    case 42:
      //Pin mappings for all BlitzboxBL49sp variants
      pinInjector1 = 6; //Output pin injector 1
      pinInjector2 = 7; //Output pin injector 2
      pinInjector3 = 8; //Output pin injector 3
      pinInjector4 = 9; //Output pin injector 4
      pinCoil1 = 24; //Pin for coil 1
      pinCoil2 = 25; //Pin for coil 2
      pinCoil3 = 23; //Pin for coil 3
      pinCoil4 = 22; //Pin for coil 4
      pinTrigger = 19; //The CRANK Sensor pin
      pinTrigger2 = 18; //The Cam Sensor pin
      pinFlex = 20; // Flex sensor PLACEHOLDER value for now
      pinTPS = A0; //TPS input pin
      pinSpareTemp1 = A1; //LMM sensor pin
      pinO2 = A2; //O2 Sensor pin
      pinIAT = A3; //IAT sensor pin
      pinCLT = A4; //CLT sensor pin
      pinMAP = A7; //internal MAP sensor
      pinBat = A6; //Battery reference voltage pin
      pinBaro = A5; //external MAP/Baro sensor pin
      pinO2_2 = A9; //O2 sensor pin (second sensor) PLACEHOLDER value for now
      pinLaunch = 2; //Can be overwritten below
      pinTachOut = 10; //Tacho output pin
      pinIdle1 = 11; //Single wire idle control
      pinIdle2 = 14; //2 wire idle control PLACEHOLDER value for now
      pinFuelPump = 3; //Fuel pump output
      pinVVT_1 = 15; //Default VVT output PLACEHOLDER value for now
      pinBoost = 13; //Boost control
      pinSpareLOut1 = 49; //enable Wideband Lambda Heater
      pinSpareLOut2 = 16; //low current output spare2 PLACEHOLDER value for now
      pinSpareLOut3 = 17; //low current output spare3 PLACEHOLDER value for now
      pinSpareLOut4 = 21; //low current output spare4 PLACEHOLDER value for now
      pinFan = 12; //Pin for the fan output
      pinResetControl = 46; //Reset control output PLACEHOLDER value for now
      break;
  
    case 45:
    #ifndef SMALL_FLASH_MODE //No support for bluepill here anyway
      //Pin mappings for the DIY-EFI CORE4 Module. This is an AVR only module
      #if defined(CORE_AVR)
      pinInjector1 = 10; //Output pin injector 1 is on
      pinInjector2 = 11; //Output pin injector 2 is on
      pinInjector3 = 12; //Output pin injector 3 is on
      pinInjector4 = 9; //Output pin injector 4 is on
      pinCoil1 = 39; //Pin for coil 1
      pinCoil2 = 29; //Pin for coil 2
      pinCoil3 = 28; //Pin for coil 3
      pinCoil4 = 27; //Pin for coil 4
      pinCoil5 = 26; //Placeholder  for coil 5
      pinTrigger = 19; //The CAS pin
      pinTrigger2 = 18; //The Cam Sensor pin
      pinTrigger3 = 21;// The Cam sensor 2 pin
      pinFlex = 20; // Flex sensor
      pinTPS = A3; //TPS input pin
      pinMAP = A2; //MAP sensor pin
      pinBaro = A15; //Baro sensor pin
      pinIAT = A11; //IAT sensor pin
      pinCLT = A4; //CLS sensor pin
      pinO2 = A12; //O2 Sensor pin
      pinO2_2 = A5; //O2 sensor pin (second sensor)
      pinBat = A1; //Battery reference voltage pin
      pinSpareTemp1 = A14; //spare Analog input 1
      pinLaunch = 24; //Can be overwritten below
      pinDisplayReset = 48; // OLED reset pin PLACEHOLDER value for now
      pinTachOut = 38; //Tacho output pin
      pinIdle1 = 42; //Single wire idle control
      pinIdle2 = 43; //2 wire idle control
      pinFuelPump = 41; //Fuel pump output
      pinVVT_1 = 44; //Default VVT output
      pinVVT_2 = 48; //Default VVT2 output
      pinStepperDir = 32; //Direction pin  for DRV8825 driver
      pinStepperStep = 31; //Step pin for DRV8825 driver
      pinStepperEnable = 30; //Enable pin for DRV8825 driver
      pinBoost = 45; //Boost control
      pinSpareLOut1 = 37; //low current output spare1
      pinSpareLOut2 = 36; //low current output spare2
      pinSpareLOut3 = 35; //low current output spare3
      pinInjector5 = 33; //Output pin injector 5 is on
      pinInjector6 = 34; //Output pin injector 6 is on
      pinFan = 40; //Pin for the fan output
      pinResetControl = 46; //Reset control output PLACEHOLDER value for now
      #endif
    #endif
      break;

    #if defined(CORE_TEENSY35)
    case 50:
      //Pin mappings as per the teensy rev A shield
      pinInjector1 = 2; //Output pin injector 1 is on
      pinInjector2 = 10; //Output pin injector 2 is on
      pinInjector3 = 6; //Output pin injector 3 is on
      pinInjector4 = 9; //Output pin injector 4 is on
      //Placeholder only - NOT USED:
      //pinInjector5 = 13;
      pinCoil1 = 29; //Pin for coil 1
      pinCoil2 = 30; //Pin for coil 2
      pinCoil3 = 31; //Pin for coil 3 - ONLY WITH DB2
      pinCoil4 = 32; //Pin for coil 4 - ONLY WITH DB2
      //Placeholder only - NOT USED:
      //pinCoil5 = 46; 
      pinTrigger = 23; //The CAS pin
      pinTrigger2 = 36; //The Cam Sensor pin
      pinTPS = 16; //TPS input pin
      pinMAP = 17; //MAP sensor pin
      pinIAT = 14; //IAT sensor pin
      pinCLT = 15; //CLT sensor pin
      pinO2 = A22; //O2 sensor pin
      pinO2_2 = A21; //O2 sensor pin (second sensor)
      pinBat = 18; //Battery reference voltage pin
      pinTachOut = 20; //Tacho output pin
      pinIdle1 = 5; //Single wire idle control
      pinBoost = 11; //Boost control
      pinFuelPump = 38; //Fuel pump output
      pinStepperDir = 34; //Direction pin for DRV8825 driver
      pinStepperStep = 35; //Step pin for DRV8825 driver
      pinStepperEnable = 33; //Enable pin for DRV8825 driver
      pinLaunch = 26; //Can be overwritten below
      pinFan = 37; //Pin for the fan output - ONLY WITH DB
      pinSpareHOut1 = 8; // high current output spare1
      pinSpareHOut2 = 7; // high current output spare2
      pinSpareLOut1 = 21; //low current output spare1
      break;

    case 51:
      //Pin mappings as per the teensy revB board shield
      pinInjector1 = 2; //Output pin injector 1 is on
      pinInjector2 = 10; //Output pin injector 2 is on
      pinInjector3 = 6; //Output pin injector 3 is on - NOT USED
      pinInjector4 = 9; //Output pin injector 4 is on - NOT USED
      pinCoil1 = 29; //Pin for coil 1
      pinCoil2 = 30; //Pin for coil 2
      pinCoil3 = 31; //Pin for coil 3 - ONLY WITH DB2
      pinCoil4 = 32; //Pin for coil 4 - ONLY WITH DB2
      pinTrigger = 23; //The CAS pin
      pinTrigger2 = 36; //The Cam Sensor pin
      pinTPS = 16; //TPS input pin
      pinMAP = 17; //MAP sensor pin
      pinIAT = 14; //IAT sensor pin
      pinCLT = 15; //CLT sensor pin
      pinO2 = A22; //O2 sensor pin
      pinO2_2 = A21; //O2 sensor pin (second sensor)
      pinBat = 18; //Battery reference voltage pin
      pinTachOut = 20; //Tacho output pin
      pinIdle1 = 5; //Single wire idle control
      pinBoost = 11; //Boost control
      pinFuelPump = 38; //Fuel pump output
      pinStepperDir = 34; //Direction pin for DRV8825 driver
      pinStepperStep = 35; //Step pin for DRV8825 driver
      pinStepperEnable = 33; //Enable pin for DRV8825 driver
      pinLaunch = 26; //Can be overwritten below
      pinFan = 37; //Pin for the fan output - ONLY WITH DB
      pinSpareHOut1 = 8; // high current output spare1
      pinSpareHOut2 = 7; // high current output spare2
      pinSpareLOut1 = 21; //low current output spare1
      break;
    #endif

    #if defined(CORE_TEENSY35)
    case 53:
      //Pin mappings for the Juice Box (ignition only board)
      pinInjector1 = 2; //Output pin injector 1 is on - NOT USED
      pinInjector2 = 56; //Output pin injector 2 is on - NOT USED
      pinInjector3 = 6; //Output pin injector 3 is on - NOT USED
      pinInjector4 = 50; //Output pin injector 4 is on - NOT USED
      pinCoil1 = 29; //Pin for coil 1
      pinCoil2 = 30; //Pin for coil 2
      pinCoil3 = 31; //Pin for coil 3
      pinCoil4 = 32; //Pin for coil 4
      pinTrigger = 37; //The CAS pin
      pinTrigger2 = 38; //The Cam Sensor pin - NOT USED
      pinTPS = A2; //TPS input pin
      pinMAP = A7; //MAP sensor pin
      pinIAT = A1; //IAT sensor pin
      pinCLT = A5; //CLT sensor pin
      pinO2 = A0; //O2 sensor pin
      pinO2_2 = A21; //O2 sensor pin (second sensor) - NOT USED
      pinBat = A6; //Battery reference voltage pin
      pinTachOut = 28; //Tacho output pin
      pinIdle1 = 5; //Single wire idle control - NOT USED
      pinBoost = 11; //Boost control - NOT USED
      pinFuelPump = 24; //Fuel pump output
      pinStepperDir = 3; //Direction pin for DRV8825 driver - NOT USED
      pinStepperStep = 4; //Step pin for DRV8825 driver - NOT USED
      pinStepperEnable = 6; //Enable pin for DRV8825 driver - NOT USED
      pinLaunch = 26; //Can be overwritten below
      pinFan = 25; //Pin for the fan output
      pinSpareHOut1 = 26; // high current output spare1
      pinSpareHOut2 = 27; // high current output spare2
      pinSpareLOut1 = 55; //low current output spare1 - NOT USED
      break;
    #endif

    case 55:
      #if defined(CORE_TEENSY)
      //Pin mappings for the DropBear
      injectorOutputControl = OUTPUT_CONTROL_MC33810;
      ignitionOutputControl = OUTPUT_CONTROL_MC33810;

      //The injector pins below are not used directly as the control is via SPI through the MC33810s, however the pin numbers are set to be the SPI pins (SCLK, MOSI, MISO and CS) so that nothing else will set them as inputs
      pinInjector1 = 13; //SCLK
      pinInjector2 = 11; //MOSI
      pinInjector3 = 12; //MISO
      pinInjector4 = 10; //CS for MC33810 1
      pinInjector5 = 9; //CS for MC33810 2

      pinTrigger = 19; //The CAS pin
      pinTrigger2 = 18; //The Cam Sensor pin
      pinFlex = A16; // Flex sensor
      pinMAP = A1; //MAP sensor pin
      pinBaro = A0; //Baro sensor pin
      pinBat = A14; //Battery reference voltage pin
      pinSpareTemp1 = A17; //spare Analog input 1
      pinLaunch = A15; //Can be overwritten below
      pinTachOut = 5; //Tacho output pin
      pinIdle1 = 27; //Single wire idle control
      pinIdle2 = 29; //2 wire idle control. Shared with Spare 1 output
      pinFuelPump = 8; //Fuel pump output
      pinVVT_1 = 28; //Default VVT output
      pinStepperDir = 32; //Direction pin  for DRV8825 driver
      pinStepperStep = 31; //Step pin for DRV8825 driver
      pinStepperEnable = 30; //Enable pin for DRV8825 driver
      pinBoost = 24; //Boost control
      pinSpareLOut1 = 29; //low current output spare1
      pinSpareLOut2 = 26; //low current output spare2
      pinSpareLOut3 = 28; //low current output spare3
      pinSpareLOut4 = 29; //low current output spare4
      pinFan = 25; //Pin for the fan output
      pinResetControl = 46; //Reset control output PLACEHOLDER value for now

      //CS pin number is now set in a compile flag. 
      // #ifdef USE_SPI_EEPROM
      //   pinSPIFlash_CS = 6;
      // #endif

      #if defined(CORE_TEENSY35)
        pinTPS = A22; //TPS input pin
        pinIAT = A19; //IAT sensor pin
        pinCLT = A20; //CLS sensor pin
        pinO2 = A21; //O2 Sensor pin
        pinO2_2 = A18; //Spare 2
      #endif

      #if defined(CORE_TEENSY41)
        pinTPS = A17; //TPS input pin
        pinIAT = A14; //IAT sensor pin
        pinCLT = A15; //CLS sensor pin
        pinO2 = A16; //O2 Sensor pin
        pinBat = A3; //Battery reference voltage pin. Needs Alpha4+

        //New pins for the actual T4.1 version of the Dropbear
        pinBaro = A4; 
        pinMAP = A5;
        pinTPS = A3; //TPS input pin
        pinIAT = A0; //IAT sensor pin
        pinCLT = A1; //CLS sensor pin
        pinO2 = A2; //O2 Sensor pin
        pinBat = A15; //Battery reference voltage pin. Needs Alpha4+
        pinLaunch = 36;
        pinFlex = 37; // Flex sensor
        pinSpareTemp1 = A16; 
        pinSpareTemp2 = A17;

        pinTrigger = 20; //The CAS pin
        pinTrigger2 = 21; //The Cam Sensor pin

        pinFuelPump = 5; //Fuel pump output
        pinTachOut = 8; //Tacho output pin

        pinResetControl = 49; //PLaceholder only. Cannot use 42-47 as these are the SD card

        //CS pin number is now set in a compile flag. 
        // #ifdef USE_SPI_EEPROM
        //   pinSPIFlash_CS = 33;
        // #endif

      #endif

        pinMC33810_1_CS = 10;
        pinMC33810_2_CS = 9;

      //Pin alignment to the MC33810 outputs
      MC33810_BIT_INJ1 = 3;
      MC33810_BIT_INJ2 = 1;
      MC33810_BIT_INJ3 = 0;
      MC33810_BIT_INJ4 = 2;
      MC33810_BIT_IGN1 = 4;
      MC33810_BIT_IGN2 = 5;
      MC33810_BIT_IGN3 = 6;
      MC33810_BIT_IGN4 = 7;

      MC33810_BIT_INJ5 = 3;
      MC33810_BIT_INJ6 = 1;
      MC33810_BIT_INJ7 = 0;
      MC33810_BIT_INJ8 = 2;
      MC33810_BIT_IGN5 = 4;
      MC33810_BIT_IGN6 = 5;
      MC33810_BIT_IGN7 = 6;
      MC33810_BIT_IGN8 = 7;



      #endif
      break;

    case 56:
      #if defined(CORE_TEENSY)
      //Pin mappings for the Bear Cub (Teensy 4.1)
      pinInjector1 = 6;
      pinInjector2 = 7;
      pinInjector3 = 9;
      pinInjector4 = 8;
      pinInjector5 = 0; //Not used
      pinCoil1 = 2;
      pinCoil2 = 3;
      pinCoil3 = 4;
      pinCoil4 = 5;

      pinTrigger = 20; //The CAS pin
      pinTrigger2 = 21; //The Cam Sensor pin
      pinFlex = 37; // Flex sensor
      pinMAP = A5; //MAP sensor pin
      pinBaro = A4; //Baro sensor pin
      pinBat = A15; //Battery reference voltage pin
      pinTPS = A3; //TPS input pin
      pinIAT = A0; //IAT sensor pin
      pinCLT = A1; //CLS sensor pin
      pinO2 = A2; //O2 Sensor pin
      pinLaunch = 36;

      pinSpareTemp1 = A16; //spare Analog input 1
      pinSpareTemp2 = A17; //spare Analog input 2
      pinTachOut = 38; //Tacho output pin
      pinIdle1 = 27; //Single wire idle control
      pinIdle2 = 26; //2 wire idle control. Shared with Spare 1 output
      pinFuelPump = 10; //Fuel pump output
      pinVVT_1 = 28; //Default VVT output
      pinStepperDir = 32; //Direction pin  for DRV8825 driver
      pinStepperStep = 31; //Step pin for DRV8825 driver
      pinStepperEnable = 30; //Enable pin for DRV8825 driver
      pinBoost = 24; //Boost control
      pinSpareLOut1 = 29; //low current output spare1
      pinSpareLOut2 = 26; //low current output spare2
      pinSpareLOut3 = 28; //low current output spare3
      pinSpareLOut4 = 29; //low current output spare4
      pinFan = 25; //Pin for the fan output
      pinResetControl = 46; //Reset control output PLACEHOLDER value for now

      #endif
      break;
    
 
    case 60:
        #if defined(STM32F407xx)
        //Pin definitions for experimental board Tjeerd 
        //Black F407VE wiki.stm32duino.com/index.php?title=STM32F407
        //https://github.com/Tjeerdie/SPECTRE/tree/master/SPECTRE_V0.5
        
        //******************************************
        //******** PORTA CONNECTIONS *************** 
        //******************************************
        // = PA0; //Wakeup ADC123
        // = PA1; //ADC123
        // = PA2; //ADC123
        // = PA3; //ADC123
        // = PA4; //ADC12
        // = PA5; //ADC12
        // = PA6; //ADC12 LED_BUILTIN_1
        // = PA7; //ADC12 LED_BUILTIN_2
        pinCoil3 = PA8;
        // = PA9;  //TXD1=Bluetooth module
        // = PA10; //RXD1=Bluetooth module
        // = PA11; //(DO NOT USE FOR SPEEDUINO) USB
        // = PA12; //(DO NOT USE FOR SPEEDUINO) USB 
        // = PA13;  //(DO NOT USE FOR SPEEDUINO) NOT ON GPIO - DEBUG ST-LINK
        // = PA14;  //(DO NOT USE FOR SPEEDUINO) NOT ON GPIO - DEBUG ST-LINK
        // = PA15;  //(DO NOT USE FOR SPEEDUINO) NOT ON GPIO - DEBUG ST-LINK

        //******************************************
        //******** PORTB CONNECTIONS *************** 
        //******************************************
        // = PB0;  //(DO NOT USE FOR SPEEDUINO) ADC123 - SPI FLASH CHIP CS pin
        pinBaro = PB1; //ADC12
        // = PB2;  //(DO NOT USE FOR SPEEDUINO) BOOT1 
        // = PB3;  //(DO NOT USE FOR SPEEDUINO) SPI1_SCK FLASH CHIP
        // = PB4;  //(DO NOT USE FOR SPEEDUINO) SPI1_MISO FLASH CHIP
        // = PB5;  //(DO NOT USE FOR SPEEDUINO) SPI1_MOSI FLASH CHIP
        // = PB6;  //NRF_CE
        // = PB7;  //NRF_CS
        // = PB8;  //NRF_IRQ
        pinCoil2 = PB9; //
        // = PB9;  //
        // = PB10; //TXD3
        // = PB11; //RXD3
        // = PB12; //
        // = PB13;  //SPI2_SCK
        // = PB14;  //SPI2_MISO
        // = PB15;  //SPI2_MOSI

        //******************************************
        //******** PORTC CONNECTIONS *************** 
        //******************************************
        pinIAT = PC0; //ADC123 
        pinTPS = PC1; //ADC123
        pinMAP = PC2; //ADC123 
        pinCLT = PC3; //ADC123
        pinO2 = PC4; //ADC12
        pinBat = PC5;  //ADC12
        pinBoost = PC6; //
        pinIdle1 = PC7; //
        // = PC8;  //(DO NOT USE FOR SPEEDUINO) - SDIO_D0
        // = PC9;  //(DO NOT USE FOR SPEEDUINO) - SDIO_D1
        // = PC10;  //(DO NOT USE FOR SPEEDUINO) - SDIO_D2
        // = PC11;  //(DO NOT USE FOR SPEEDUINO) - SDIO_D3
        // = PC12;  //(DO NOT USE FOR SPEEDUINO) - SDIO_SCK
        pinTachOut = PC13; //
        // = PC14;  //(DO NOT USE FOR SPEEDUINO) - OSC32_IN
        // = PC15;  //(DO NOT USE FOR SPEEDUINO) - OSC32_OUT

        //******************************************
        //******** PORTD CONNECTIONS *************** 
        //******************************************
        // = PD0;  //CANRX
        // = PD1;  //CANTX
        // = PD2;  //(DO NOT USE FOR SPEEDUINO) - SDIO_CMD
        pinIdle2 = PD3; //
        // = PD4;  //
        pinFlex = PD4;
        // = PD5; //TXD2
        // = PD6;  //RXD2
        pinCoil1 = PD7; //
        // = PD7;  //
        // = PD8;  //
        pinCoil5 = PD9;//
        pinCoil4 = PD10;//
        // = PD11;  //
        pinInjector1 = PD12; //
        pinInjector2 = PD13; //
        pinInjector3 = PD14; //
        pinInjector4 = PD15; //

        //******************************************
        //******** PORTE CONNECTIONS *************** 
        //******************************************
        pinTrigger = PE0; //
        pinTrigger2 = PE1; //
        pinStepperEnable = PE2; //
        pinFuelPump = PE3; //ONBOARD KEY1
        // = PE4;  //ONBOARD KEY2
        pinStepperStep = PE5; //
        pinFan = PE6; //
        pinStepperDir = PE7; //
        // = PE8;  //
        pinInjector5 = PE9; //
        // = PE10;  //
        pinInjector6 = PE11; //
        // = PE12; //
        pinInjector8 = PE13; //
        pinInjector7 = PE14; //
        // = PE15;  //
     #elif (defined(STM32F411xE) || defined(STM32F401xC))
        //pins PA12, PA11 are used for USB or CAN couldn't be used for GPIO
        //PB2 can't be used as input because is BOOT pin
        pinInjector1 = PB7; //Output pin injector 1 is on
        pinInjector2 = PB6; //Output pin injector 2 is on
        pinInjector3 = PB5; //Output pin injector 3 is on
        pinInjector4 = PB4; //Output pin injector 4 is on
        pinCoil1 = PB9; //Pin for coil 1
        pinCoil2 = PB8; //Pin for coil 2
        pinCoil3 = PB3; //Pin for coil 3
        pinCoil4 = PA15; //Pin for coil 4
        pinTPS = A2;//TPS input pin
        pinMAP = A3; //MAP sensor pin
        pinIAT = A0; //IAT sensor pin
        pinCLT = A1; //CLS sensor pin
        pinO2 = A8; //O2 Sensor pin
        pinBat = A4; //Battery reference voltage pin
        pinBaro = pinMAP;
        pinTachOut = PB1; //Tacho output pin  (Goes to ULN2803)
        pinIdle1 = PB2; //Single wire idle control
        pinIdle2 = PB10; //2 wire idle control
        pinBoost = PA6; //Boost control
        pinStepperDir = PB10; //Direction pin  for DRV8825 driver
        pinStepperStep = PB2; //Step pin for DRV8825 driver
        pinFuelPump = PA8; //Fuel pump output
        pinFan = PA5; //Pin for the fan output (Goes to ULN2803)

        //external interrupt enabled pins
        pinFlex = PC14; // Flex sensor (Must be external interrupt enabled)
        pinTrigger = PC13; //The CAS pin also led pin so bad idea
        pinTrigger2 = PC15; //The Cam Sensor pin

     #elif defined(CORE_STM32)
        //blue pill wiki.stm32duino.com/index.php?title=Blue_Pill
        //Maple mini wiki.stm32duino.com/index.php?title=Maple_Mini
        //pins PA12, PA11 are used for USB or CAN couldn't be used for GPIO
        //PB2 can't be used as input because is BOOT pin
        pinInjector1 = PB7; //Output pin injector 1 is on
        pinInjector2 = PB6; //Output pin injector 2 is on
        pinInjector3 = PB5; //Output pin injector 3 is on
        pinInjector4 = PB4; //Output pin injector 4 is on
        pinCoil1 = PB3; //Pin for coil 1
        pinCoil2 = PA15; //Pin for coil 2
        pinCoil3 = PA14; //Pin for coil 3
        pinCoil4 = PA9; //Pin for coil 4
        pinCoil5 = PA8; //Pin for coil 5
        pinTPS = A0; //TPS input pin
        pinMAP = A1; //MAP sensor pin
        pinIAT = A2; //IAT sensor pin
        pinCLT = A3; //CLS sensor pin
        pinO2 = A4; //O2 Sensor pin
        pinBat = A5; //Battery reference voltage pin
        pinBaro = pinMAP;
        pinIdle1 = PB2; //Single wire idle control
        pinIdle2 = PA2; //2 wire idle control
        pinBoost = PA1; //Boost control
        pinVVT_1 = PA0; //Default VVT output
        pinVVT_2 = PA2; //Default VVT2 output
        pinStepperDir = PC15; //Direction pin  for DRV8825 driver
        pinStepperStep = PC14; //Step pin for DRV8825 driver
        pinStepperEnable = PC13; //Enable pin for DRV8825
        pinDisplayReset = PB2; // OLED reset pin
        pinFan = PB1; //Pin for the fan output
        pinFuelPump = PB11; //Fuel pump output
        pinTachOut = PB10; //Tacho output pin
        //external interrupt enabled pins
        pinFlex = PB8; // Flex sensor (Must be external interrupt enabled)
        pinTrigger = PA10; //The CAS pin
        pinTrigger2 = PA13; //The Cam Sensor pin
      
    #endif
      break;
    default:
      #if defined(STM32F407xx)
      //Pin definitions for experimental board Tjeerd 
        //Black F407VE wiki.stm32duino.com/index.php?title=STM32F407

        //******************************************
        //******** PORTA CONNECTIONS *************** 
        //******************************************
        /* = PA0 */ //Wakeup ADC123
        // = PA1;
        // = PA2;
        // = PA3;
        // = PA4;
        /* = PA5; */ //ADC12
        pinFuelPump = PA6; //ADC12 LED_BUILTIN_1
        /* = PA7; */ //ADC12 LED_BUILTIN_2
        pinCoil3 = PA8;
        /* = PA9 */ //TXD1
        /* = PA10 */ //RXD1
        /* = PA11 */ //(DO NOT USE FOR SPEEDUINO) USB
        /* = PA12 */ //(DO NOT USE FOR SPEEDUINO) USB 
        /* = PA13 */ //(DO NOT USE FOR SPEEDUINO) NOT ON GPIO - DEBUG ST-LINK
        /* = PA14 */ //(DO NOT USE FOR SPEEDUINO) NOT ON GPIO - DEBUG ST-LINK
        /* = PA15 */ //(DO NOT USE FOR SPEEDUINO) NOT ON GPIO - DEBUG ST-LINK

        //******************************************
        //******** PORTB CONNECTIONS *************** 
        //******************************************
        /* = PB0; */ //(DO NOT USE FOR SPEEDUINO) ADC123 - SPI FLASH CHIP CS pin
        pinBaro = PB1; //ADC12
        /* = PB2; */ //(DO NOT USE FOR SPEEDUINO) BOOT1 
        /* = PB3; */ //(DO NOT USE FOR SPEEDUINO) SPI1_SCK FLASH CHIP
        /* = PB4; */ //(DO NOT USE FOR SPEEDUINO) SPI1_MISO FLASH CHIP
        /* = PB5; */ //(DO NOT USE FOR SPEEDUINO) SPI1_MOSI FLASH CHIP
        /* = PB6; */ //NRF_CE
        /* = PB7; */ //NRF_CS
        /* = PB8; */ //NRF_IRQ
        pinCoil2 = PB9; //
        /* = PB9; */ //
        pinCoil4 = PB10; //TXD3
        pinIdle1 = PB11; //RXD3
        pinIdle2 = PB12; //
        /* pinBoost = PB12; */ //
        /* = PB13; */ //SPI2_SCK
        /* = PB14; */ //SPI2_MISO
        /* = PB15; */ //SPI2_MOSI

        //******************************************
        //******** PORTC CONNECTIONS *************** 
        //******************************************
        pinMAP = PC0; //ADC123 
        pinTPS = PC1; //ADC123
        pinIAT = PC2; //ADC123
        pinCLT = PC3; //ADC123
        pinO2 = PC4; //ADC12
        pinBat = PC5; //ADC12
        /*pinVVT_1 = PC6; */ //
        pinDisplayReset = PC7; //
        /* = PC8; */ //(DO NOT USE FOR SPEEDUINO) - SDIO_D0
        /* = PC9; */ //(DO NOT USE FOR SPEEDUINO) - SDIO_D1
        /* = PC10; */ //(DO NOT USE FOR SPEEDUINO) - SDIO_D2
        /* = PC11; */ //(DO NOT USE FOR SPEEDUINO) - SDIO_D3
        /* = PC12; */ //(DO NOT USE FOR SPEEDUINO) - SDIO_SCK
        pinTachOut = PC13; //
        /* = PC14; */ //(DO NOT USE FOR SPEEDUINO) - OSC32_IN
        /* = PC15; */ //(DO NOT USE FOR SPEEDUINO) - OSC32_OUT

        //******************************************
        //******** PORTD CONNECTIONS *************** 
        //******************************************
        /* = PD0; */ //CANRX
        /* = PD1; */ //CANTX
        /* = PD2; */ //(DO NOT USE FOR SPEEDUINO) - SDIO_CMD
        /* = PD3; */ //
        /* = PD4; */ //
        pinFlex = PD4;
        /* = PD5;*/ //TXD2
        /* = PD6; */ //RXD2
        pinCoil1 = PD7; //
        /* = PD7; */ //
        /* = PD8; */ //
        pinCoil5 = PD9;//
        /* = PD10; */ //
        /* = PD11; */ //
        pinInjector1 = PD12; //
        pinInjector2 = PD13; //
        pinInjector3 = PD14; //
        pinInjector4 = PD15; //

        //******************************************
        //******** PORTE CONNECTIONS *************** 
        //******************************************
        pinTrigger = PE0; //
        pinTrigger2 = PE1; //
        pinStepperEnable = PE2; //
        /* = PE3; */ //ONBOARD KEY1
        /* = PE4; */ //ONBOARD KEY2
        pinStepperStep = PE5; //
        pinFan = PE6; //
        pinStepperDir = PE7; //
        /* = PE8; */ //
        /* = PE9; */ //
        /* = PE10; */ //
        pinInjector5 = PE11; //
        pinInjector6 = PE12; //
        /* = PE13; */ //
        /* = PE14; */ //
        /* = PE15; */ //
      #else
        #ifndef SMALL_FLASH_MODE //No support for bluepill here anyway
        //Pin mappings as per the v0.2 shield
        pinInjector1 = 8; //Output pin injector 1 is on
        pinInjector2 = 9; //Output pin injector 2 is on
        pinInjector3 = 10; //Output pin injector 3 is on
        pinInjector4 = 11; //Output pin injector 4 is on
        pinInjector5 = 12; //Output pin injector 5 is on
        pinCoil1 = 28; //Pin for coil 1
        pinCoil2 = 24; //Pin for coil 2
        pinCoil3 = 40; //Pin for coil 3
        pinCoil4 = 36; //Pin for coil 4
        pinCoil5 = 34; //Pin for coil 5 PLACEHOLDER value for now
        pinTrigger = 20; //The CAS pin
        pinTrigger2 = 21; //The Cam Sensor pin
        pinTPS = A2; //TPS input pin
        pinMAP = A3; //MAP sensor pin
        pinIAT = A0; //IAT sensor pin
        pinCLT = A1; //CLS sensor pin
        #ifdef A8 //Bit hacky, but needed for the atmega2561
        pinO2 = A8; //O2 Sensor pin
        #endif
        pinBat = A4; //Battery reference voltage pin
        pinStepperDir = 16; //Direction pin  for DRV8825 driver
        pinStepperStep = 17; //Step pin for DRV8825 driver
        pinDisplayReset = 48; // OLED reset pin
        pinFan = 47; //Pin for the fan output
        pinFuelPump = 4; //Fuel pump output
        pinTachOut = 49; //Tacho output pin
        pinFlex = 3; // Flex sensor (Must be external interrupt enabled)
        pinBoost = 5;
        pinIdle1 = 6;
        pinResetControl = 43; //Reset control output
        #endif
      #endif  
      break;
  }

  //Setup any devices that are using selectable pins

  if ( (configPage6.launchPin != 0) && (configPage6.launchPin < BOARD_MAX_IO_PINS) ) { pinLaunch = pinTranslate(configPage6.launchPin); }
  if ( (configPage4.ignBypassPin != 0) && (configPage4.ignBypassPin < BOARD_MAX_IO_PINS) ) { pinIgnBypass = pinTranslate(configPage4.ignBypassPin); }
  if ( (configPage2.tachoPin != 0) && (configPage2.tachoPin < BOARD_MAX_IO_PINS) ) { pinTachOut = pinTranslate(configPage2.tachoPin); }
  if ( (configPage4.fuelPumpPin != 0) && (configPage4.fuelPumpPin < BOARD_MAX_IO_PINS) ) { pinFuelPump = pinTranslate(configPage4.fuelPumpPin); }
  if ( (configPage6.fanPin != 0) && (configPage6.fanPin < BOARD_MAX_IO_PINS) ) { pinFan = pinTranslate(configPage6.fanPin); }
  if ( (configPage6.boostPin != 0) && (configPage6.boostPin < BOARD_MAX_IO_PINS) ) { pinBoost = pinTranslate(configPage6.boostPin); }
  if ( (configPage6.vvt1Pin != 0) && (configPage6.vvt1Pin < BOARD_MAX_IO_PINS) ) { pinVVT_1 = pinTranslate(configPage6.vvt1Pin); }
  if ( (configPage6.useExtBaro != 0) && (configPage6.baroPin < BOARD_MAX_IO_PINS) ) { pinBaro = pinTranslateAnalog(configPage6.baroPin); }
  if ( (configPage6.useEMAP != 0) && (configPage10.EMAPPin < BOARD_MAX_IO_PINS) ) { pinEMAP = pinTranslateAnalog(configPage10.EMAPPin); }
  if ( (configPage10.fuel2InputPin != 0) && (configPage10.fuel2InputPin < BOARD_MAX_IO_PINS) ) { pinFuel2Input = pinTranslate(configPage10.fuel2InputPin); }
  if ( (configPage10.spark2InputPin != 0) && (configPage10.spark2InputPin < BOARD_MAX_IO_PINS) ) { pinSpark2Input = pinTranslate(configPage10.spark2InputPin); }
  if ( (configPage2.vssPin != 0) && (configPage2.vssPin < BOARD_MAX_IO_PINS) ) { pinVSS = pinTranslate(configPage2.vssPin); }
  if ( (configPage10.fuelPressureEnable) && (configPage10.fuelPressurePin < BOARD_MAX_IO_PINS) ) { pinFuelPressure = pinTranslateAnalog(configPage10.fuelPressurePin); }
  if ( (configPage10.oilPressureEnable) && (configPage10.oilPressurePin < BOARD_MAX_IO_PINS) ) { pinOilPressure = pinTranslateAnalog(configPage10.oilPressurePin); }
  
  if ( (configPage10.wmiEmptyPin != 0) && (configPage10.wmiEmptyPin < BOARD_MAX_IO_PINS) ) { pinWMIEmpty = pinTranslate(configPage10.wmiEmptyPin); }
  if ( (configPage10.wmiIndicatorPin != 0) && (configPage10.wmiIndicatorPin < BOARD_MAX_IO_PINS) ) { pinWMIIndicator = pinTranslate(configPage10.wmiIndicatorPin); }
  if ( (configPage10.wmiEnabledPin != 0) && (configPage10.wmiEnabledPin < BOARD_MAX_IO_PINS) ) { pinWMIEnabled = pinTranslate(configPage10.wmiEnabledPin); }
  if ( (configPage10.vvt2Pin != 0) && (configPage10.vvt2Pin < BOARD_MAX_IO_PINS) ) { pinVVT_2 = pinTranslate(configPage10.vvt2Pin); }
  if ( (configPage13.onboard_log_trigger_Epin != 0 ) && (configPage13.onboard_log_trigger_Epin != 0) && (configPage13.onboard_log_tr5_Epin_pin < BOARD_MAX_IO_PINS) ) { pinSDEnable = pinTranslate(configPage13.onboard_log_tr5_Epin_pin); }
  

  //Currently there's no default pin for Idle Up
  
  pinIdleUp = pinTranslate(configPage2.idleUpPin);

  //Currently there's no default pin for Idle Up Output
  pinIdleUpOutput = pinTranslate(configPage2.idleUpOutputPin);

  //Currently there's no default pin for closed throttle position sensor
  pinCTPS = pinTranslate(configPage2.CTPSPin);
  
  // Air conditioning control initialisation
  if (((configPage15.airConCompPin&63) != 0) && ((configPage15.airConCompPin&63) < BOARD_MAX_IO_PINS) ) { pinAirConComp = pinTranslate(configPage15.airConCompPin&63); }
  if (((configPage15.airConFanPin&63) != 0) && ((configPage15.airConFanPin&63) < BOARD_MAX_IO_PINS) ) { pinAirConFan = pinTranslate(configPage15.airConFanPin&63); }
  if (((configPage15.airConReqPin&63) != 0) && ((configPage15.airConReqPin&63) < BOARD_MAX_IO_PINS) ) { pinAirConRequest = pinTranslate(configPage15.airConReqPin&63); }
  
  /* Reset control is a special case. If reset control is enabled, it needs its initial state set BEFORE its pinMode.
     If that doesn't happen and reset control is in "Serial Command" mode, the Arduino will end up in a reset loop
     because the control pin will go low as soon as the pinMode is set to OUTPUT. */
  if ( (configPage4.resetControlConfig != 0) && (configPage4.resetControlPin < BOARD_MAX_IO_PINS) )
  {
    resetControl = configPage4.resetControlConfig;
    pinResetControl = pinTranslate(configPage4.resetControlPin);
    setResetControlPinState();
    pinMode(pinResetControl, OUTPUT);
  }

  //Finally, set the relevant pin modes for outputs
  pinMode(pinTachOut, OUTPUT);
  pinMode(pinIdle1, OUTPUT);
  pinMode(pinIdle2, OUTPUT);
  pinMode(pinIdleUpOutput, OUTPUT);
  pinMode(pinFuelPump, OUTPUT);
  pinMode(pinIgnBypass, OUTPUT);
  pinMode(pinFan, OUTPUT);
  pinMode(pinStepperDir, OUTPUT);
  pinMode(pinStepperStep, OUTPUT);
  pinMode(pinStepperEnable, OUTPUT);
  pinMode(pinBoost, OUTPUT);
  pinMode(pinVVT_1, OUTPUT);
  pinMode(pinVVT_2, OUTPUT);

  //This is a legacy mode option to revert the MAP reading behaviour to match what was in place prior to the 201905 firmware
  if(configPage2.legacyMAP > 0) { digitalWrite(pinMAP, HIGH); }

  if(ignitionOutputControl == OUTPUT_CONTROL_DIRECT)
  {
    pinMode(pinCoil1, OUTPUT);
    pinMode(pinCoil2, OUTPUT);
    pinMode(pinCoil3, OUTPUT);
    pinMode(pinCoil4, OUTPUT);
    #if (IGN_CHANNELS >= 5)
    pinMode(pinCoil5, OUTPUT);
    #endif
    #if (IGN_CHANNELS >= 6)
    pinMode(pinCoil6, OUTPUT);
    #endif
    #if (IGN_CHANNELS >= 7)
    pinMode(pinCoil7, OUTPUT);
    #endif
    #if (IGN_CHANNELS >= 8)
    pinMode(pinCoil8, OUTPUT);
    #endif

    ign1_pin_port = portOutputRegister(digitalPinToPort(pinCoil1));
    ign1_pin_mask = digitalPinToBitMask(pinCoil1);
    ign2_pin_port = portOutputRegister(digitalPinToPort(pinCoil2));
    ign2_pin_mask = digitalPinToBitMask(pinCoil2);
    ign3_pin_port = portOutputRegister(digitalPinToPort(pinCoil3));
    ign3_pin_mask = digitalPinToBitMask(pinCoil3);
    ign4_pin_port = portOutputRegister(digitalPinToPort(pinCoil4));
    ign4_pin_mask = digitalPinToBitMask(pinCoil4);
    ign5_pin_port = portOutputRegister(digitalPinToPort(pinCoil5));
    ign5_pin_mask = digitalPinToBitMask(pinCoil5);
    ign6_pin_port = portOutputRegister(digitalPinToPort(pinCoil6));
    ign6_pin_mask = digitalPinToBitMask(pinCoil6);
    ign7_pin_port = portOutputRegister(digitalPinToPort(pinCoil7));
    ign7_pin_mask = digitalPinToBitMask(pinCoil7);
    ign8_pin_port = portOutputRegister(digitalPinToPort(pinCoil8));
    ign8_pin_mask = digitalPinToBitMask(pinCoil8);
  } 

  if(injectorOutputControl == OUTPUT_CONTROL_DIRECT)
  {
    pinMode(pinInjector1, OUTPUT);
    pinMode(pinInjector2, OUTPUT);
    pinMode(pinInjector3, OUTPUT);
    pinMode(pinInjector4, OUTPUT);
    #if (INJ_CHANNELS >= 5)
    pinMode(pinInjector5, OUTPUT);
    #endif
    #if (INJ_CHANNELS >= 6)
    pinMode(pinInjector6, OUTPUT);
    #endif
    #if (INJ_CHANNELS >= 7)
    pinMode(pinInjector7, OUTPUT);
    #endif
    #if (INJ_CHANNELS >= 8)
    pinMode(pinInjector8, OUTPUT);
    #endif
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
