oelprinz-org/BlitzboxBL49sp/(commit log)

2023-05-15 Update blitzbox_v0.1.9_cpl_2023-05-15.csv
    corrected placement of D2
    [blitzbox_v0.1.9_cpl_2023-05-15.csv]
2023-12-14 Enabled spare pins in pin layout
2024-07-22 Changed resistor values on Launch control Input (DISCO_IN)
    wasn't working as the resistor values were swapped.
    This led to a non-working input (pulldown to GND)
    [blitzbox_v0.1.9_bom_2023-05-15.csv]
2025-01-29 Update blitzbox_v0.1.9_bom_2025-01-08.csv
    changed value R41 from 10k to 100k
    voltage divider wasn't working properly with 10k/10k as this leads to voltage levels between 2,5 V and 5 V
    [blitzbox_v0.1.9_bom_2025-01-08.csv]
