oelprinz-org/BlitzboxBL49sp/(notices)

Notices in the files:
software/Onboard_WB_Lambda_V0.1.2_and_newer/Onboard_WB_Lambda_V0.1.2.ino:
work. If not, see <http://creativecommons.org/licenses/by-nc/4.0/>.
